hungmap0312/3D-Scanner/docs/logs/c5a_q6_20261004_221728/setup_tren.jpg

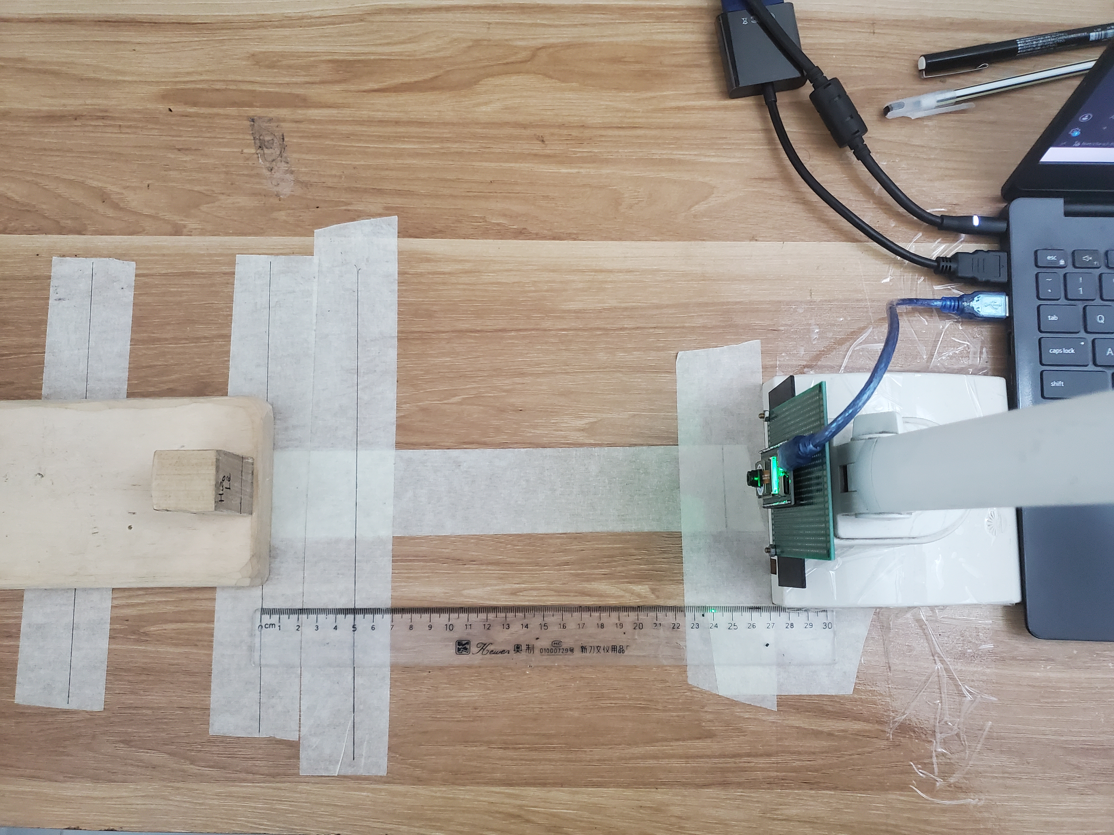
docs/logs/c5a_q6_20261004_221728/setup_tren.jpg
