hungmap0312/3D-Scanner/docs/logs/c5a_q6_rst_20261006_201614/setup.jpg

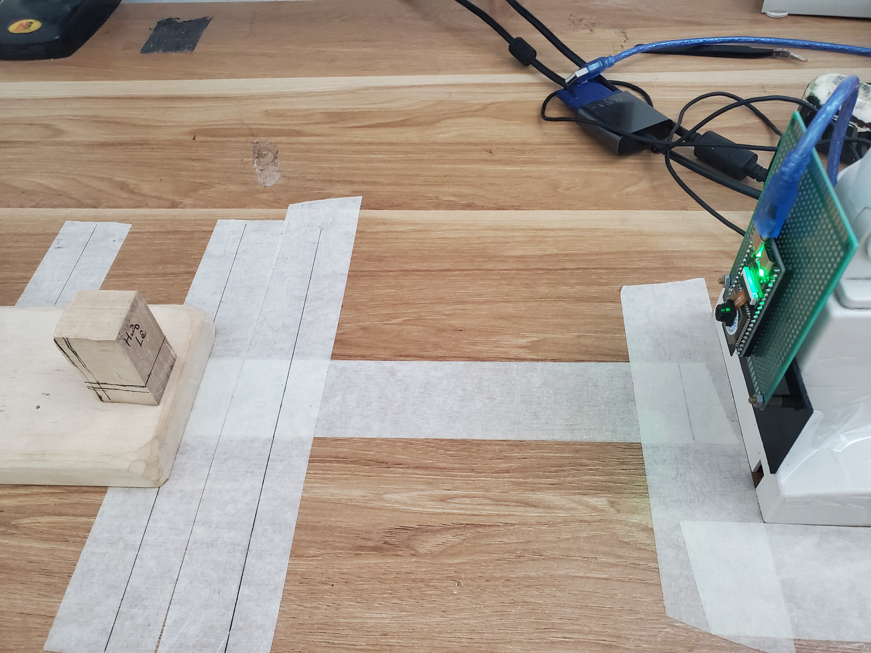
docs/logs/c5a_q6_rst_20261006_201614/setup.jpg
