hungmap0312/3D-Scanner/docs/logs/adapter-12v-3a-nhan-2026-10-11.jpg

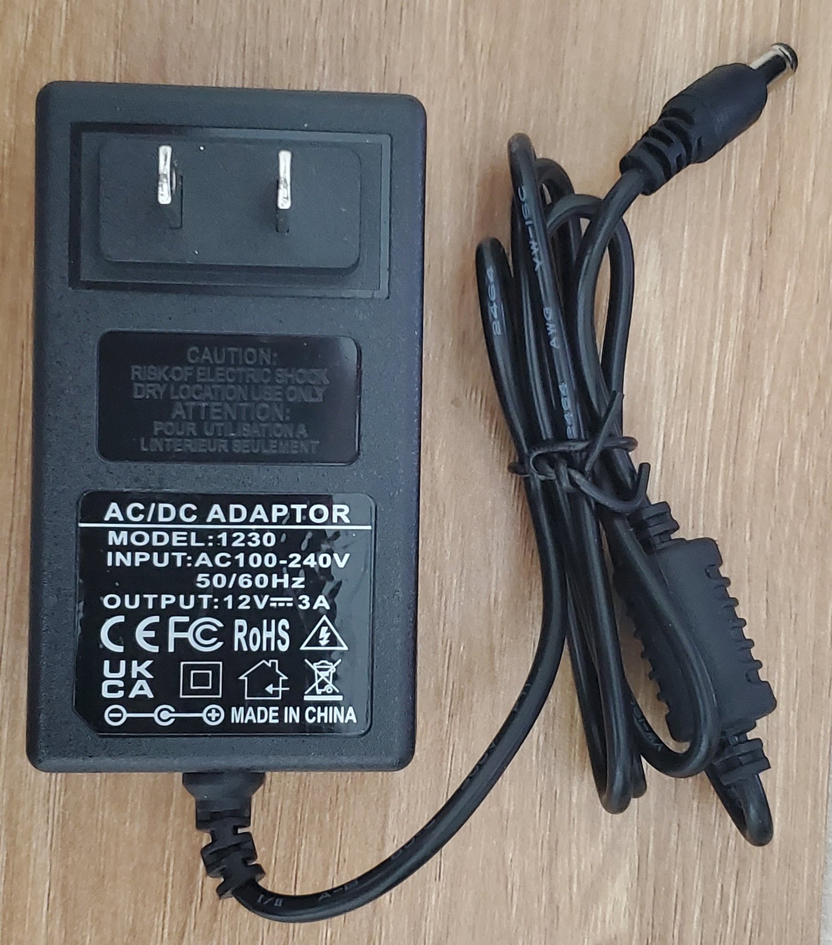
docs/logs/adapter-12v-3a-nhan-2026-10-11.jpg
