hungmap0312/3D-Scanner/docs/logs/arduino-tools-menu-2026-09-16.png

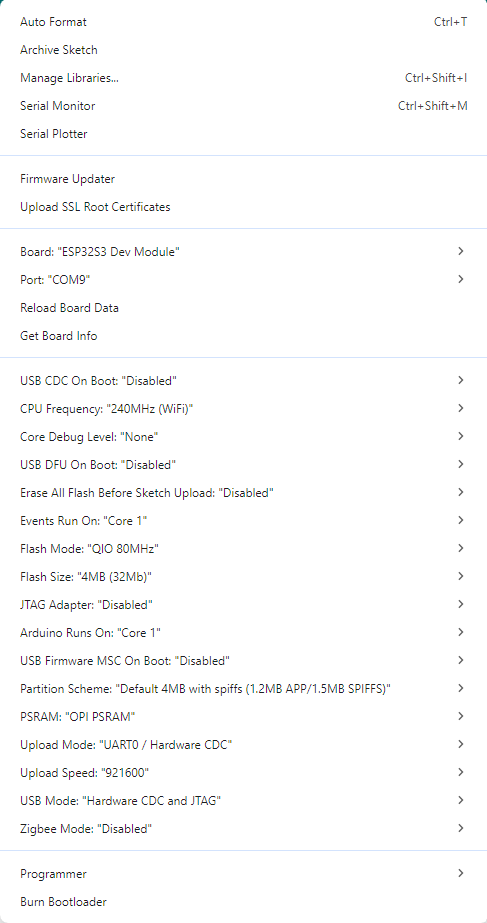
docs/logs/arduino-tools-menu-2026-09-16.png
