hungmap0312/3D-Scanner/docs/logs/buck-xl4005-mat-sau-2026-10-10.jpg

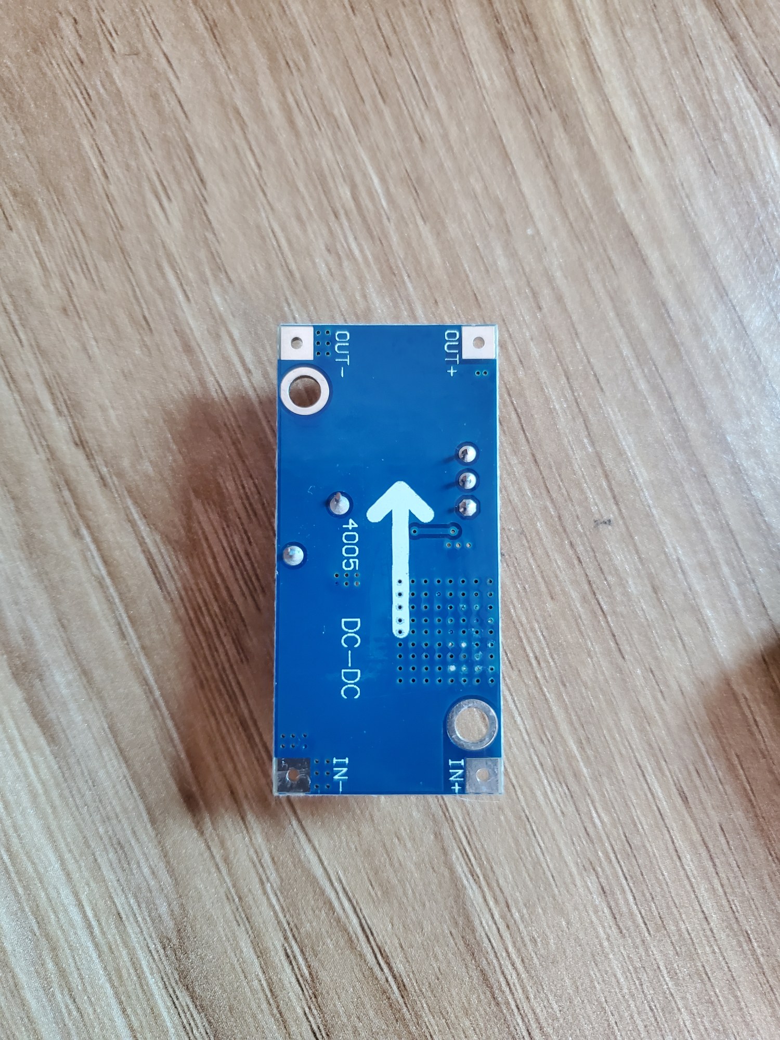
docs/logs/buck-xl4005-mat-sau-2026-10-10.jpg
