hungmap0312/3D-Scanner/docs/logs/buck-xl4005-mat-tren-2026-10-10.jpg

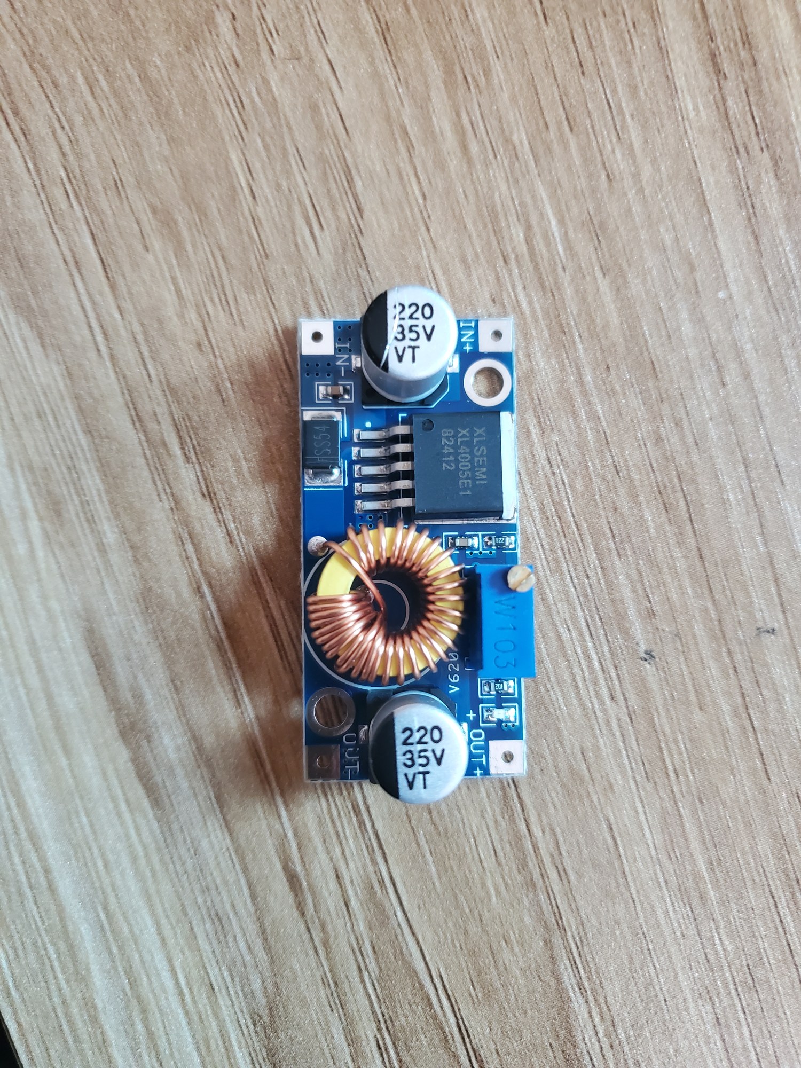
docs/logs/buck-xl4005-mat-tren-2026-10-10.jpg
