hungmap0312/3D-Scanner/docs/logs/c4-t5-2026-10-01/bo-tri-1.png

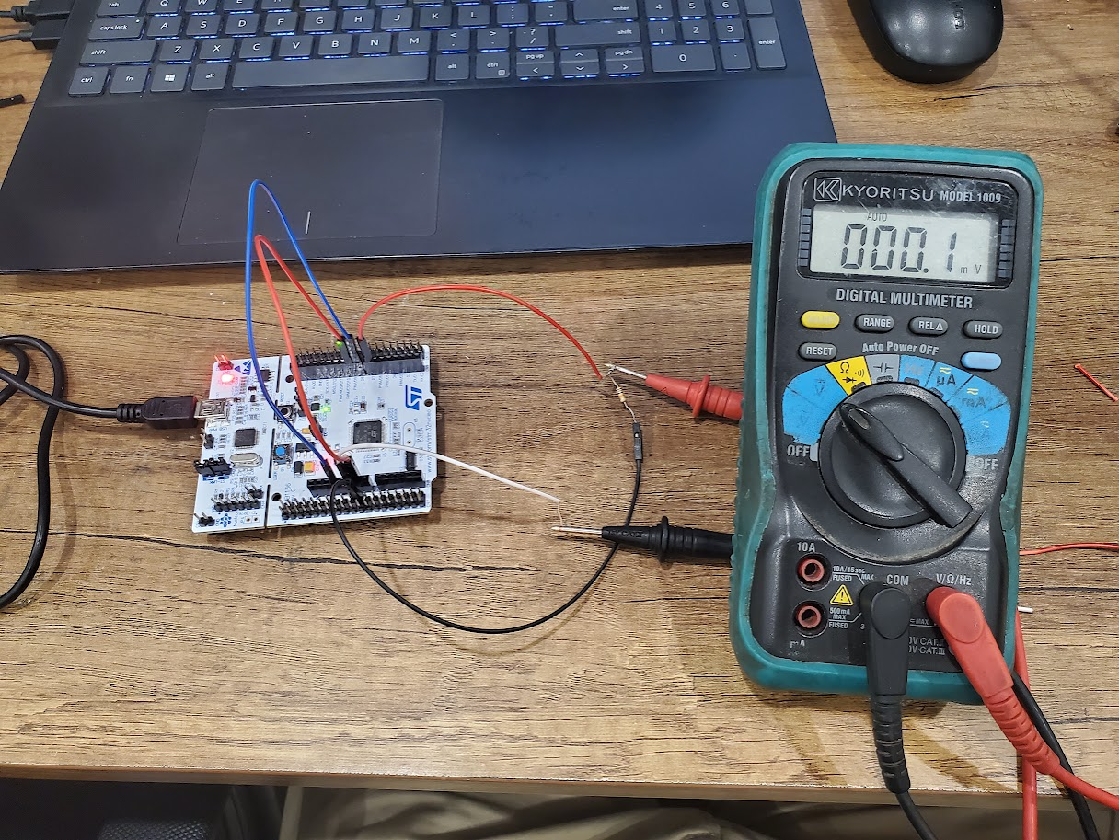
docs/logs/c4-t5-2026-10-01/bo-tri-1.png
