hungmap0312/3D-Scanner/docs/logs/c5a_q6_20261004_221728/probe_q6_t9_run1/frame_0009.jpg

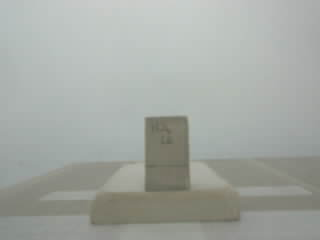
docs/logs/c5a_q6_20261004_221728/probe_q6_t9_run1/frame_0009.jpg
