hungmap0312/3D-Scanner/docs/logs/c5a_q6_20261004_225200/probe_q6_t10_reboot_run2/frame_0002.jpg

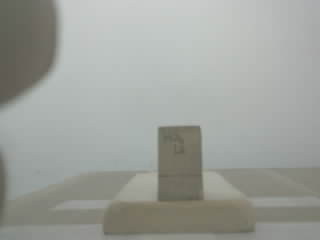
docs/logs/c5a_q6_20261004_225200/probe_q6_t10_reboot_run2/frame_0002.jpg
