hungmap0312/3D-Scanner/docs/logs/c5a_q6_rst_20261006_095924/probe_q6_t10_reboot_run1/frame_0001.jpg

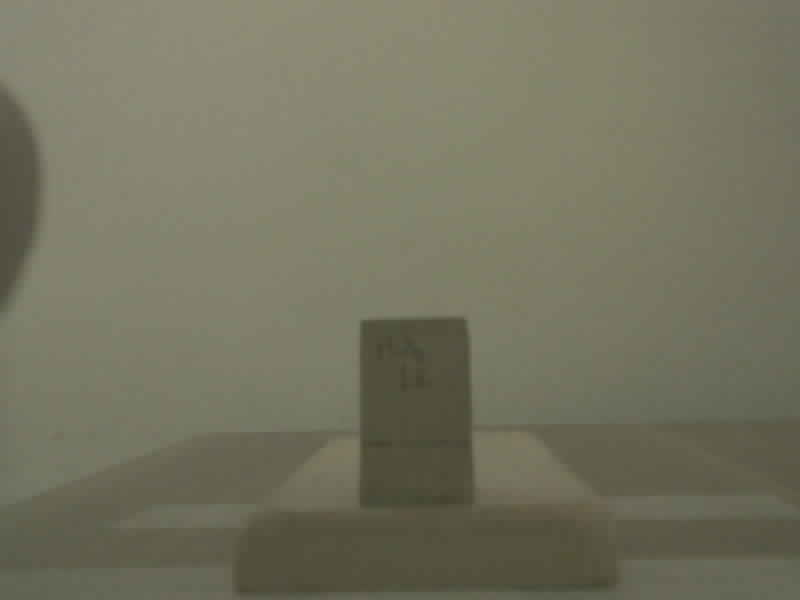
docs/logs/c5a_q6_rst_20261006_095924/probe_q6_t10_reboot_run1/frame_0001.jpg
