hungmap0312/3D-Scanner/docs/logs/c5a_q6_rst_20261006_201614/probe_q6_t10_reboot_run2/frame_0003.jpg

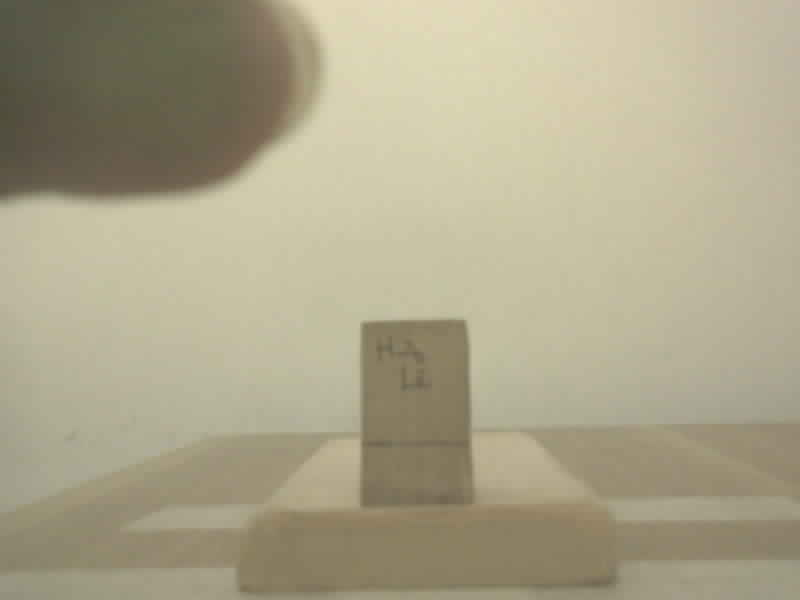
docs/logs/c5a_q6_rst_20261006_201614/probe_q6_t10_reboot_run2/frame_0003.jpg
