hungmap0312/3D-Scanner/docs/logs/c6-v4-ao3400-adapter-can-2026-10-07.png

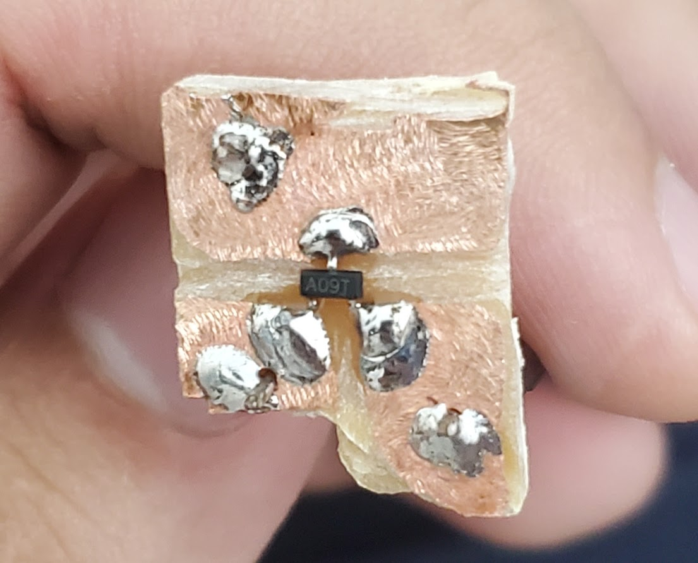
docs/logs/c6-v4-ao3400-adapter-can-2026-10-07.png
