hungmap0312/3D-Scanner/docs/logs/camera-fd5640-mat-sau-2026-09-22.jpg

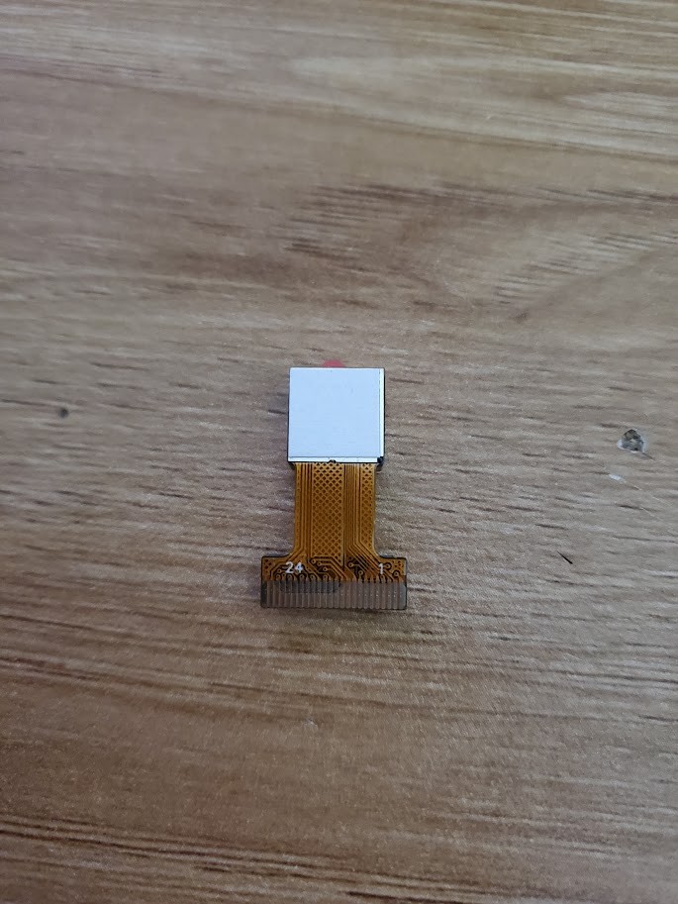
docs/logs/camera-fd5640-mat-sau-2026-09-22.jpg
