hungmap0312/3D-Scanner/docs/logs/esp32s3-ov3660-dau-noi-n0-2026-10-11.jpg

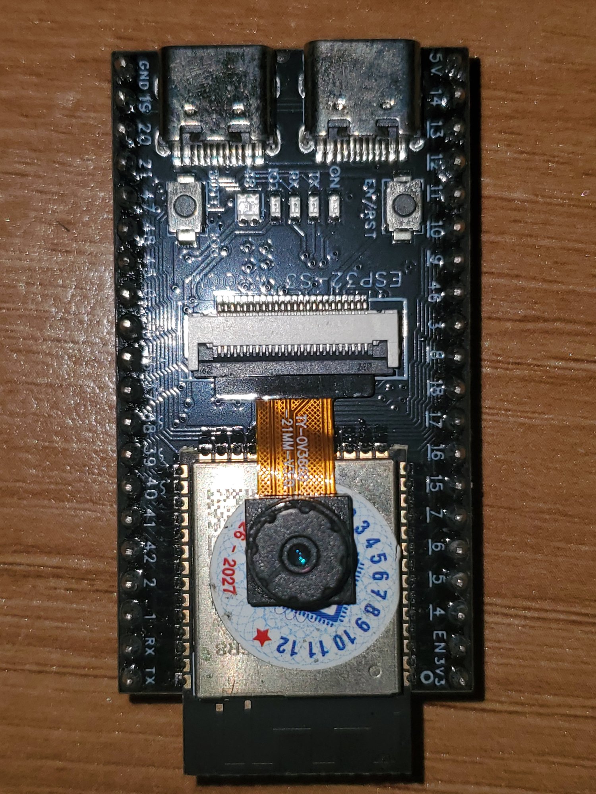
docs/logs/esp32s3-ov3660-dau-noi-n0-2026-10-11.jpg
