hungmap0312/3D-Scanner/docs/logs/estop-la38-vit-11-23-2026-10-12.jpg

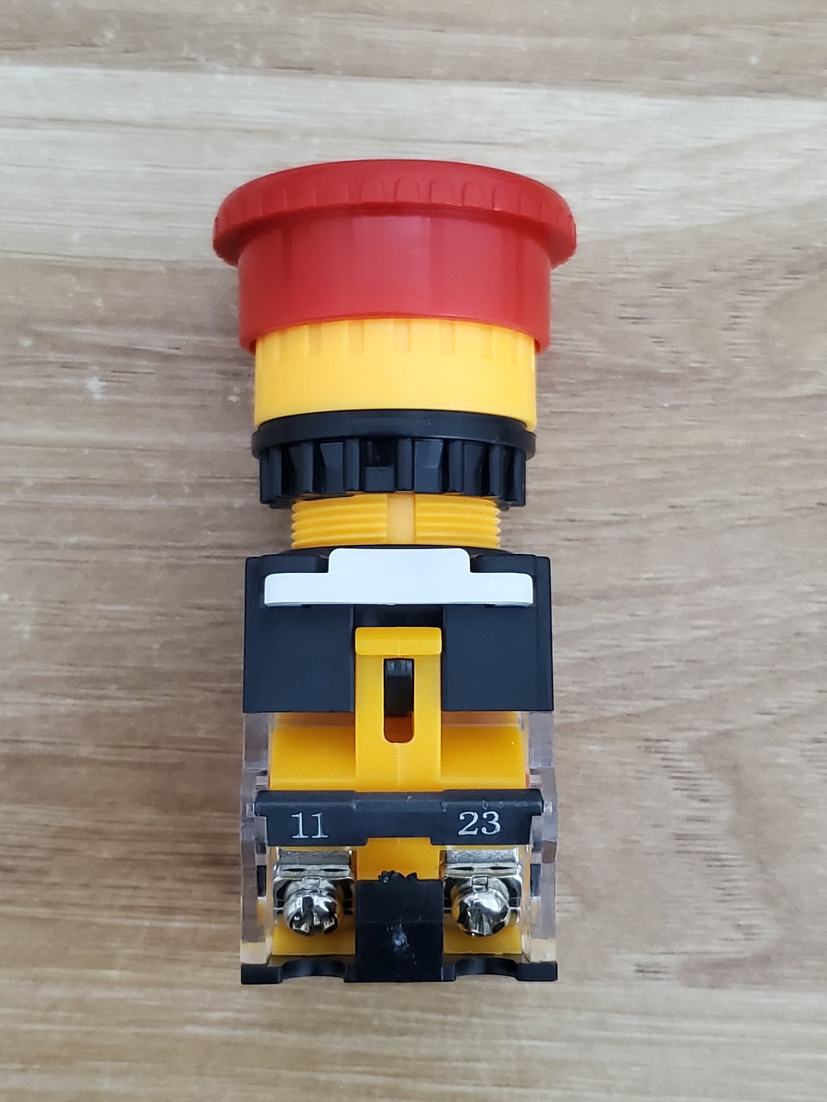
docs/logs/estop-la38-vit-11-23-2026-10-12.jpg
