hungmap0312/3D-Scanner/docs/logs/estop-la38-vit-24-12-2026-10-12.jpg

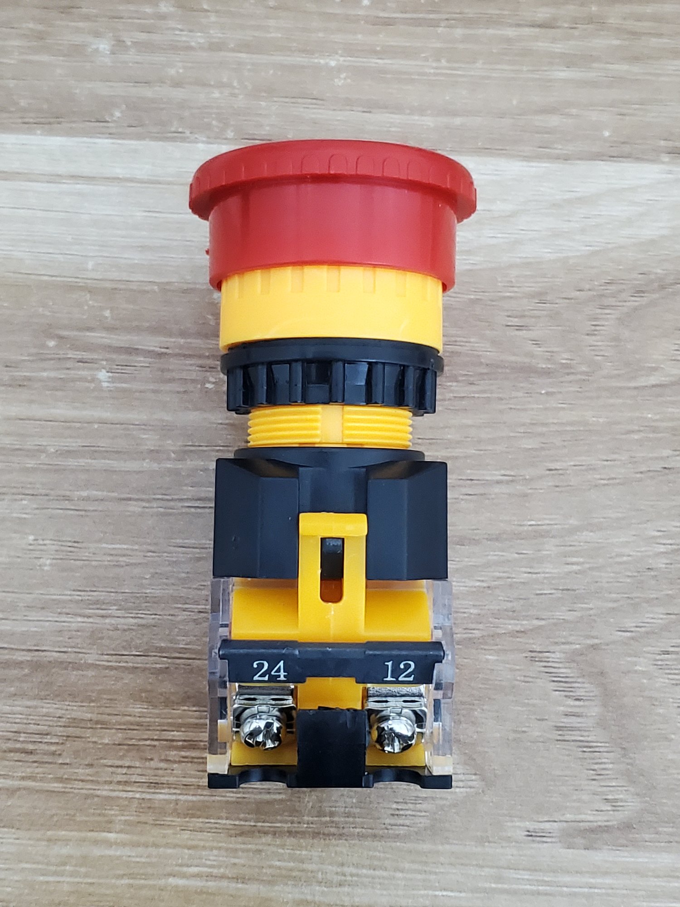
docs/logs/estop-la38-vit-24-12-2026-10-12.jpg
