hungmap0312/3D-Scanner/docs/logs/laser-syd1230-mach-trong-mat-b-2026-10-10.png

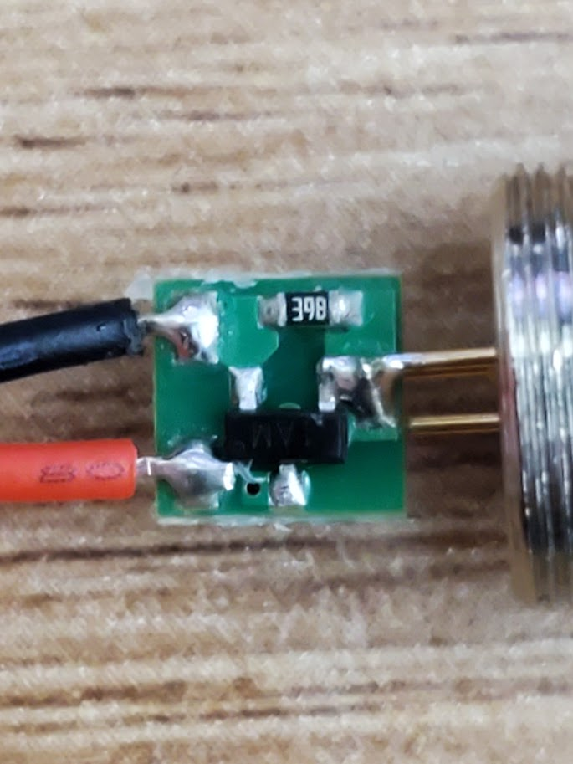
docs/logs/laser-syd1230-mach-trong-mat-b-2026-10-10.png
