hungmap0312/3D-Scanner/docs/logs/laser-syd1230-nhan-2026-09-22.jpg

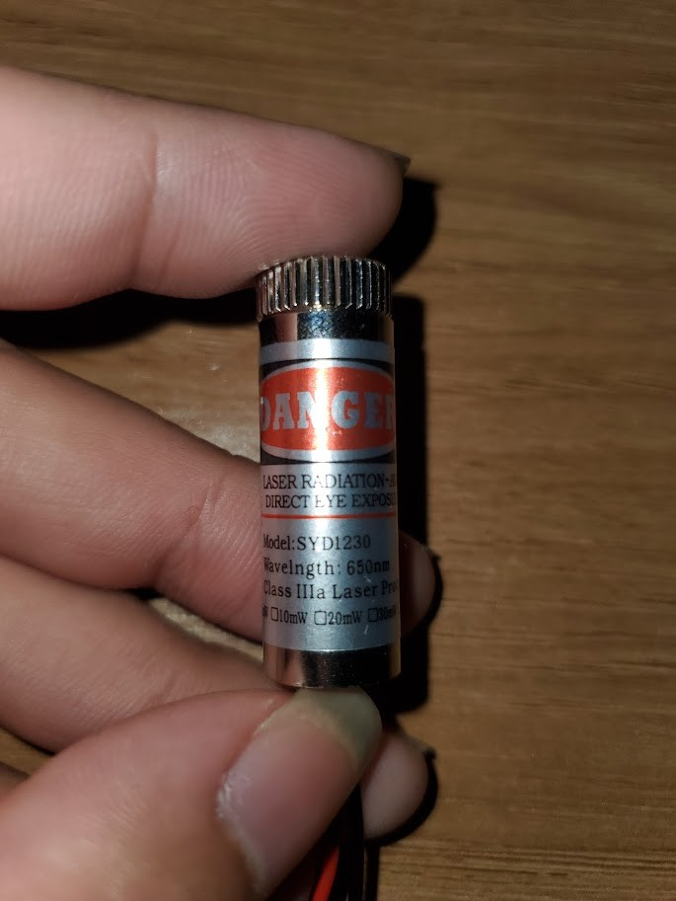
docs/logs/laser-syd1230-nhan-2026-09-22.jpg
