hungmap0312/3D-Scanner/docs/logs/nema17-42hd3401s-mat-bich-2026-10-11.jpg

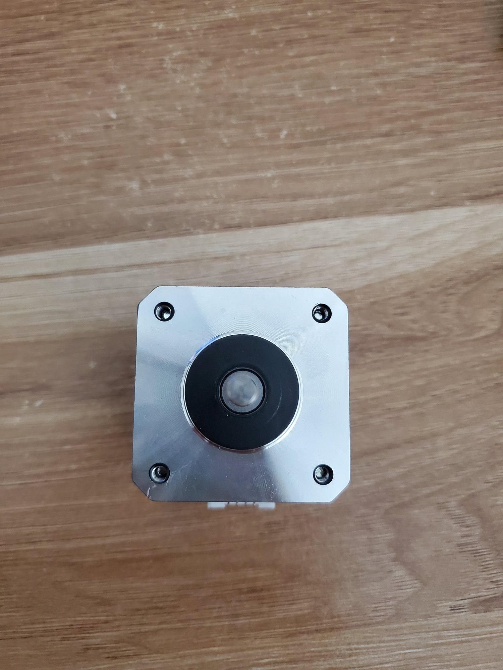
docs/logs/nema17-42hd3401s-mat-bich-2026-10-11.jpg
