hungmap0312/3D-Scanner/docs/logs/nucleo-board-2026-09-16.jpg

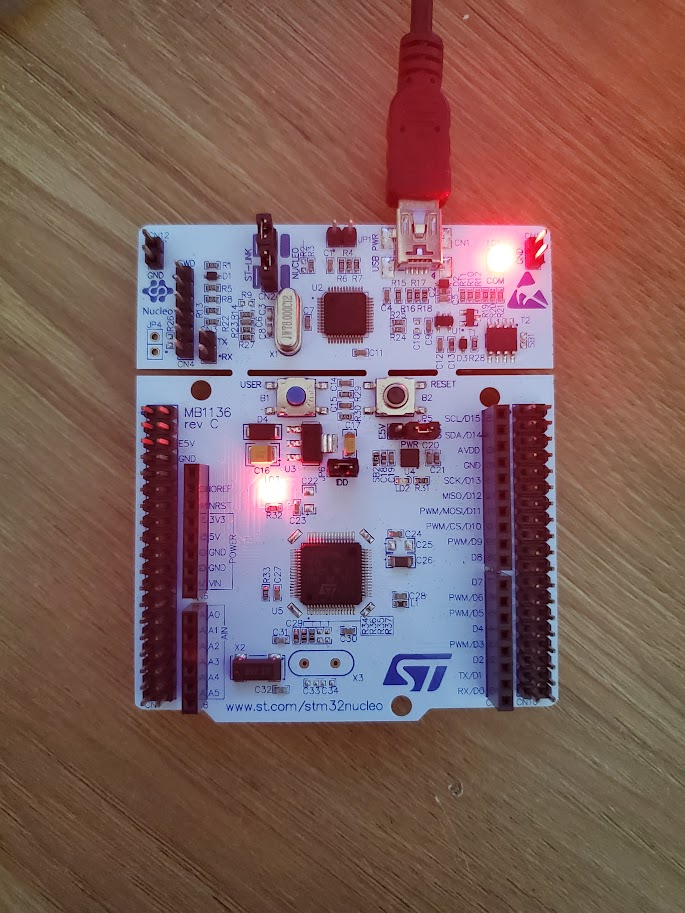
docs/logs/nucleo-board-2026-09-16.jpg
