hungmap0312/3D-Scanner/docs/logs/p03-bo-tri-250mm-2026-10-12.jpg

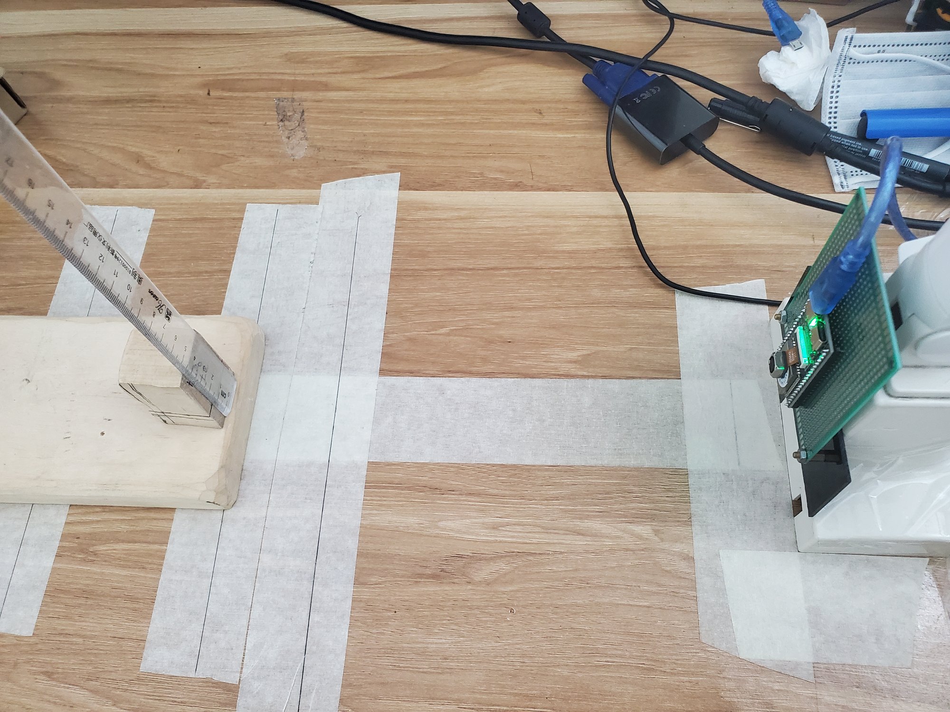
docs/logs/p03-bo-tri-250mm-2026-10-12.jpg
