hungmap0312/3D-Scanner/docs/logs/p03_fd5640/sharpness-v2-fd200/annotated_capture_fd5640_250mm.jpg

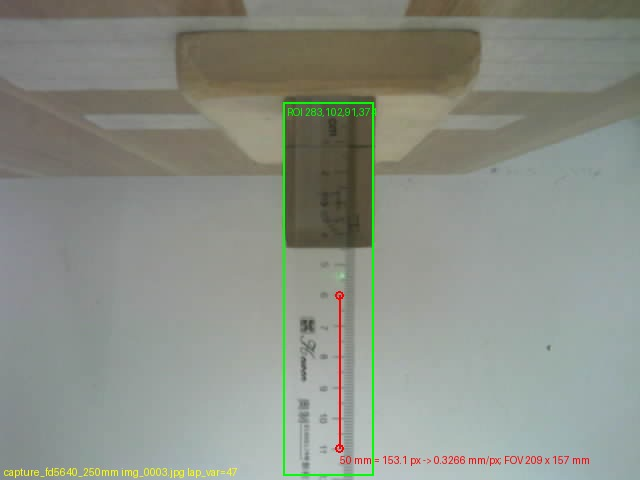
docs/logs/p03_fd5640/sharpness-v2-fd200/annotated_capture_fd5640_250mm.jpg
