hungmap0312/3D-Scanner/docs/logs/p03_fd5640/sharpness-v2-fd250-r1/annotated_capture_p03_fd5640_250mm_r1.jpg

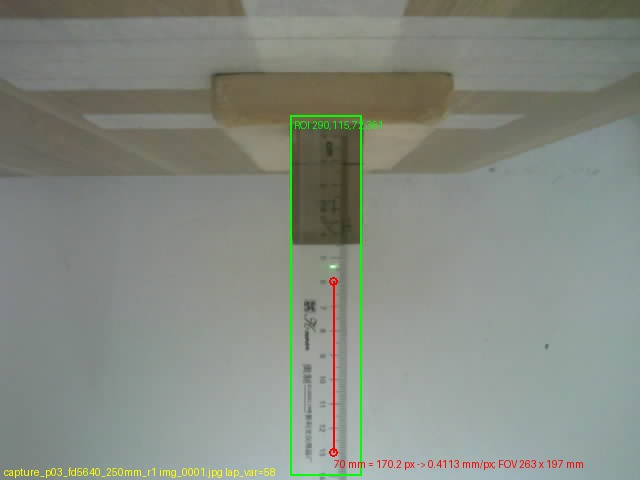
docs/logs/p03_fd5640/sharpness-v2-fd250-r1/annotated_capture_p03_fd5640_250mm_r1.jpg
