hungmap0312/3D-Scanner/docs/logs/p03_fd5640/v3/s2_mm_ticks_fd200.png

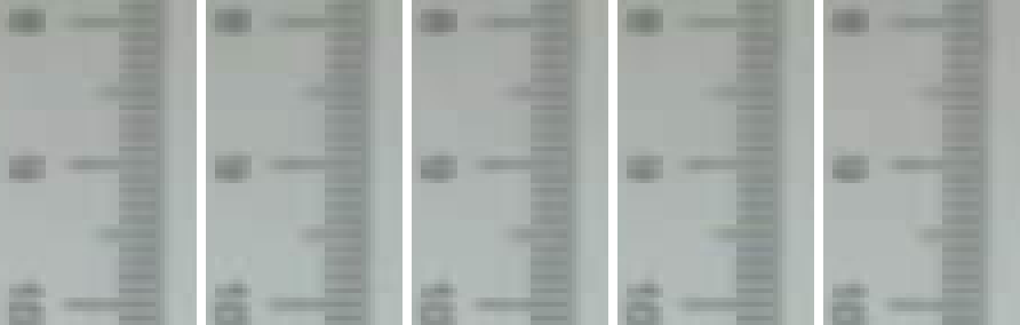
docs/logs/p03_fd5640/v3/s2_mm_ticks_fd200.png
