hungmap0312/3D-Scanner/docs/logs/p03_fd5640/v3/sharpness-v3-fd250-r4/annotated_capture_p03_fd5640_250mm_r4.jpg

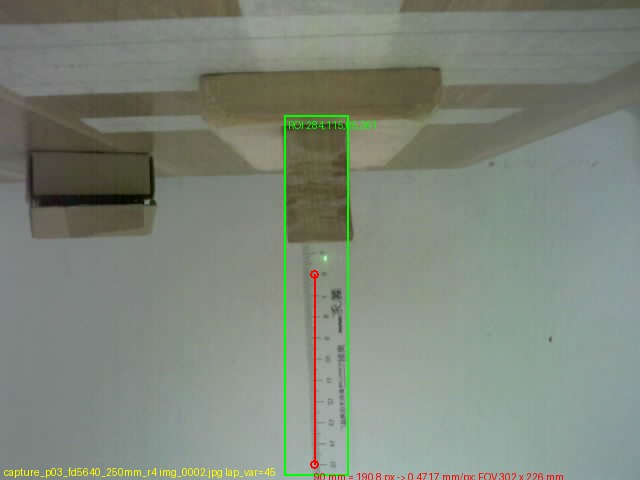
docs/logs/p03_fd5640/v3/sharpness-v3-fd250-r4/annotated_capture_p03_fd5640_250mm_r4.jpg
