hungmap0312/3D-Scanner/docs/logs/quang-hoc-2026-09-17-350mm-img0003.jpg

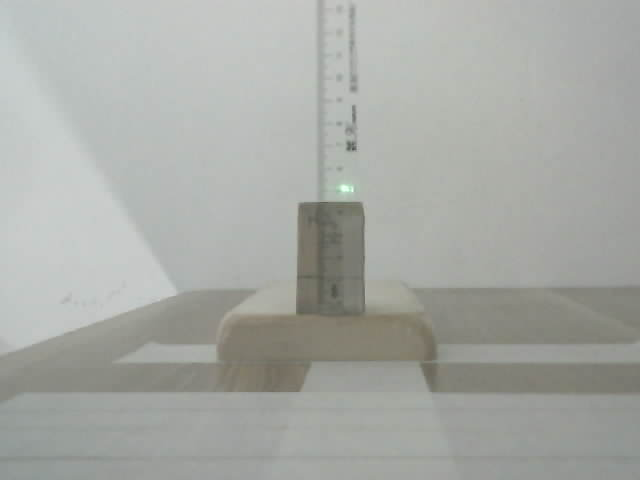
docs/logs/quang-hoc-2026-09-17-350mm-img0003.jpg
