hungmap0312/3D-Scanner/docs/logs/quang-hoc-bo-tri-2026-09-17-200.jpg

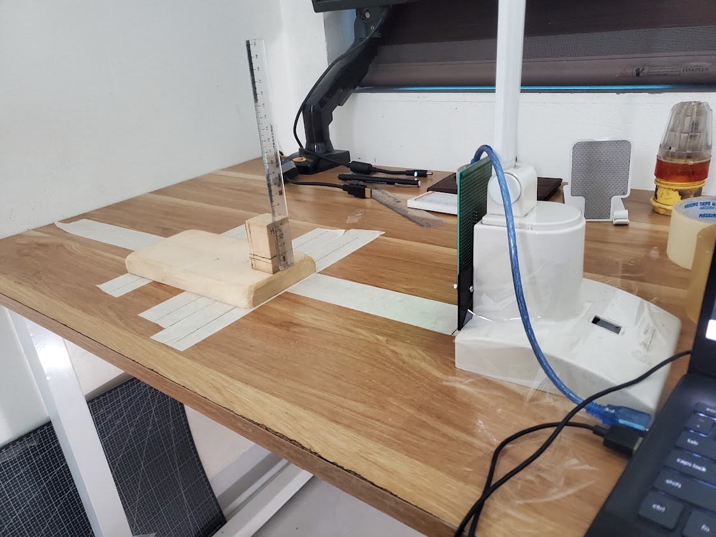
docs/logs/quang-hoc-bo-tri-2026-09-17-200.jpg
