hungmap0312/3D-Scanner/docs/logs/quang-hoc-bo-tri-2026-09-17-250.jpg

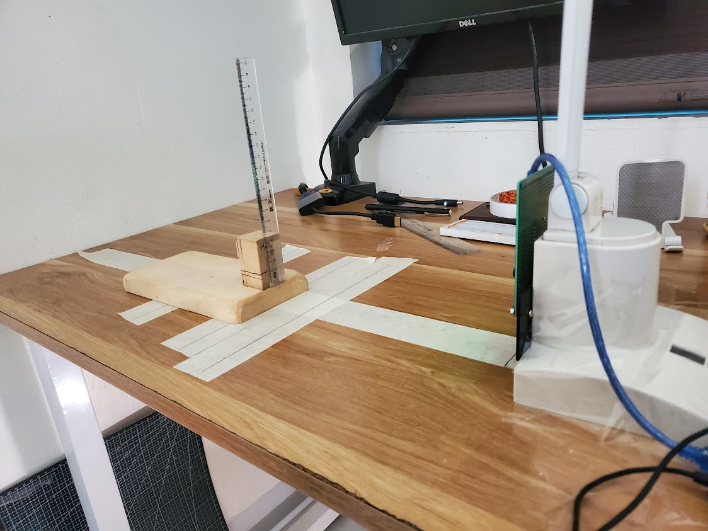
docs/logs/quang-hoc-bo-tri-2026-09-17-250.jpg
