hungmap0312/3D-Scanner/docs/logs/s3-board-back-2026-09-18.jpg

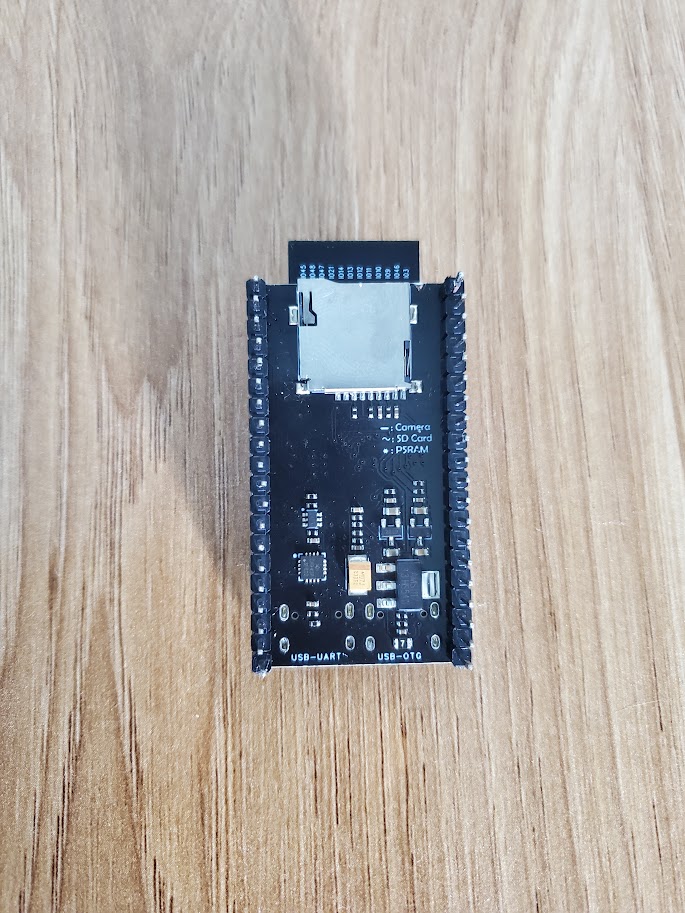
docs/logs/s3-board-back-2026-09-18.jpg
