hungmap0312/3D-Scanner/docs/logs/s3-board-front-2026-09-18.jpg

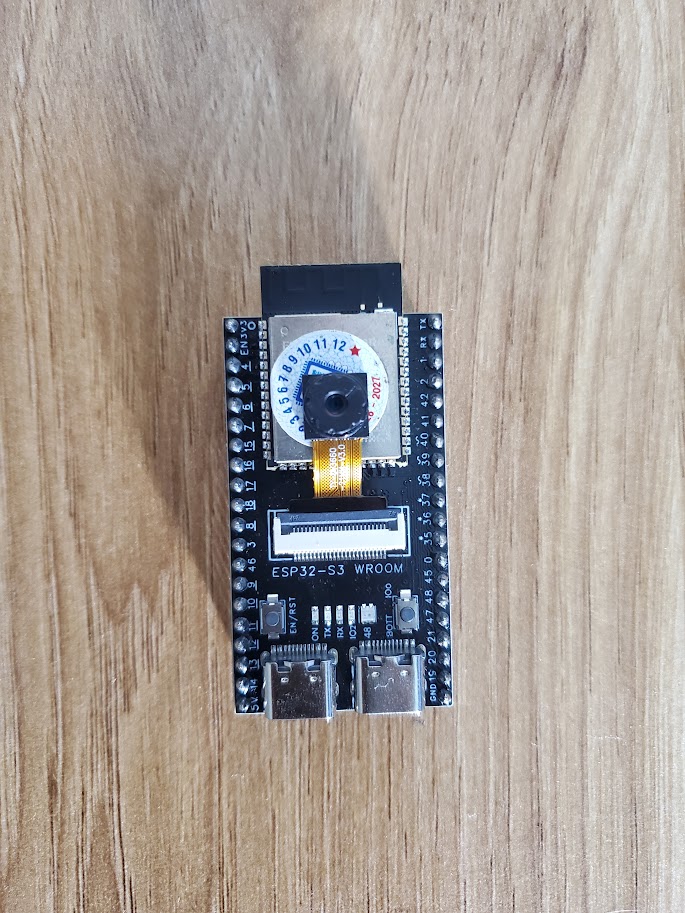
docs/logs/s3-board-front-2026-09-18.jpg
