hungmap0312/3D-Scanner/docs/logs/s3-board-mounted-2026-09-17.jpg

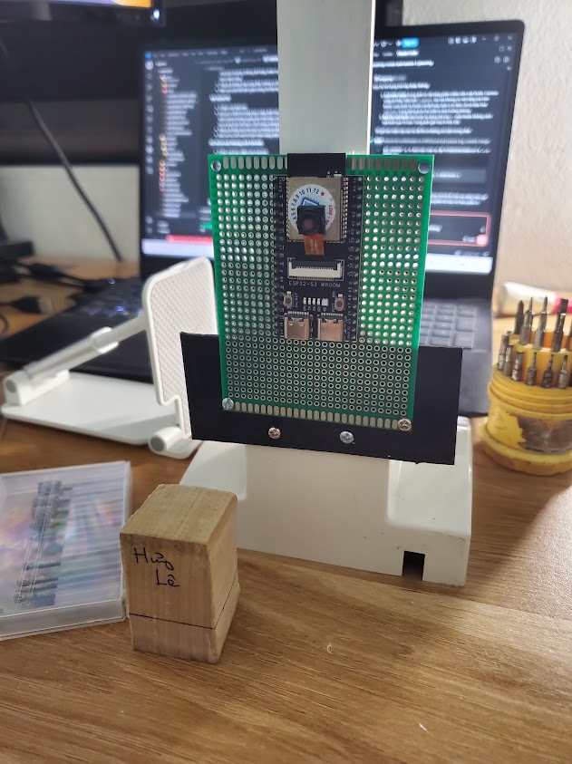
docs/logs/s3-board-mounted-2026-09-17.jpg
