hungmap0312/3D-Scanner/docs/logs/sharpness_20260916_thu_110anh/annotated_capture_20260916_154847.jpg

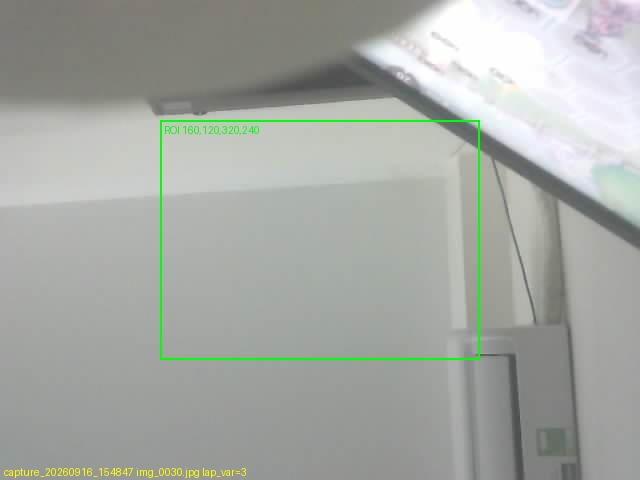
docs/logs/sharpness_20260916_thu_110anh/annotated_capture_20260916_154847.jpg
