hungmap0312/3D-Scanner/docs/logs/sharpness_20260917_quang_hoc/annotated_capture_qh_250mm.jpg

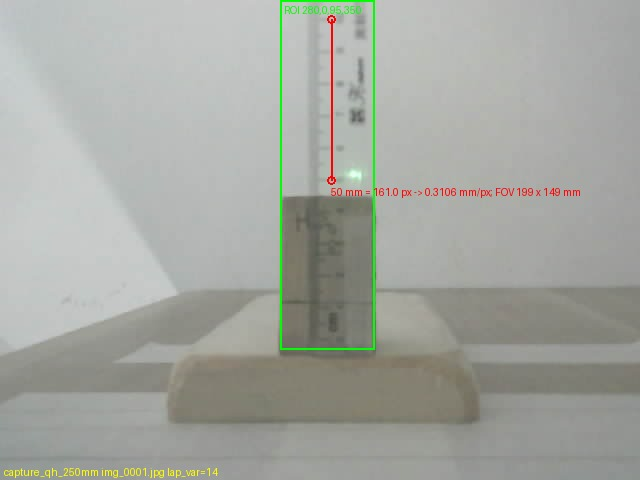
docs/logs/sharpness_20260917_quang_hoc/annotated_capture_qh_250mm.jpg
