hungmap0312/3D-Scanner/docs/logs/tro-2w-120r-2026-10-11.jpg

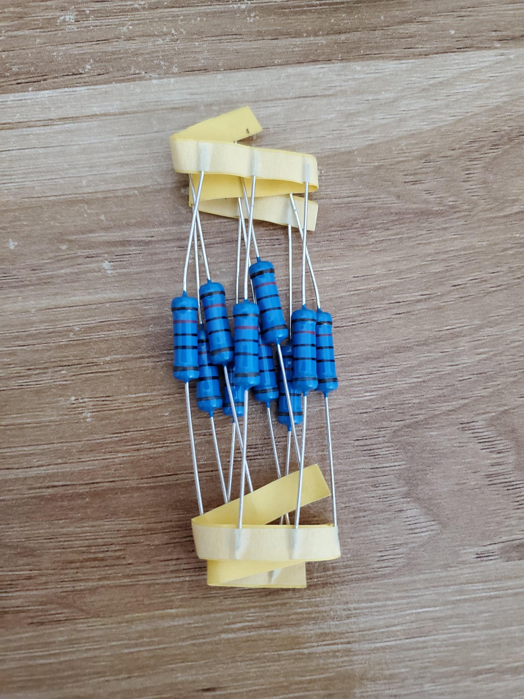
docs/logs/tro-2w-120r-2026-10-11.jpg
