hungmap0312/3D-Scanner/docs/logs/tro-quarterw-15k-2026-10-11.jpg

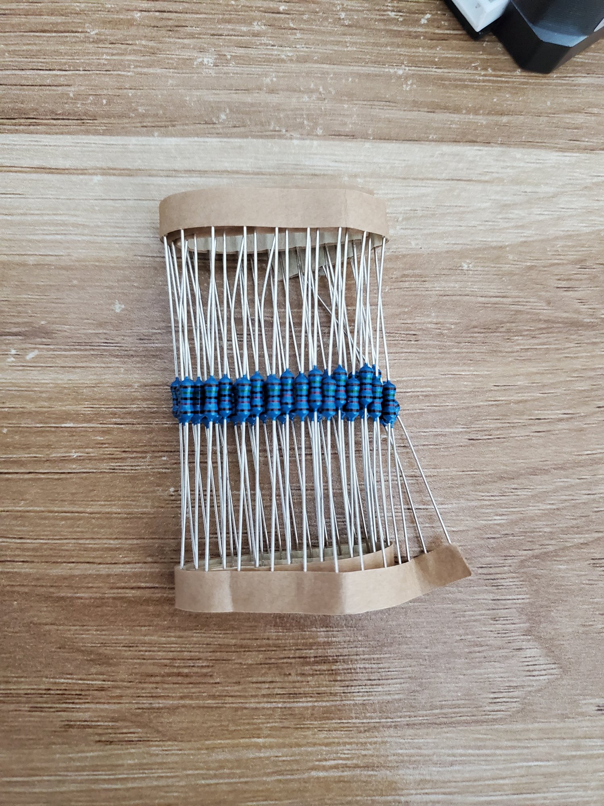
docs/logs/tro-quarterw-15k-2026-10-11.jpg
