hungmap0312/3D-Scanner/docs/reference/esp32-s3-wroom-cam-pinout-nguoi-ban-2026-09-18.webp

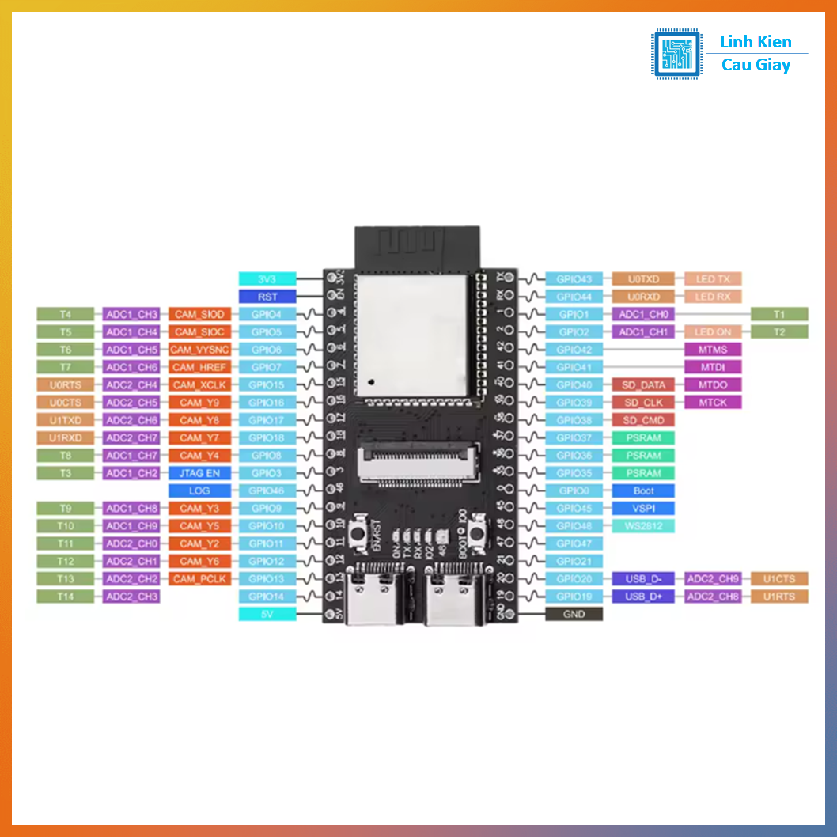
docs/reference/esp32-s3-wroom-cam-pinout-nguoi-ban-2026-09-18.webp
