hungmap0312/3D-Scanner/docs/reference/quy-trinh-rd-phan-cung-phan-mem-2021.png

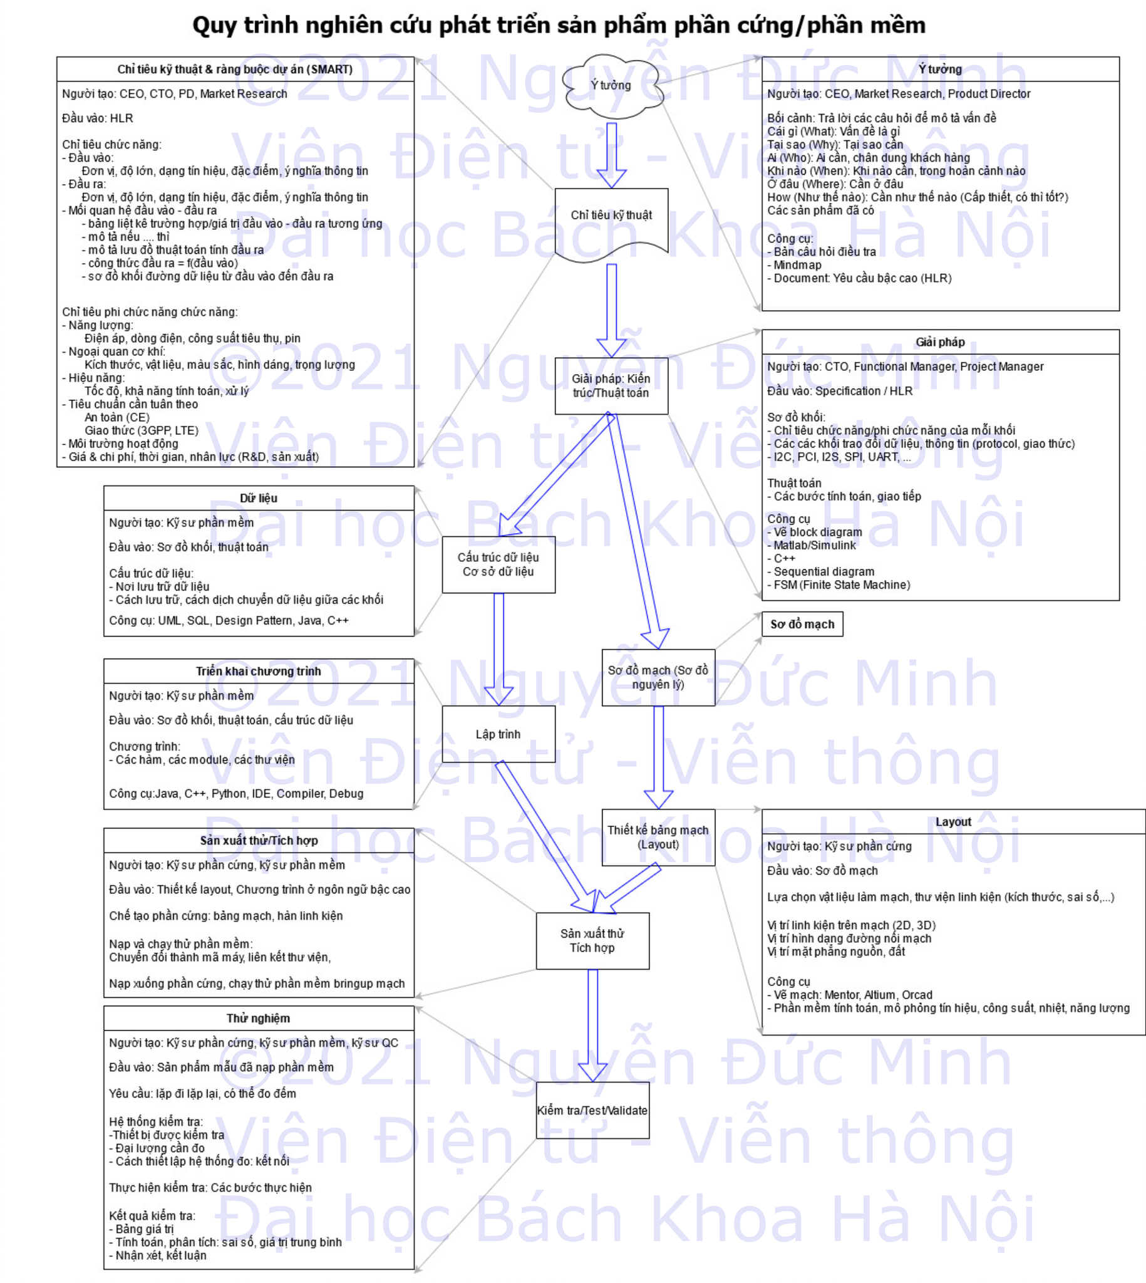
docs/reference/quy-trinh-rd-phan-cung-phan-mem-2021.png
