hungmap0312/3D-Scanner/docs/reference/BOM_may_quet_3D_ESP32_CAM_ESP32_S3.xlsx

Sheet: BOM
BOM máy quét 3D dùng ESP32-CAM / ESP32-S3
 | Cấu hình đang chọn: | ESP32-S3-CAM |  |  |  |  | 14/09/2026
 | Nhóm linh kiện |  |  |  |  | Dự toán (VND)
 | Camera và điều khiển |  |  |  |  | 480000
 | Nguồn điện |  |  |  |  | 250000
 | Cơ khí |  |  |  |  | 840000
 | PCB và hiệu chuẩn |  |  |  |  | 530000
 | Tổng linh kiện |  |  |  |  | 2100000
 | Dự phòng phát sinh |  |  |  | 15% | 315000
 | Vận chuyển dự kiến |  |  |  |  | 80000
 | Tổng ngân sách |  |  |  |  | 2495000
Một laser, đai 3:1, dựng 3D trên laptop. Giá dự toán làm tròn; các giả định/nguồn ở cột K và trang Chon bo.
Sửa SL/đơn giá ô vàng; giá khối camera sửa ở Chon bo. Tổng chưa gồm laptop, dụng cụ hàn/đo và phần tùy chọn.
Mã | Hạng mục | Thông số cần mua | SL | Đơn vị | Đơn giá (đ) | Thành tiền (đ) | Giai đoạn mua | Nguồn giá hoặc cơ sở dự toán; tra cứu ngày 13/09/2026
A01 | ESP32-S3-CAM + OV2640 + lens | S3-CAM N8R8/N16R8, PSRAM 8 MB, đủ OV2640/lens, USB nạp và sơ đồ chân. | 1 | bộ | 300000 | 300000 | 1. Thử ảnh | Nguồn và đơn giá đầu vào tại trang Chon bo.
A02 | Mạch nạp rời | ESP32-CAM: đế MB hoặc CP2102. S3-CAM đã có USB nạp: không mua mạch nạp rời. | 0 | cái | 0 | 0 | 1. Thử ảnh | Có CP2102 sẵn: đặt giá mạch nạp của ESP32-CAM về 0 tại Chon bo!D7.
A03 | Cáp USB truyền dữ liệu | Cáp truyền dữ liệu; đầu cáp khớp đế nạp hoặc USB trên bo S3. | 1 | sợi | 25000 | 25000 | 1. Thử ảnh | Dự toán cáp 25.000 đ; có sẵn cáp phù hợp thì đặt giá cáp ở Chon bo về 0.
A04 | Module laser vạch đỏ | 650 nm, cấp 3–5 V; có mạch hạn dòng. Ưu tiên vạch mảnh tại khoảng quét. | 1 | cái | 35000 | 35000 | 2. Thử vạch | Hshop HS0956: niêm yết 25.000 đ, công suất quảng cáo 5 mW; dự trù 35.000 đ. https://hshop.vn/mat-laser-duong-thang
A05 | Driver A4988 + tản nhiệt | Điều khiển STEP/DIR; VDD 3,3 V, VMOT 12 V; đặt giới hạn dòng theo motor. | 1 | bộ | 35000 | 35000 | 3. Bàn xoay | Đức Huy niêm yết 30.000 đ kèm tản nhiệt; dự trù 35.000 đ. https://dientuduchuy.com/products/a4988-stepper-driver-dieu-khien-dong-co-buoc-co-tan-nhiet
A06 | MOSFET và điện trở | AO3400A; R gate 100 Ω, kéo gate xuống 10 kΩ; thêm R kéo cho STEP/DIR/HOME. | 1 | gói | 20000 | 20000 | 2. Thử vạch | Dự toán kỹ thuật; chưa có báo giá cho đúng cấu hình.
A07 | Công tắc HOME | Microswitch có cần gạt; xác lập vị trí gốc, không đo góc liên tục. | 1 | cái | 10000 | 10000 | 3. Bàn xoay | Dự toán kỹ thuật; chưa có báo giá cho đúng cấu hình.
A08 | Công tắc cửa buồng | Đóng mạch khi cửa đóng; mở cửa ngắt nguồn laser bằng phần cứng. | 1 | cái | 20000 | 20000 | 2. Thử vạch | Dự toán kỹ thuật; chưa có báo giá cho đúng cấu hình.
A09 | Nút dừng tự giữ | Tiếp điểm NC, phù hợp tải DC; ngắt nhánh nguồn động lực/laser. | 1 | cái | 35000 | 35000 | 3. Bàn xoay | Dự toán kỹ thuật; chưa có báo giá cho đúng cấu hình.
B01 | Adapter 12 V / 3 A | Nguồn có vỏ kín, jack DC; cấp động cơ và bộ hạ áp. | 1 | cái | 120000 | 120000 | 2. Thử vạch | Dự toán kỹ thuật; chưa có báo giá cho đúng cấu hình.
B02 | Module hạ áp DC-DC | LM2596 hoặc tương đương; chỉnh 12 V xuống 5 V, kiểm tra tải ≥1 A liên tục. | 1 | cái | 35000 | 35000 | 2. Thử vạch | Dự toán kỹ thuật; chưa có báo giá cho đúng cấu hình.
B03 | Tụ lọc và tụ chống nhiễu | 100 µF/35 V gần VMOT; 470–1000 µF/10 V gần camera; 100 nF tại tải. | 1 | gói | 15000 | 15000 | 2. Thử vạch | Giá là dự toán. Khuyến nghị tụ VMOT từ Pololu: https://www.pololu.com/product/1182
B04 | Jack DC, công tắc, cầu chì | Jack DC khớp adapter; công tắc tổng, đế và cầu chì DC phù hợp dây/tải. | 1 | bộ | 30000 | 30000 | 2. Thử vạch | Dự toán kỹ thuật; chưa có báo giá cho đúng cấu hình.
B05 | Dây điện và vật tư đấu nối | Dây nguồn 22–24 AWG, dây tín hiệu, ống co nhiệt, dây rút; không dẫn dòng motor qua breadboard. | 1 | gói | 50000 | 50000 | 2. Thử vạch | Dự toán kỹ thuật; chưa có báo giá cho đúng cấu hình.
C01 | Động cơ NEMA17 | 1,8°/bước, 4 dây, trục 5 mm; đặt dòng A4988 ban đầu khoảng 0,6–0,9 A/pha rồi kiểm tra. | 1 | cái | 150000 | 150000 | 3. Bàn xoay | Dự toán kỹ thuật; chưa có báo giá cho đúng cấu hình.
C02 | Pulley chủ động GT2 | 20 răng, đai rộng 6 mm, lỗ trục 5 mm; có vít chặn. | 1 | cái | 15000 | 15000 | 3. Bàn xoay | Dự toán kỹ thuật; chưa có báo giá cho đúng cấu hình.
C03 | Pulley bị động GT2 | 60 răng, đai rộng 6 mm, lỗ trục 8 mm; có vít chặn. | 1 | cái | 40000 | 40000 | 3. Bàn xoay | Dự toán kỹ thuật; chưa có báo giá cho đúng cấu hình.
C04 | Đai GT2 vòng kín | Rộng 6 mm; chiều dài chọn sau khi chốt khoảng cách hai trục trong CAD. | 1 | sợi | 25000 | 25000 | 3. Bàn xoay | Dự toán kỹ thuật; chưa có báo giá cho đúng cấu hình.
C05 | Trục bàn xoay | Trục thép trơn Ø8 mm, dài dự kiến 100–150 mm; chốt chiều dài theo thiết kế. | 1 | cái | 20000 | 20000 | 3. Bàn xoay | Dự toán kỹ thuật; chưa có báo giá cho đúng cấu hình.
C06 | Gối bi KFL08 | Lỗ 8 mm; bố trí hai gối cách nhau để đỡ hướng kính và hạn chế lắc trục. | 2 | cái | 25000 | 50000 | 3. Bàn xoay | Dự toán kỹ thuật; chưa có báo giá cho đúng cấu hình.
C07 | Bích gắn mâm | Bích kẹp trục lỗ 8 mm, có lỗ bắt vít lên mâm; không phải khớp nối trục 5–8. | 1 | cái | 25000 | 25000 | 3. Bàn xoay | Dự toán kỹ thuật; chưa có báo giá cho đúng cấu hình.
C08 | Vòng chặn trục + long đen | Hai vòng chặn Ø8 mm; định vị dọc trục theo bản vẽ lắp. | 1 | bộ | 20000 | 20000 | 3. Bàn xoay | Dự toán kỹ thuật; chưa có báo giá cho đúng cấu hình.
C09 | Vòng bi chặn dọc trục | F8-16M hoặc tương đương lỗ 8 mm; cần mặt tựa cứng, giữ đúng thứ tự vòng đệm. | 1 | cái | 30000 | 30000 | 3. Bàn xoay | Dự toán kỹ thuật; chưa có báo giá cho đúng cấu hình.
C10 | Mâm xoay đen nhám | Đường kính khoảng 160 mm, gỗ/mica dày khoảng 6–8 mm; dán phủ mặt đen nhám. | 1 | cái | 45000 | 45000 | 3. Bàn xoay | Dự toán kỹ thuật; chưa có báo giá cho đúng cấu hình.
C11 | Gá động cơ NEMA17 | Gá chữ L có rãnh chỉnh căng đai; kích thước khớp động cơ. | 1 | cái | 30000 | 30000 | 3. Bàn xoay | Dự toán kỹ thuật; chưa có báo giá cho đúng cấu hình.
C12 | Gá camera, laser và gối bi | Tự gia công/in 3D; chỉnh được camera và laser rồi khóa cứng; chưa tính CAD thuê ngoài. | 1 | bộ | 100000 | 100000 | 3. Bàn xoay | Dự toán kỹ thuật; chưa có báo giá cho đúng cấu hình.
C13 | Đế máy cứng | Gỗ/MDF khoảng 400×400 mm, dày 12–15 mm; đặt camera, laser và bàn xoay chung đế. | 1 | tấm | 80000 | 80000 | 3. Bàn xoay | Dự toán kỹ thuật; chưa có báo giá cho đúng cấu hình.
C14 | Vỏ buồng kín và mặt chắn tia | Gỗ/foam PVC không xuyên sáng, trong đen nhám; chiều cao khoảng 350–400 mm, có cửa. | 1 | bộ | 150000 | 150000 | 2. Thử vạch | Dự toán kỹ thuật; chưa có báo giá cho đúng cấu hình.
C15 | Bu lông và phụ kiện lắp | M3/M4, đai ốc, long đen, trụ đỡ, bản lề, chốt cửa và chân cao su. | 1 | gói | 60000 | 60000 | 3. Bàn xoay | Dự toán kỹ thuật; chưa có báo giá cho đúng cấu hình.
D01 | PCB lỗ thử nghiệm | Hàn thử nguồn, MOSFET và đầu nối trước khi đặt PCB chính. | 1 | tấm | 20000 | 20000 | 2. Thử vạch | Dự toán kỹ thuật; chưa có báo giá cho đúng cấu hình.
D02 | PCB điều khiển tự thiết kế | Dự toán một đợt PCB 2 lớp cỡ ≤100×100 mm; chưa gồm sửa bản thứ hai/gia công thuê. | 1 | đợt | 200000 | 200000 | 4. Hoàn thiện | Dự toán kỹ thuật; chưa có báo giá cho đúng cấu hình.
D03 | Socket và đầu nối PCB | Socket khớp bo ESP32-CAM hoặc S3-CAM và A4988; đầu nối motor 4P, laser/HOME/cửa 2P, terminal nguồn. | 1 | gói | 40000 | 40000 | 4. Hoàn thiện | Dự toán kỹ thuật; chưa có báo giá cho đúng cấu hình.
D04 | Bảng hiệu chuẩn bàn cờ | In giấy mờ, dán lên tấm phẳng cứng; đo lại kích thước ô thực sau in. | 1 | bộ | 40000 | 40000 | 1. Thử ảnh | Dự toán kỹ thuật; chưa có báo giá cho đúng cấu hình.
D05 | Thước cặp 150 mm | Dùng đối chứng kích thước; độ chia màn hình không phải độ chính xác. Có thể mượn. | 1 | cái | 180000 | 180000 | 4. Hoàn thiện | Dự toán kỹ thuật; chưa có báo giá cho đúng cấu hình.
D06 | Vật kiểm tra và vật tư cố định | Trụ/khối nhám đo kích thước trước quét, keo dính tháo được; tránh vật bóng/trong. | 1 | bộ | 50000 | 50000 | 4. Hoàn thiện | Dự toán kỹ thuật; chưa có báo giá cho đúng cấu hình.
Linh kiện và dịch vụ tùy chọn, chưa cộng vào ngân sách phía trên
Mã | Hạng mục | Thông số cần mua | SL | Đơn vị | Đơn giá (đ) | Thành tiền (đ) | Giai đoạn mua | Nguồn giá hoặc cơ sở dự toán; tra cứu ngày 13/09/2026
O01 | Module OV2640 thay thế | Cụm camera có lens lấy nét gần; xác nhận đúng FPC, pinout và bo ESP32-CAM. | 1 | cái | 100000 | 100000 | Khi ảnh không nét | Dự toán kỹ thuật; chưa có báo giá cho đúng cấu hình.
O02 | Driver TMC2209 | Dùng thay A4988; kiểm tra pinout, dòng và chế độ standalone. Bỏ tiền A05 khi tính thay thế. | 1 | cái | 100000 | 100000 | Khi cần giảm rung | Dự toán kỹ thuật; chưa có báo giá cho đúng cấu hình.
O03 | Laser thứ hai + gá + MOSFET | Tăng vùng nhìn thấy; phải thêm GPIO và hiệu chuẩn mặt phẳng laser thứ hai. | 1 | bộ | 100000 | 100000 | Sau bản một laser | Dự toán kỹ thuật; chưa có báo giá cho đúng cấu hình.
O04 | STM32F411 + ST-Link | Tách điều khiển chuyển động; còn cần cáp/đầu nối phù hợp. Không cần cho cấu hình cơ bản. | 1 | bộ | 180000 | 180000 | Khi mở rộng IO | Dự toán kỹ thuật; chưa có báo giá cho đúng cấu hình.
O05 | In thử một mô hình 3D | Thuê in vật nhỏ từ STL đã kiểm tra; giá phụ thuộc kích thước và vật liệu. | 1 | lần | 150000 | 150000 | Trình diễn | Dự toán kỹ thuật; chưa có báo giá cho đúng cấu hình.

Sheet: Cau hinh
Cấu hình và điều kiện thử nghiệm
Hạng mục | Cấu hình đề xuất
Vai trò ESP32-CAM | ESP32-CAM hoặc S3-CAM nhận lệnh, quay bàn, bật/tắt laser, chụp và truyền ảnh Wi-Fi. Một bo có thể đủ cho một trục, một laser và HOME.
Vai trò laptop | Lưu ảnh, trích tâm vạch, hiệu chuẩn, tam giác hóa, ghép theo trục quay, lọc điểm, dựng lưới và xuất PLY/STL. Mạng Wi-Fi có sẵn hoặc ESP32 phát AP.
Camera đang có | BOM dùng OV2640 đi kèm bo được chọn. Raspberry Pi Global Shutter Camera đang có không cắm trực tiếp vào ESP32-CAM hoặc ESP32-S3. | https://www.raspberrypi.com/products/raspberry-pi-global-shutter-camera/
Ống kính | Mua bộ có lens sẵn. Thử độ nét ở khoảng 20–30 cm. Khả năng xoay lấy nét tùy cụm lens; không mặc định lens nào cũng tháo/chỉnh được.
Độ phân giải | OV2640 tối đa 1600×1200 ảnh màu. Thử 800×600 trước, sau đó tăng độ phân giải nếu ổn. Giữ cùng chế độ ảnh khi hiệu chuẩn và quét. | https://github.com/espressif/esp32-camera
Chế độ ảnh | JPEG ít nén, PSRAM bật; thử fb_count=1. Tắt stream khi quét, kiểm tra/bỏ khung cũ sau thay đổi trạng thái laser và chờ đủ một chu kỳ ảnh mới. | https://github.com/espressif/esp32-camera
Khóa thông số | Tắt AE, AGC và AWB sau khi chọn thiết lập phù hợp; giữ focus/crop/độ phân giải cố định. Chụp laser tắt và bật với cùng thông số. | https://github.com/espressif/esp32-camera/blob/master/driver/include/sensor.h
Chu trình một góc | Quay tới góc đặt → chờ hết rung → laser tắt, lấy ảnh nền mới → laser bật, lấy ảnh vạch mới → tắt laser → truyền và xác nhận nhận ảnh → quay tiếp.
Xử lý lỗi | Gắn mã lượt quét/góc/trạng thái laser vào ảnh. Mất kết nối hoặc timeout: laser tắt, dừng quét. Sau reset phải về gốc và khởi tạo lượt mới.
Phạm vi khởi đầu | Vật đục, nhám, khoảng 50–100 mm; dáng tương đối đơn giản. OV2640 rolling shutter và JPEG không phù hợp để giữ nguyên cam kết sai số 0,3 mm trước đó.
Đánh giá kết quả | Đo sai số kích thước và độ lặp lại trên mẫu đối chứng. Lấy nét tốt, vạch không cháy sáng và cơ khí ổn định là điều kiện trước khi đặt mục tiêu mm.
Số ảnh | 400 vị trí với ảnh laser tắt/bật tạo 800 ảnh. Một lượt chưa thấy đáy; có thể cần lật vật, quét lượt hai rồi căn chỉnh.
Góc quay | NEMA17 200 bước/vòng, vi bước 1/16 và đai 3:1: 9600 xung/vòng bàn. 400 góc tương ứng 24 xung/góc. Đây là độ phân giải lệnh, không phải độ chính xác góc. | https://www.pololu.com/product/1182
HOME và encoder | Bản cơ bản dùng HOME + đếm bước lệnh, quay chậm một chiều. Không tự nhận biết mọi lần mất bước. Chưa cần AS5600/MPU6050/BH1750.
GPIO dự kiến | Chỉ Ai-Thinker, không microSD: dự kiến GPIO13 STEP, GPIO14 DIR, GPIO2 laser kéo xuống, GPIO15 HOME. Với S3 phải lập sơ đồ chân riêng theo đúng bo; không chép pinout này. | https://raw.githubusercontent.com/espressif/arduino-esp32/master/libraries/ESP32/examples/Camera/CameraWebServer/camera_pins.h
Chân khởi động | Ai-Thinker: GPIO2/15 là strapping, tránh kéo GPIO12 lên, GPIO0 dùng XCLK, GPIO16 thường dùng PSRAM. Với S3 phải kiểm tra chân khởi động, flash/PSRAM và USB theo sơ đồ bo. | https://www.espressif.com/sites/default/files/documentation/esp32_datasheet_en.pdf
Driver và microSD | Không dùng microSD trong cấu hình này. MS1/2/3 và ENABLE của A4988 đặt bằng phần cứng; giữ mô-men khi chụp. START/STOP thường qua giao diện PC. | https://www.pololu.com/product/1182
Nguồn và laser | Cấp nguồn vào chân 5V/USB được nhà sản xuất bo cho phép; GPIO 3,3 V. Laser qua MOSFET, không lấy dòng GPIO. Chung GND nhưng tách đường dòng motor khỏi camera.
Nạp chương trình | ESP32-CAM: MB/CP2102 để nạp; S3: USB nạp trên bo được chọn. Cả hai không mặc định là webcam USB. Tránh cấp song song 5 V USB và buck khi chưa cách ly nguồn.
Buồng chụp | Dùng vỏ không xuyên sáng, chắn tia và phản xạ. Mở cửa ngắt nguồn laser bằng phần cứng. Nhãn công suất của module không chứng minh phân hạng an toàn.
PCB cần tự thiết kế | PCB bo đế nguồn, socket bo xử lý và A4988, MOSFET laser, công tắc cửa, HOME, dừng và đầu nối. Chốt kích thước/chân của bo được mua trước khi đặt PCB.
Hiệu chuẩn bắt buộc | Nội tham số camera, mặt phẳng laser và trục quay. Dùng bàn cờ ở nhiều tư thế; thử phương pháp ước lượng trục từ bảng chuẩn gắn bàn xoay trước.
Mua đợt đầu | Thử ảnh trước: ESP32-CAM + MB + cáp dự toán 275.000 đ; S3-CAM + cáp 325.000 đ. Dùng nguồn USB 5 V đủ dòng và bảng in tạm. Thử vạch trước khi đặt cơ khí/PCB.
Phần có thể mượn | Laptop, nguồn USB thử camera, thước cặp, đồng hồ đo, mỏ hàn và máy hiện sóng phòng lab. Nếu mượn thước cặp thì đặt SL của D05 về 0.
Giới hạn ngân sách | Chi phí công tự thiết kế/lập trình chưa tính; linh kiện cơ khí chung cần hỏi báo giá. Vòng sửa PCB hoặc đổi camera/lens có thể vượt khoản dự phòng.

Sheet: Chon bo
Lựa chọn bo và chi phí khối camera
Đổi cấu hình tại ô D3 của trang BOM. Giá bên dưới là đầu vào có thể sửa.
Cấu hình | Bo + camera (đ) | Mạch nạp (đ) | Cáp USB (đ) | Tổng khối (đ) | Giá tham khảo và điều kiện mua
ESP32-CAM | 200000 | 50000 | 25000 | 275000 | Nshop niêm yết 187.000 đ, báo hết hàng khi tra cứu 13/09/2026. Dự trù bo đủ camera/lens 200.000 đ. https://nshopvn.com/product/mach-thu-phat-wifi-esp32-cam/
ESP32-S3-CAM | 300000 | 0 | 25000 | 325000 | Tuyết Nga niêm yết ESP32-S3 N16R8 OV2640 Type-C 205.000 đ khi tra cứu 14/09/2026. Dự trù 300.000 đ; xác nhận bộ có camera/lens, PSRAM, sơ đồ và USB nạp. https://dientutuyetnga.com/products/esp32-cam-kit-phat-trien-esp32-s3-n16r8-ov2640-typec
Điều kiện dùng đúng cấu hình
Bo S3 cần mua | Bản CAM dùng ESP32-S3-WROOM N8R8 hoặc N16R8, PSRAM 8 MB, đầu nối camera và OV2640 kèm lens. Chọn bo có sơ đồ chân và chân GPIO còn trống cho driver/laser/HOME. |  |  |  | Tài liệu bo tham chiếu Freenove: https://docs.freenove.com/projects/fnk0085/en/latest/
ESP32-S3 DevKit thường | Có thể dùng nếu có PSRAM và đủ chân, nhưng cần thêm module camera, lens và đầu nối đúng pinout. Chip S3 không đồng nghĩa bộ camera đã đầy đủ. |  |  |  | Driver chính thức hỗ trợ ESP32/ESP32-S3 và OV2640: https://github.com/espressif/esp32-camera
ESP32-S3 SuperMini | Không mặc định có PSRAM/đầu nối/đủ chân. Phải kiểm tra đúng phiên bản bo trước khi đưa vào BOM.
Tận dụng CP2102 | Nếu đã có CP2102 phù hợp, đặt ô D7 = 0; bỏ đế nạp ESP32-CAM-MB. Nguồn cấp camera cần đủ dòng, không suy ra từ việc USB-UART nhận cổng COM.
Chất lượng hình học | Đổi ESP32 sang ESP32-S3 với cùng OV2640/lens không tự làm mô hình chính xác hơn. Lợi ích chính là RAM, tài nguyên xử lý và khả năng mở rộng phần cứng.
USB trên bo S3 | Dùng cổng USB hỗ trợ nạp của bo được chọn; có USB không có nghĩa mặc định xuất webcam UVC. BOM cơ bản vẫn truyền ảnh Wi-Fi.
Nguồn điện | GPIO và logic cảm biến ở 3,3 V; bo có chân nguồn 5 V/USB theo sơ đồ của nhà sản xuất. Không cấp 5 V vào GPIO hoặc đường nguồn 3V3.
Nên chọn gì | Mua mới: ưu tiên S3-CAM có PSRAM và đủ camera/lens. Nếu đã có ESP32-CAM: dùng để thử vạch, không cần đổi bo ngay.
