hungmap0312/3D-Scanner/docs/logs/c5a_q6_rst_20261006_095924/setup.jpg

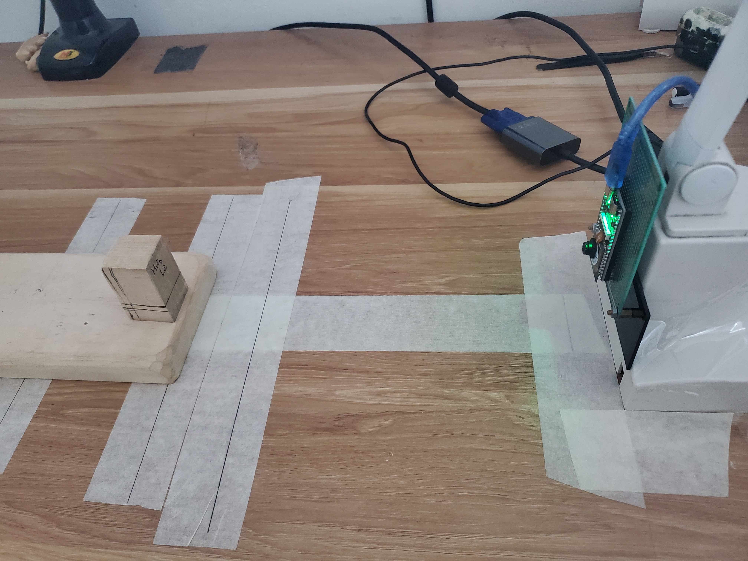
docs/logs/c5a_q6_rst_20261006_095924/setup.jpg
