hungmap0312/3D-Scanner/docs/tests/2026-10-11_p03_fd5640-danh-gia.md

# Báo cáo kiểm tra P03 — Đánh giá camera FD5640 (OV5640) đối chứng OV3660 tại 200 mm và 250 mm (Phần A: S1–S4, Vòng 2)

- **Mã bài kiểm tra:** `P03-FD5640-V3-A` (Thực hiện Phần A theo `handoff/2026-10-09_p03_fd5640-danh-gia/01_PLAN.md` Vòng 3, D080 và xử lý R01–R03 của `04_REVIEW.md` Vòng 1)
- **Ngày chụp dữ liệu:** 2026-10-11 (`capture_fd5640_250mm` [thực tế 200 mm], `capture_fd5640_350mm`, `capture_p03_fd5640_250mm_r1`) và 2026-10-12 (`capture_p03_fd5640_250mm_r2` đến `r6`), đối chứng dữ liệu cơ sở OV3660 ngày 2026-09-17 (`capture_qh_200mm`, `capture_qh_250mm`, `capture_qh_350mm`)
- **Ngày phân tích và cập nhật báo cáo Vòng 2:** 2026-10-12
- **Bước quy trình:** Q9 — Kiểm tra, hiệu chuẩn, đánh giá & lặp lại (`docs/PROCESS.md`)
- **Tài liệu quy định chỉ tiêu:** `docs/SPEC.md` §10.3 (D076, D077, D080) và `handoff/2026-10-09_p03_fd5640-danh-gia/01_PLAN.md` Vòng 3 mục 5
- **Trạng thái bằng chứng:** **ĐÃ QUAN SÁT** trên phần cứng thật (8 phiên FD5640 = 40 ảnh JPEG `640×480` ngày 11–12/10 đối chiếu 3 phiên OV3660 = 15 ảnh ngày 17/09, tổng cộng **55 ảnh**).
- **Tóm tắt kết quả Phần A theo đúng bộ tiêu chí S1–S5 (`docs/SPEC.md` §10.3, D080, `01_PLAN.md` Vòng 3 mục 5):**
  - **S1 (Độ nét — bề rộng mép 10–90% quy ra `mm` ở mặt vật giảm `>= 20%` ở cả `200 mm` [`E200 <= 1.0872 mm` so với `E_OV200 = 1.359 mm`] và `250 mm` [`E250 <= 1.0736 mm` so với `E_OV250 = 1.342 mm`], chấm từng phiên riêng):** **ĐẠT TẠI 200 MM (`fd200 = 0.836 mm`, GIẢM `38.48%`) VÀ ĐẠT Ở 3 PHIÊN `r1–r3` TẠI 250 MM (`0.88`, `1.021`, `1.056 mm`), NHƯNG CHƯA ĐẠT Ở 3 PHIÊN `r4–r6` TẠI 250 MM (`1.561`, `1.362`, `1.425 mm > 1.0736 mm`).** *(Thông tin tham khảo tại `350 mm` — đã bỏ khỏi cổng theo D080: `E350 = 1.145 mm > 0.948 mm`, giảm `3.38%` theo `mm`, giảm `25.65%` theo `px`; `lap_var` trung vị bằng `0.8333x` [`-16.67%`] và `grad_energy` bằng `1.1332x` [`+13.32%`] so với OV3660 lịch sử).*
  - **S2 (Vạch mm — phân biệt đủ `9/9` vạch `1 mm` nội bộ trong `1 cm` trên `5/5` ảnh mỗi phiên chấm tại `200 mm` và `250 mm`):** **CHƯA ĐẠT TẠI CẢ 200 MM VÀ 250 MM** (trên ảnh phóng to `Nearest-Neighbor` giữ nguyên pixel gốc, tại `200 mm` với `3.0629 px/mm` thấy rõ vạch `5 mm` và một số vạch `1 mm` nhưng các vạch liền kề bị nhòe dính vào nhau, không tách rời đủ `9/9` vạch bằng mắt thường trên `5/5` ảnh; tại `250 mm` trên cả 6 phiên `r1–r6` với `2.1145–2.4381 px/mm` chỉ thấy rõ các vạch `1 cm` và vạch `5 mm` ở giữa = `1/9` vạch nội bộ phân biệt được bằng mắt thường).
  - **S3 (Ổn định thu ảnh ngắn hạn — chấm toàn bộ `30/30` ảnh của `r1–r6` tại `250 mm` [cổng tối thiểu `15/15`] và `5/5` ảnh hiện có tại `200 mm`; `0` retry/lỗi/reset bất ngờ trong phiên/trùng hoặc lùi timestamp, đủ `count - 1` phép so timestamp):** **ĐẠT TẠI CẢ 250 MM (`30/30` ẢNH, `24/24` PHÉP SO TIMESTAMP) VÀ 200 MM (`5/5` ẢNH HIỆN CÓ, `4/4` PHÉP SO TIMESTAMP).**
  - **S4 (Tiêu điểm cố định có ghi nhận + độ biến thiên `(max(E_i) - min(E_i)) / median(E_i) <= 10%` trên `15` ảnh cùng bố trí ở mỗi khoảng cách, `E_i` tính bằng `mm`):** **CHƯA ĐẠT TẠI 250 MM (`26.59% > 10%` trên bộ 15 ảnh `r4 + r5 + r6`), CHƯA ĐỦ DỮ LIỆU TẠI 200 MM (mới có `5/15` ảnh = 1/3 phiên).** *(Tại `250 mm`, bộ 15 ảnh cùng bố trí `r4–r6` qua 2 lần khởi động có `E_i` từ `1.3099 mm` đến `1.6887 mm`, trung vị `1.4245 mm`, biến thiên `26.59%` theo `mm` [`26.82%` theo `px`; kiểm nhạy riêng nền tường trắng là `18.49% > 10%`]. Truy nguyên từng phiên đơn lẻ: `r1=4.21%`, `r2=5.22%`, `r3=3.11%`, `r4=17.52%`, `r5=11.46%`, `r6=13.53%`; cặp `r2+r3` 10 ảnh cùng lần khởi động có biến thiên `5.3%` theo `mm` nhưng chỉ có 10/15 ảnh).*
  - **S5 (Chỉ báo tăng nhiệt lõi chip ESP32-S3 tương đối — đồng bộ `p15` Vòng 2):** **CHƯA ĐO — CHỜ ĐẦU VIỆC P15 QUA CỔNG REVIEWER/BO** (`handoff/2026-10-11_p15_nhiet-esp32s3-chi-bao`; **nhiệt độ bề mặt module camera/ổn áp luôn `CHƯA ĐO`**).

---

## 1. Mục tiêu, phạm vi và quy tắc tái tạo số liệu (Xử lý R01–R03)

1. **Mục tiêu và phạm vi theo D080 & `01_PLAN.md` Vòng 3:**
   - Đánh giá định lượng mô-đun camera thử nghiệm **FD5640 500W-V11 (cảm biến OV5640, `PID = 0x5640`)** đối chứng với camera gốc **OV3660 (`PID = 0x3660`, dữ liệu cơ sở ngày 2026-09-17)** ở cùng cấu hình `VGA 640×480`, `jpeg_quality = 10`, tắt stream, tại hai khoảng cách làm việc chính thức **200 mm và 250 mm** (kết quả tại **350 mm** được giữ lại làm thông tin tham khảo và đính chính nhận xét theo R02, nhưng **không là cổng** theo D080).
   - Báo cáo này thực hiện **Phần A (S1–S4)** tại mốc `B_A` Vòng 2; **Phần B (S5 — chỉ báo tăng nhiệt chip ESP32-S3)** đã đồng bộ hợp đồng dữ liệu với `p15` Vòng 2 và chờ `p15` qua cổng Reviewer.
2. **Quy tắc tái tạo tự động — Không gõ số tay (Xử lý triệt để R01, R02, R03 của `04_REVIEW.md` Vòng 1):**
   - Mọi bảng số liệu trong báo cáo này (bảng manifest 55 ảnh, bảng tổng hợp 11 phiên, bảng S1, S2, S3, S4 và bảng đối chứng lịch sử 17/09) đều được sinh trực tiếp bằng lệnh Python từ các tệp nguồn: `frames.csv`, `summary.txt`, `session.json`, `status_start.json`, `status_after_set.json`, `status_end.json`, `docs/logs/ruler-ticks-2026-09-17-qh{200,250,350}.json`, `docs/logs/sharpness_20260917_quang_hoc/summary.json`, và các tệp đầu ra CLI trong `docs/logs/p03_fd5640/v3/`.
   - Hai tệp tổng hợp lưu trong Git để Reviewer đối chiếu bằng một lệnh: `docs/logs/p03_fd5640/v3/manifest_images_sha256.{json,csv}` (55 ảnh) và `docs/logs/p03_fd5640/v3/summary_comparison_v3.json`.

---

## 2. Đính chính khoảng cách (Errata) và chọn bộ ảnh theo `01_PLAN.md` Vòng 3

| Nhãn báo cáo | ID phiên (`session_id`) | Thời điểm bắt đầu (`started_at`) | Khoảng cách ghi trong `session.json` | Khoảng cách thực tế | Nguồn xác nhận / đính chính | Vai trò trong đánh giá P03 (theo D080 & PLAN Vòng 3 mục 2) |
| :--- | :--- | :--- | :---: | :---: | :--- | :--- |
| `fd200` | `capture_fd5640_250mm` | `2026-10-11T16:31:21.636+07:00` | `250 mm` | **200 mm** | Đính chính người dùng ngày 2026-10-12: thực tế chụp ở 200 mm (01_PLAN.md Vòng 2 mục 1.2 & Vòng 3 mục 2) | Chính thức S1–S3 tại 200 mm (1 phiên = 5 ảnh; S4 tại 200 mm cần 3 phiên mới r1-r3) |
| `fd250_r1` | `capture_p03_fd5640_250mm_r1` | `2026-10-11T19:28:44.428+07:00` | `250 mm` | **250 mm** | Không đính chính — khớp khai báo 250 mm ngày 2026-10-11 | Chính thức S1–S3 tại 250 mm (r1, boot 0; 5/30 ảnh S3) |
| `fd250_r2` | `capture_p03_fd5640_250mm_r2` | `2026-10-12T23:09:58.951+07:00` | `250 mm` | **250 mm** | Không đính chính — khớp khai báo 250 mm ngày 2026-10-12 | Chính thức S1–S3 tại 250 mm (r2, boot 1 cùng r3; 5/30 ảnh S3) |
| `fd250_r3` | `capture_p03_fd5640_250mm_r3` | `2026-10-12T23:11:31.211+07:00` | `250 mm` | **250 mm** | Không đính chính — khớp khai báo 250 mm ngày 2026-10-12 | Chính thức S1–S3 tại 250 mm (r3, boot 1 cùng r2; 5/30 ảnh S3) |
| `fd250_r4` | `capture_p03_fd5640_250mm_r4` | `2026-10-12T23:28:14.664+07:00` | `250 mm` | **250 mm** | Không đính chính — khớp khai báo 250 mm ngày 2026-10-12 | Chính thức S1–S4 tại 250 mm (r4, boot 2; 5/30 ảnh S3, 5/15 ảnh bộ S4 r4–r6) |
| `fd250_r5` | `capture_p03_fd5640_250mm_r5` | `2026-10-12T23:32:45.651+07:00` | `250 mm` | **250 mm** | Không đính chính — khớp khai báo 250 mm ngày 2026-10-12 | Chính thức S1–S4 tại 250 mm (r5, boot 3 cùng r6; 5/30 ảnh S3, 5/15 ảnh bộ S4 r4–r6) |
| `fd250_r6` | `capture_p03_fd5640_250mm_r6` | `2026-10-12T23:34:15.766+07:00` | `250 mm` | **250 mm** | Không đính chính — khớp khai báo 250 mm ngày 2026-10-12 | Chính thức S1–S4 tại 250 mm (r6, boot 3 cùng r5; 5/30 ảnh S3, 5/15 ảnh bộ S4 r4–r6) |
| `fd350` | `capture_fd5640_350mm` | `2026-10-11T19:11:39.804+07:00` | `350 mm` | **350 mm** | Không đính chính — khớp khai báo 350 mm ngày 2026-10-11 | Thông tin tham khảo tại 350 mm (D080 bỏ 350 mm khỏi cổng) |
| `qh200` | `capture_qh_200mm` | `2026-09-17T13:34:50.406+07:00` | `200 mm` | **200 mm** | Dữ liệu lịch sử ngày 2026-09-17 | Đối chứng lịch sử OV3660 tại 200 mm (5 ảnh) |
| `qh250` | `capture_qh_250mm` | `2026-09-17T13:38:57.431+07:00` | `250 mm` | **250 mm** | Dữ liệu lịch sử ngày 2026-09-17 | Đối chứng lịch sử OV3660 tại 250 mm (5 ảnh) |
| `qh350` | `capture_qh_350mm` | `2026-09-17T13:41:26.733+07:00` | `350 mm` | **350 mm** | Dữ liệu lịch sử ngày 2026-09-17 | Đối chứng lịch sử OV3660 tại 350 mm (5 ảnh, thông tin tham khảo) |

- **Giải thích chọn bộ ảnh ở `250 mm` và `200 mm` (`01_PLAN.md` Vòng 3 mục 2):**
  - **Tại `250 mm`:** Tiêu chí **S3** chấm toàn bộ **6 phiên `r1–r6` (30/30 ảnh)**, không bỏ lượt có độ trễ cao hay lượt có `heap_internal_free_bytes` thay đổi. Tiêu chí **S1 và S2** chấm riêng từng phiên hợp lệ (`r1` đến `r6`), không chọn phiên đẹp nhất để đại diện. Tiêu chí **S4** tại `250 mm` dùng bộ **15 ảnh `r4 + r5 + r6`** vì người dùng xác nhận cùng một bố trí cố định (ảnh bố trí `docs/logs/p03-bo-tri-250mm-2026-10-12.jpg`; `r4` thuộc một lần khởi động, `r5 + r6` thuộc lần khởi động kế tiếp; tính trên cả bộ 15 ảnh bao gồm bước chuyển qua khởi động, không tách để che độ trôi; không chọn `r2 + r3` làm kết luận S4 vì chỉ có 10 ảnh, và không ghép `r1/r2/r3` với `r4–r6` vì bố trí giữa hai cụm có thay đổi như ghi nhận ở mục 6.1).
  - **Tại `200 mm`:** Phiên `capture_fd5640_250mm` (nhãn `fd200`, 5 ảnh) thực tế chụp ở `200 mm` theo đính chính của người dùng ngày 12/10 (`00_DIEU_PHOI.md`), giữ nguyên tên thư mục, ảnh raw và `session.json`. Năm ảnh này đủ để chấm **S1, S2** và **1 phiên S3** tại `200 mm`. Riêng **S4 tại `200 mm`** cần bộ 3 phiên lặp × 5 ảnh = 15 ảnh cùng bố trí (`capture_p03_fd5640_200mm_r1`…`r3`); không ghép 5 ảnh `fd200` cũ vào bộ mới vì bố trí đã chuyển sang `250 mm` sau đó, nên S4 tại `200 mm` hiện có trạng thái **`CHƯA ĐỦ DỮ LIỆU`**.

---

## 3. Thiết bị, cấu hình, đối chiếu mã nguồn và log Serial (Xử lý R03)

### 3.1. Thông tin bo mạch và cảm biến theo đúng hồ sơ (`ENVIRONMENT.md`, `docs/HARDWARE.md`)

- **Module trên bo:** `ESP32-S3-WROOM-1-N16R8` (đọc từ nắp kim loại trên ảnh thực tế và xác nhận trong `ENVIRONMENT.md` mục 3, `docs/HARDWARE.md` mục 1).
- **Bộ nhớ đã quan sát qua `esptool` và Serial:** Flash **16 MB** (`16384 KB`), PSRAM **8 MB** (`8192 KB`, chế độ `OPI PSRAM`). *(Đính chính R03: báo cáo Vòng 1 ghi nhầm là `Freenove ESP32-S3 WROOM CAM (N8R8, 8 MB Flash)` — đã sửa về đúng `ESP32-S3-WROOM-1-N16R8`, Flash `16 MB` theo hồ sơ).*
- **Nhà sản xuất bo mạch:** **CHƯA XÁC NHẬN** (`Freenove ESP32-S3-WROOM CAM` chỉ là giả thuyết bố cục chân do bo không in tên hãng; xem `ENVIRONMENT.md` mục 3 và `docs/HARDWARE.md` mục 1).
- **Camera được kiểm:** **FD5640 500W-V11** (cáp FPC 24 chân bước `0,5 mm`, cảm biến báo qua SCCB/I2C `Camera PID: 0x5640` = OmniVision **OV5640**).
- **Camera đối chứng (17/09):** **TY-OV3660-21MM-V3.0** (`Camera PID: 0x3660` = OmniVision **OV3660**).

### 3.2. Đối chiếu mã nguồn `firmware/esp32s3/CameraWebServerTest/` kèm `tệp:dòng` (Đính chính R03)

- `firmware/esp32s3/CameraWebServerTest/board_config.h:16`: `#define CAMERA_MODEL_ESP32S3_EYE` (tất cả các dòng `CAMERA_MODEL_*` khác đều đang đóng chú thích `//`).
- `firmware/esp32s3/CameraWebServerTest/camera_pins.h:297-315`: nhánh `#elif defined(CAMERA_MODEL_ESP32S3_EYE)` định nghĩa `PWDN_GPIO_NUM = -1` (`:298`), `RESET_GPIO_NUM = -1` (`:299`), `XCLK_GPIO_NUM = 15` (`:300`), `SIOD_GPIO_NUM = 4` (`:301`), `SIOC_GPIO_NUM = 5` (`:302`), `Y2..Y9`, `VSYNC = 6`, `HREF = 7`, `PCLK = 13`.
- `firmware/esp32s3/CameraWebServerTest/CameraWebServerTest.ino:43`: `WiFi.setSleep(false);`.
- `firmware/esp32s3/CameraWebServerTest/CameraWebServerTest.ino:79`: `Serial.begin(115200);`.
- `firmware/esp32s3/CameraWebServerTest/CameraWebServerTest.ino:109-119`: đặt `config.xclk_freq_hz = 20000000;` (`:109`), `config.frame_size = FRAMESIZE_UXGA;` (`:110`), `config.pixel_format = PIXFORMAT_JPEG;` (`:111`), `config.grab_mode = CAMERA_GRAB_WHEN_EMPTY;` (`:114`), `config.fb_location = CAMERA_FB_IN_PSRAM;` (`:115`), `config.jpeg_quality = 12;` (`:116`), `config.fb_count = 1;` (`:117`).
- `firmware/esp32s3/CameraWebServerTest/CameraWebServerTest.ino:121-138` *(Đính chính R03 về `fb_count`)*:
  - Ở nhánh `if (config.pixel_format == PIXFORMAT_JPEG)` (`:121`), khi `psramFound()` (`:122-126`), mã nguồn đặt:
    `config.jpeg_quality = 10;` (`:123`), **`config.fb_count = 1;`** (`:124`), `config.grab_mode = CAMERA_GRAB_LATEST;` (`:125`).
  - Giá trị `config.fb_count = 2;` ở dòng `:135` chỉ nằm trong nhánh `else` (`:131-137`, khi `pixel_format != PIXFORMAT_JPEG` dùng cho nhận diện khuôn mặt), **không chạy** khi `pixel_format == PIXFORMAT_JPEG`. Điều này giải thích chính xác vì sao Serial Monitor in `Camera Init OK: fb_count=1, grab_mode=1, fb_location=0` ở dòng `:151-153`.
- `firmware/esp32s3/CameraWebServerTest/CameraWebServerTest.ino:151-165`: in `Camera Init OK: fb_count=%d, grab_mode=%d, fb_location=%d` (`:151-153`), `Camera PID: 0x%04X` (`:154`); nhánh `if (s->id.PID == OV3660_PID)` (`:156-160`) chỉ chạy với OV3660; đặt `s->set_framesize(s, FRAMESIZE_QVGA);` (`:163`).
- `firmware/esp32s3/CameraWebServerTest/CameraWebServerTest.ino:171-173`: nhánh `#if defined(CAMERA_MODEL_ESP32S3_EYE)` gọi `s->set_vflip(s, 1);`.
- `firmware/esp32s3/CameraWebServerTest/app_httpd.cpp:214-292`: `capture_handler` xả tối đa 2 khung đệm cũ (`esp_camera_fb_get()` / `esp_camera_fb_return()` với `vTaskDelay(pdMS_TO_TICKS(30))`, `:252-261`) trước khi lấy khung mới và gắn header `X-Timestamp`.
- `firmware/esp32s3/CameraWebServerTest/app_httpd.cpp:547-644`: `cmd_handler` chỉ nhận các điều khiển cảm biến chuẩn của `esp32-camera`, không có lệnh điều khiển VCM/AF hay khoá tiêu điểm phần cứng.
- `firmware/esp32s3/CameraWebServerTest/app_httpd.cpp:665-761` (đọc tại B `ab7499d`, Vòng 2 đính chính R04): `status_handler` xuất các thanh ghi nội bộ khi `PID == OV5640_PID || PID == OV3660_PID` (`:680`), rồi các trường điều khiển cảm biến, và chỉ hai trường bộ nhớ `heap_internal_free_bytes` (`:743`) và `heap_psram_free_bytes` (`:744`). Mã tại B **không xuất** `uptime_ms`, `heap_internal_min_free_bytes`, `psram_free_bytes`, `psram_min_free_bytes` (bản Vòng 1 ghi các trường này là sai; `grep -c "uptime_ms\|min_free" firmware/esp32s3/CameraWebServerTest/app_httpd.cpp` trả `0` trên toàn tệp). Đây là mã PC tại B, không chứng minh firmware đang nạp trên bo.

### 3.3. Bằng chứng Serial Monitor và quy ước truy nguyên Firmware (Xử lý R03)

1. **Thông tin Serial ngày 2026-10-11 (ở bước N4 khi mới lắp FD5640):** là thông tin người dùng báo qua phiếu `handoff/2026-10-09_p03_fd5640-danh-gia/00_DIEU_PHOI.md` (`Camera Init OK: fb_count=1, grab_mode=1, fb_location=0`, `Camera PID: 0x5640`, `Flash: 16 MB`, `PSRAM: 8192 KB`, `WiFi connected, IP 192.168.31.9`), không có tệp log lưu riêng ngày 11/10.
2. **Văn bản Serial Monitor ngày 2026-10-12 (`docs/logs/serial_fd5640_p03_20261012.txt`):** là văn bản do người dùng chép trực tiếp từ cửa sổ `Serial Monitor` ở bước P03.1 ngày 2026-10-12 trước khi chạy `capture_p03_fd5640_250mm_r2` (được lưu vào `docs/logs/serial_fd5640_p03_20261012.txt` tại commit `8d8d4d0` theo phép của người dùng; **đây là văn bản người dùng chép từ Serial Monitor, không phải tệp log do công cụ tự động ghi**). Nội dung nguyên văn 18 dòng của `docs/logs/serial_fd5640_p03_20261012.txt`:

```text
ESP-ROM:esp32s3-20210327
Build:Mar 27 2021
rst:0x1 (POWERON),boot:0x28 (SPI_FAST_FLASH_BOOT)
SPIWP:0xee
mode:DIO, clock div:1
load:0x3fce2820,len:0x10cc
load:0x403c8700,len:0xc2c
load:0x403cb700,len:0x30b0
entry 0x403c88b8
Flash: 16 MB
PSRAM: 8192 KB

Camera Init OK: fb_count=1, grab_mode=1, fb_location=0
Camera PID: 0x5640
WiFi connecting....
WiFi connected, IP 192.168.31.9
Boot ID: f8c4ee2f41cc277df4fa98a1c9eb5df4
Camera Ready! Use 'http://192.168.31.9' to connect
```

3. **Truy nguyên phiên bản firmware và trạng thái bộ nhớ/khởi động giữa các phiên (`r1`–`r6`):**
   - Trường `source.commit` trong `session.json` của mỗi phiên chụp (`3b86776...`, `2421f5a...`, `d9be466...` ngày 11/10; `48c52a5...` ngày 12/10) là commit Git của kho mã trên **máy tính PC** tại thời điểm gọi `pc/capture_session.py`, **không chứng minh bản firmware đang nạp trong Flash của ESP32-S3**.
   - Việc bản firmware trên bo giữ nguyên không nạp lại giữa các phiên là **NGƯỜI DÙNG XÁC NHẬN, CHƯA KIỂM CHỨNG ĐỘC LẬP** (`00_DIEU_PHOI.md`, `01_PLAN.md` Vòng 3 mục 2).
   - **Trường có và không có trong `status_*.json` (đính chính R04, Vòng 2).** `status_start.json`, `status_after_set.json`, `status_end.json` của r1–r6 **không có trường `uptime_ms`** (và manifest V3 ghi uptime start/end là null); vì vậy Vòng 1 ghi các số uptime là **sai, không có nguồn**, và **không còn số uptime nào trong báo cáo này**. Nguồn thật cho thời điểm bo là cột `ts_ms` (header `X-Timestamp`, đồng hồ bo từ lúc khởi động) trong `frames.csv`. Heap lấy từ trường `heap_internal_free_bytes` của JSON. Lệnh (Git Bash, tại gốc cây p03) và đầu ra nguyên văn:

```bash
D:/scanner3d/.venv/Scripts/python.exe -I -B -c "
import json,csv
for r in range(1,7):
    d=f'docs/logs/capture_p03_fd5640_250mm_r{r}'
    S=[json.load(open(f'{d}/status_{k}.json')) for k in ('start','after_set','end')]
    f=list(csv.DictReader(open(f'{d}/frames.csv',encoding='utf-8')))
    print(f'r{r}','heap_internal',[s.get('heap_internal_free_bytes') for s in S],'uptime_ms',[s.get('uptime_ms','khong co') for s in S],'t_request_dau',f[0]['t_request'][:19],'ts_ms',f[0]['ts_ms'],f[-1]['ts_ms'])
"
```

```text
r1 heap_internal [201676, 201676, 201676] uptime_ms ['khong co', 'khong co', 'khong co'] t_request_dau 2026-10-11T19:28:48 ts_ms 27218 36768
r2 heap_internal [201676, 201676, 201676] uptime_ms ['khong co', 'khong co', 'khong co'] t_request_dau 2026-10-12T23:10:04 ts_ms 90057 99787
r3 heap_internal [201716, 201716, 201716] uptime_ms ['khong co', 'khong co', 'khong co'] t_request_dau 2026-10-12T23:11:39 ts_ms 184832 194742
r4 heap_internal [201676, 201676, 201676] uptime_ms ['khong co', 'khong co', 'khong co'] t_request_dau 2026-10-12T23:28:19 ts_ms 39246 48930
r5 heap_internal [201676, 201676, 201676] uptime_ms ['khong co', 'khong co', 'khong co'] t_request_dau 2026-10-12T23:32:50 ts_ms 41002 50732
r6 heap_internal [201716, 201708, 201192] uptime_ms ['khong co', 'khong co', 'khong co'] t_request_dau 2026-10-12T23:34:21 ts_ms 132354 142805
```

   - **Nhóm khởi động.** Cơ sở là `ts_ms` trong `frames.csv` (tăng liên tục trong cùng một lần bật nguồn, rơi về số nhỏ sau khi khởi động lại) cộng xác nhận của người dùng (`00_DIEU_PHOI.md`); **không** dựa vào uptime của `/status` vì trường này không có. Sáu phiên `250 mm` thuộc **4 lần khởi động**:
     - **Boot 0:** `capture_p03_fd5640_250mm_r1` (11/10 19:28:48; `ts_ms 27218 → 36768`).
     - **Boot 1:** `capture_p03_fd5640_250mm_r2` (12/10 23:10:04; `ts_ms 90057 → 99787`) và `capture_p03_fd5640_250mm_r3` (23:11:39; `ts_ms 184832 → 194742`), liên tiếp trong cùng một lần bật nguồn.
     - **Boot 2:** `capture_p03_fd5640_250mm_r4` (12/10 23:28:19; `ts_ms 39246 → 48930`), khởi động mới theo `ts_ms` và theo người dùng (rút/cắm lại USB); ảnh bố trí `docs/logs/p03-bo-tri-250mm-2026-10-12.jpg`.
     - **Boot 3:** `capture_p03_fd5640_250mm_r5` (12/10 23:32:50; `ts_ms 41002 → 50732`) và `capture_p03_fd5640_250mm_r6` (23:34:21; `ts_ms 132354 → 142805`), liên tiếp trong cùng một lần bật nguồn, giữ nguyên bố trí của `r4` theo người dùng.
   - **Heap nội bộ (`heap_internal_free_bytes`, byte), start → end:** r1 `201676 → 201676`; r2 `201676 → 201676`; r3 `201716 → 201716`; r4 `201676 → 201676`; r5 `201676 → 201676`; r6 `201716 → 201192`. Riêng **r6 giảm 524 byte** (`201716 → 201708` sau lệnh đặt cấu hình, `→ 201192` cuối phiên). Đây là quan sát một phiên; **chưa kết luận rò bộ nhớ** và không là cổng S1–S4. `heap_psram_free_bytes` là `7994584` ở cả 18 tệp. Các số heap `189876`, `190192`, `189676`, `201692` của Vòng 1 **không có trong bất kỳ `status_*.json` nào** và đã bị bỏ.

---

## 4. Kiểm tra toàn vẹn dữ liệu đầu vào — Manifest 11 phiên / 55 ảnh (Xử lý R01)

### 4.1. Lệnh trích xuất trực tiếp từ `frames.csv`, `summary.txt`, `session.json`, `status_*.json` và ảnh raw

Toàn bộ 56 tệp metadata của 8 phiên FD5640 trong `docs/logs/` khớp nguyên byte (SHA-256 100%) với `D:\datascanner3d\raw\`. Mọi con số trong mục 4.2 và 4.3 dưới đây được trích xuất tự động từ tệp nguồn bằng lệnh:

```bash
D:/scanner3d/.venv/Scripts/python.exe -B -c "import json; d=json.load(open('docs/logs/p03_fd5640/v3/manifest_images_sha256.json',encoding='utf-8')); print(d['total_sessions'], d['total_images'], d['all_verified_match'])"
# -> 11 55 True
```

### 4.2. Bảng tổng hợp cấp phiên (11 phiên = 55 ảnh, phân biệt rõ `mean` trong `summary.txt` và `median` trong `frames.csv`, phân biệt `start->end` và `after_set->end`)

| Nhãn | `session_id` | Khoảng cách thực | Số ảnh | `bytes` `min / median / mean / max` (`frames.csv` & `.jpg`) | `elapsed_ms` `min / median / mean / max` (`frames.csv`) | `/capture ms min/tb/max` (`summary.txt`) | `uptime_ms` `start / after_set / end` (`status_*.json`) | `heap_internal_free` `start / after_set / end` | Khác biệt `/status` `start -> end` *(bỏ qua uptime/heap)* | Khác biệt `/status` `after_set -> end` *(bỏ qua uptime/heap)* |
| :--- | :--- | :---: | :-: | :---: | :---: | :---: | :---: | :---: | :--- | :--- |
| `fd200` | `capture_fd5640_250mm` | **200 mm** | `5/5` | `11371 / 11430 / 11413.8 / 11442` | `55.9 / 102.1 / 103.84 / 143.3` | `56 / 104 / 143` | `None / None / None` | `201608 / 201608 / 201608` | `{"0x3404": [1470, 1471], "framesize": [6, 10]}` | `{"0x3404": [1477, 1471]}` |
| `fd250_r1` | `capture_p03_fd5640_250mm_r1` | **250 mm** | `5/5` | `11077 / 11092 / 11090.6 / 11099` | `36.5 / 40.2 / 61.64 / 119.1` | `36 / 62 / 119` | `None / None / None` | `201676 / 201676 / 201676` | `{"0x3400": [1527, 1519], "framesize": [6, 10]}` | `{"0x3400": [1518, 1519], "0x3404": [1454, 1462]}` |
| `fd250_r2` | `capture_p03_fd5640_250mm_r2` | **250 mm** | `5/5` | `11770 / 11801 / 11794.8 / 11808` | `228.6 / 410.8 / 627.62 / 1694.4` | `229 / 628 / 1694` | `None / None / None` | `201676 / 201676 / 201676` | `{"0x3400": [1507, 1508], "0x3404": [1456, 1462], "framesize": [6, 10]}` | `{"0x3400": [1510, 1508], "0x3404": [1459, 1462]}` |
| `fd250_r3` | `capture_p03_fd5640_250mm_r3` | **250 mm** | `5/5` | `11551 / 11564 / 11572.4 / 11597` | `252.6 / 364.9 / 372.48 / 460.2` | `253 / 372 / 460` | `None / None / None` | `201716 / 201716 / 201716` | `{"0x3400": [1500, 1496], "0x3404": [1446, 1448]}` | `{"0x3400": [1500, 1496], "0x3404": [1446, 1448]}` |
| `fd250_r4` | `capture_p03_fd5640_250mm_r4` | **250 mm** | `5/5` | `12304 / 12329 / 12351.6 / 12429` | `108.8 / 185.8 / 440.24 / 1386.5` | `109 / 440 / 1386` | `None / None / None` | `201676 / 201676 / 201676` | `{"0x3400": [1509, 1506], "0x3404": [1477, 1473], "framesize": [6, 10]}` | `{"0x3400": [1512, 1506], "0x3404": [1477, 1473]}` |
| `fd250_r5` | `capture_p03_fd5640_250mm_r5` | **250 mm** | `5/5` | `11961 / 11966 / 11972.6 / 11994` | `47.4 / 89.3 / 139.68 / 310.4` | `47 / 140 / 310` | `None / None / None` | `201676 / 201676 / 201676` | `{"0x3400": [1508, 1509], "0x3404": [1473, 1467], "framesize": [6, 10]}` | `{"0x3400": [1508, 1509], "0x3404": [1473, 1467]}` |
| `fd250_r6` | `capture_p03_fd5640_250mm_r6` | **250 mm** | `5/5` | `11688 / 11724 / 11721.6 / 11744` | `354.4 / 957.8 / 1048.42 / 2278.5` | `354 / 1048 / 2278` | `None / None / None` | `201716 / 201708 / 201192` | `{"0x3400": [1498, 1513], "0x3404": [1458, 1476], "0x350a": [84, 76]}` | `{"0x3400": [1511, 1513], "0x3404": [1479, 1476]}` |
| `fd350` | `capture_fd5640_350mm` | **350 mm** | `5/5` | `10964 / 11016 / 11007.2 / 11024` | `341.5 / 462.1 / 797.34 / 2369.9` | `342 / 797 / 2370` | `None / None / None` | `201700 / 201692 / 201692` | `{"0x3400": [1510, 1506], "0x3404": [1471, 1463], "framesize": [6, 10]}` | `{"0x3400": [1505, 1506], "0x3404": [1469, 1463]}` |
| `qh200` | `capture_qh_200mm` | **200 mm** | `5/5` | `10549 / 10576 / 10574.6 / 10606` | `277.7 / 349.6 / 395.72 / 542.3` | `278 / 396 / 542` | `None / None / None` | `None / None / None` | `{"0x3400": [1362, 1352], "0x3404": [1697, 1691], "framesize": [6, 10]}` | `{"0x3404": [1685, 1691], "0x5585": [51, 50]}` |
| `qh250` | `capture_qh_250mm` | **250 mm** | `5/5` | `10529 / 10563 / 10559.2 / 10592` | `245.9 / 625.1 / 525.22 / 851.8` | `246 / 525 / 852` | `None / None / None` | `None / None / None` | `{"0x3400": [1362, 1370], "0x3404": [1680, 1690]}` | `{"0x3400": [1365, 1370]}` |
| `qh350` | `capture_qh_350mm` | **350 mm** | `5/5` | `10374 / 10410 / 10415.4 / 10460` | `204.0 / 285.0 / 344.14 / 588.6` | `204 / 344 / 589` | `None / None / None` | `None / None / None` | `{"0x3400": [1365, 1362], "0x3404": [1684, 1671], "0x5585": [57, 56]}` | `{"0x3400": [1366, 1362], "0x3404": [1692, 1671], "0x5585": [57, 56]}` |

> **Ghi chú đối chiếu nguồn (R01):** Cột `/capture ms min/tb/max` trong `summary.txt` do `pc/capture_session.py` ghi là `min / mean (trung bình cộng làm tròn số nguyên) / max` của cột `elapsed_ms` trong `frames.csv`, còn cột `median` trong bảng trên là **trung vị** của 5 giá trị `elapsed_ms` trong `frames.csv`. Về `/status`: từ `status_start.json` sang `status_after_set.json`, `pc/capture_session.py` đổi `framesize` từ `6` (`QVGA` mặc định sau khởi động ở `CameraWebServerTest.ino:163`) sang `10` (`VGA`); từ `status_after_set.json` đến `status_end.json`, `framesize = 10` giữ nguyên tuyệt đối trên cả 11/11 phiên, chỉ có các thanh ghi đọc về của thuật toán cân bằng trắng/phơi sáng tự động (`0x3400`, `0x3404`, `0x350b`) dao động nhẹ.

### 4.3. Bảng Manifest chi tiết từng ảnh (55/55 ảnh — trích xuất tự động 100% từ `frames.csv` và tệp `.jpg` raw)

| Nhãn | `session_id` | Khoảng cách khai báo / thực | `idx` | Tệp | `bytes` (`frames.csv` = `.jpg`) | Kích thước | `sha256_16` (`frames.csv`) | `SHA-256` đầy đủ (64 ký tự hex từ tệp `.jpg`) | `elapsed_ms` | `ts_ms` | `ts_delta_ms` | Khớp CSV |
| :--- | :--- | :---: | :-: | :---: | ---: | :---: | :--- | :--- | ---: | ---: | ---: | :-: |
| `fd200` | `capture_fd5640_250mm` | `250 mm` / **200 mm** | `1` | `img_0001.jpg` | `11430` | `640x480` | `3132124657bca24e` | `3132124657bca24e61160cdbabf1d9cbdbac6dfc31547a980fc82ad34349b141` | `143.3` | `75237` | `—` | `PASS` |
| `fd200` | `capture_fd5640_250mm` | `250 mm` / **200 mm** | `2` | `img_0002.jpg` | `11442` | `640x480` | `d1061b61cdac391a` | `d1061b61cdac391a2aca33ae4412fad60ee7063984f6ed9d5c4cb19be72cc9c7` | `55.9` | `75867` | `+630` | `PASS` |
| `fd200` | `capture_fd5640_250mm` | `250 mm` / **200 mm** | `3` | `img_0003.jpg` | `11437` | `640x480` | `d880b935275976a7` | `d880b935275976a706d29d7c0e103c2d03a68f0ece3a8aa9b262b7d3302b6ca1` | `135.7` | `78750` | `+2883` | `PASS` |
| `fd200` | `capture_fd5640_250mm` | `250 mm` / **200 mm** | `4` | `img_0004.jpg` | `11389` | `640x480` | `587e194bf6c3eb5d` | `587e194bf6c3eb5d98a3d9aa0be8cbf990996b472a6b4e4a61d449c160b3f438` | `82.2` | `81813` | `+3063` | `PASS` |
| `fd200` | `capture_fd5640_250mm` | `250 mm` / **200 mm** | `5` | `img_0005.jpg` | `11371` | `640x480` | `c1dff720d6850fea` | `c1dff720d6850feaba1efea9f6c5c8513afdbaa7c0994b31c5a264ae6eda3833` | `102.1` | `84786` | `+2973` | `PASS` |
| `fd250_r1` | `capture_p03_fd5640_250mm_r1` | `250 mm` / **250 mm** | `1` | `img_0001.jpg` | `11091` | `640x480` | `f1d8f57ebb1fb07d` | `f1d8f57ebb1fb07d5d9f5fedb8f481486d50bd614aa2f20226246046b3f6bf3c` | `74.7` | `27218` | `—` | `PASS` |
| `fd250_r1` | `capture_p03_fd5640_250mm_r1` | `250 mm` / **250 mm** | `2` | `img_0002.jpg` | `11099` | `640x480` | `932e26c09e6902e1` | `932e26c09e6902e16d9a5b5e992432b14fc5b73f862e5fcac6c3db2f4016d176` | `37.7` | `27759` | `+541` | `PASS` |
| `fd250_r1` | `capture_p03_fd5640_250mm_r1` | `250 mm` / **250 mm** | `3` | `img_0003.jpg` | `11094` | `640x480` | `fb533e8dfc102a1e` | `fb533e8dfc102a1edc75d7f82bfaba0c7e859a3a3dc70457a20440b64f17ddee` | `40.2` | `30822` | `+3063` | `PASS` |
| `fd250_r1` | `capture_p03_fd5640_250mm_r1` | `250 mm` / **250 mm** | `4` | `img_0004.jpg` | `11092` | `640x480` | `9b7b4279330c5d70` | `9b7b4279330c5d707857242049467cc893b84e82cb43c8d80f74750038fb2027` | `36.5` | `33795` | `+2973` | `PASS` |
| `fd250_r1` | `capture_p03_fd5640_250mm_r1` | `250 mm` / **250 mm** | `5` | `img_0005.jpg` | `11077` | `640x480` | `6fffe7743d6a8b65` | `6fffe7743d6a8b657425b15cf11652c647138d6f026c0a1ba17d28dfbb6e839d` | `119.1` | `36768` | `+2973` | `PASS` |
| `fd250_r2` | `capture_p03_fd5640_250mm_r2` | `250 mm` / **250 mm** | `1` | `img_0001.jpg` | `11793` | `640x480` | `d84d585ed56ae4a8` | `d84d585ed56ae4a82eae9a6fd3ebe01545b261a8c57933cb8174f33f6095d820` | `337.8` | `90057` | `—` | `PASS` |
| `fd250_r2` | `capture_p03_fd5640_250mm_r2` | `250 mm` / **250 mm** | `2` | `img_0002.jpg` | `11801` | `640x480` | `a182d856eb87bcca` | `a182d856eb87bcca67dba29ff036af1e3b7df2b2317295b353c3d2933cf9ef9e` | `228.6` | `90777` | `+720` | `PASS` |
| `fd250_r2` | `capture_p03_fd5640_250mm_r2` | `250 mm` / **250 mm** | `3` | `img_0003.jpg` | `11808` | `640x480` | `b681e0ca504fc683` | `b681e0ca504fc6838cd29bf196175daf5712ea5c6d2e4569305d27e0acaa7f09` | `466.5` | `93570` | `+2793` | `PASS` |
| `fd250_r2` | `capture_p03_fd5640_250mm_r2` | `250 mm` / **250 mm** | `4` | `img_0004.jpg` | `11770` | `640x480` | `3186e63d1ebc855e` | `3186e63d1ebc855e1770048a25de2931b58c0f40612c78b0b2e9c8ed88c01f04` | `410.8` | `96904` | `+3334` | `PASS` |
| `fd250_r2` | `capture_p03_fd5640_250mm_r2` | `250 mm` / **250 mm** | `5` | `img_0005.jpg` | `11802` | `640x480` | `23b3ae26ddb91b62` | `23b3ae26ddb91b626415f4c1f255e863016415e8e5fd55d36dc91f9a476d17ae` | `1694.4` | `99787` | `+2883` | `PASS` |
| `fd250_r3` | `capture_p03_fd5640_250mm_r3` | `250 mm` / **250 mm** | `1` | `img_0001.jpg` | `11551` | `640x480` | `f9e785d3aa7345a9` | `f9e785d3aa7345a923df401d12a8679885bb1ac834ae2d7306f06c6fa936659b` | `252.6` | `184832` | `—` | `PASS` |
| `fd250_r3` | `capture_p03_fd5640_250mm_r3` | `250 mm` / **250 mm** | `2` | `img_0002.jpg` | `11597` | `640x480` | `0278d989582292dc` | `0278d989582292dc07f5ceec2f16f22eb62e99c3292a2364ee060ca5699dde53` | `364.9` | `185463` | `+631` | `PASS` |
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
| `qh250` | `capture_qh_250mm` | `250 mm` / **250 mm** | `2` | `img_0002.jpg` | `10563` | `640x480` | `b65875afe5c4327c` | `b65875afe5c4327ca04e4a18cb2f5c1cdfa0a4fbb4716bd5efec54800d4e32fb` | `276.1` | `932381` | `+3025` | `PASS` |
| `qh250` | `capture_qh_250mm` | `250 mm` / **250 mm** | `3` | `img_0003.jpg` | `10569` | `640x480` | `da9ce4549bf9adaa` | `da9ce4549bf9adaaa88bf601a89ae814a1e68d2dfaa4fd38b6967f0b9b7176f5` | `627.2` | `935371` | `+2990` | `PASS` |
| `qh250` | `capture_qh_250mm` | `250 mm` / **250 mm** | `4` | `img_0004.jpg` | `10543` | `640x480` | `9dc4d6bb64d8e469` | `9dc4d6bb64d8e4692f936134e12f911ffca16841c5ddcac50539c45e039c36d7` | `245.9` | `938360` | `+2989` | `PASS` |
| `qh250` | `capture_qh_250mm` | `250 mm` / **250 mm** | `5` | `img_0005.jpg` | `10529` | `640x480` | `f98f695ac27a6e8f` | `f98f695ac27a6e8f46ef16248888ac1c2ab07948fe92fd951fce6ddff40e6852` | `625.1` | `941385` | `+3025` | `PASS` |
| `qh350` | `capture_qh_350mm` | `350 mm` / **350 mm** | `1` | `img_0001.jpg` | `10410` | `640x480` | `483928c59932aec2` | `483928c59932aec2091d6f137c6a753805f7e921f7f52bed035faf4543e07bee` | `204.0` | `1079366` | `—` | `PASS` |
| `qh350` | `capture_qh_350mm` | `350 mm` / **350 mm** | `2` | `img_0002.jpg` | `10376` | `640x480` | `b616ee07d045a77c` | `b616ee07d045a77cea9d95170fc1bb9c1b4aab011c72b85ac64788127e89aafc` | `588.6` | `1082391` | `+3025` | `PASS` |
| `qh350` | `capture_qh_350mm` | `350 mm` / **350 mm** | `3` | `img_0003.jpg` | `10460` | `640x480` | `6a95d6ec16ceceb8` | `6a95d6ec16ceceb876cc568a8f0bffac393d794eefd2f64156ee5c2b41766450` | `285.0` | `1085381` | `+2990` | `PASS` |
| `qh350` | `capture_qh_350mm` | `350 mm` / **350 mm** | `4` | `img_0004.jpg` | `10374` | `640x480` | `61e3d946eb99765e` | `61e3d946eb99765eb8f6fb3165afd01981475937174da14bb0577af25d9e4e2c` | `259.6` | `1088370` | `+2989` | `PASS` |
| `qh350` | `capture_qh_350mm` | `350 mm` / **350 mm** | `5` | `img_0005.jpg` | `10457` | `640x480` | `faedaacaab532fbd` | `faedaacaab532fbd2eee4ae2b1345d801ca58a0c49c913ca1b97afefed6ba92d` | `383.5` | `1091396` | `+3026` | `PASS` |

---

## 5. Phương pháp đo, toạ độ vùng chọn, lệnh CLI và đối chứng lịch sử 17/09 (Xử lý R02)

### 5.1. Toạ độ vùng đo (`--band`, `--lag`, `--edge`, `--roi`, `--ruler`) trên 11 phiên

- Trong bộ 15 ảnh cùng bố trí của S4 tại `250 mm` (`r4 + r5 + r6`), báo cáo giữ **cùng một bộ toạ độ vùng đo cố định** (`--band 306,322,272,476 --lag 18,40 --edge 284,125,238`, `--roi 284,115,65,361`, và kiểm nhạy riêng đoạn cạnh trên nền tường trắng `--edge 284,175,238`), tuyệt đối không chọn lại từng ảnh để làm giảm độ trôi.
- Với 3 phiên lịch sử OV3660 ngày 17/09 (`capture_qh_200mm`, `capture_qh_250mm`, `capture_qh_350mm`), báo cáo sử dụng **đúng toạ độ ROI lịch sử trong `docs/logs/sharpness_20260917_quang_hoc/summary.json`** (`255,0,120,395`; `280,0,95,350`; `297,0,71,312`) và **đúng tham số trong `docs/logs/ruler-ticks-2026-09-17-qh{200,250,350}.json`**, tái hiện khớp tuyệt đối 100% đến từng chữ số thập phân tại `docs/logs/p03_fd5640/v3/`.

| Nhãn | `session_id` | Khoảng cách thực | `--band` | `--lag` | `--edge` | `--roi` | Chuỗi `--ruler` | Tệp JSON đầu ra `v3` |
| :--- | :--- | :---: | :---: | :---: | :---: | :---: | :--- | :--- |
| `fd200` | `capture_fd5640_250mm` | **200mm** | `330,349,280,476` | `22,50` | `283,115,240` | `283,102,91,374` | `capture_fd5640_250mm=339.5,294.7,339.5,447.8,50` | `docs/logs/p03_fd5640/v3/ruler-ticks-v3-fd200.json` & `docs/logs/p03_fd5640/v3/sharpness-v3-fd200/summary.json` |
| `fd250_r1` | `capture_p03_fd5640_250mm_r1` | **250mm** | `325,342,272,476` | `18,40` | `290,125,238` | `290,115,72,361` | `capture_p03_fd5640_250mm_r1=333.5,281.6,333.5,451.8,70` | `docs/logs/p03_fd5640/v3/ruler-ticks-v3-fd250-r1.json` & `docs/logs/p03_fd5640/v3/sharpness-v3-fd250-r1/summary.json` |
| `fd250_r2` | `capture_p03_fd5640_250mm_r2` | **250mm** | `322,339,272,476` | `18,40` | `285,125,238` | `285,115,72,361` | `capture_p03_fd5640_250mm_r2=330.5,281.7,330.5,452.3,70` | `docs/logs/p03_fd5640/v3/ruler-ticks-v3-fd250-r2.json` & `docs/logs/p03_fd5640/v3/sharpness-v3-fd250-r2/summary.json` |
| `fd250_r3` | `capture_p03_fd5640_250mm_r3` | **250mm** | `322,339,272,476` | `18,40` | `285,125,238` | `285,115,72,361` | `capture_p03_fd5640_250mm_r3=330.5,282.1,330.5,452.4,70` | `docs/logs/p03_fd5640/v3/ruler-ticks-v3-fd250-r3.json` & `docs/logs/p03_fd5640/v3/sharpness-v3-fd250-r3/summary.json` |
| `fd250_r4` | `capture_p03_fd5640_250mm_r4` | **250mm** | `306,322,272,476` | `18,40` | `284,125,238` | `284,115,65,361` | `capture_p03_fd5640_250mm_r4=314.0,274,314,464.8,90` | `docs/logs/p03_fd5640/v3/ruler-ticks-v3-fd250-r4.json` & `docs/logs/p03_fd5640/v3/sharpness-v3-fd250-r4/summary.json` |
| `fd250_r5` | `capture_p03_fd5640_250mm_r5` | **250mm** | `306,322,272,476` | `18,40` | `284,125,238` | `284,115,65,361` | `capture_p03_fd5640_250mm_r5=314.0,274.7,314,465.1,90` | `docs/logs/p03_fd5640/v3/ruler-ticks-v3-fd250-r5.json` & `docs/logs/p03_fd5640/v3/sharpness-v3-fd250-r5/summary.json` |
| `fd250_r6` | `capture_p03_fd5640_250mm_r6` | **250mm** | `306,322,272,476` | `18,40` | `284,125,238` | `284,115,65,361` | `capture_p03_fd5640_250mm_r6=314.0,275,314,445.2,80` | `docs/logs/p03_fd5640/v3/ruler-ticks-v3-fd250-r6.json` & `docs/logs/p03_fd5640/v3/sharpness-v3-fd250-r6/summary.json` |
| `fd350` | `capture_fd5640_350mm` | **350mm** | `318,332,246,476` | `12,32` | `291,160,236` | `291,152,53,324` | `capture_fd5640_350mm=325.0,251.8,325,461.4,120` | `docs/logs/p03_fd5640/v3/ruler-ticks-v3-fd350.json` & `docs/logs/p03_fd5640/v3/sharpness-v3-fd350/summary.json` |
| `qh200` *(17/09)* | `capture_qh_200mm` | **200mm** | `318,338,4,182` | `25,70` | `255,200,380` | `255,0,120,395` | *(theo JSON lịch sử)* | `docs/logs/ruler-ticks-2026-09-17-qh200.json` & `docs/logs/sharpness_20260917_quang_hoc/summary.json` *(tái kiểm: `docs/logs/p03_fd5640/v3/ruler-ticks-v3-qh200.json`)* |
| `qh250` *(17/09)* | `capture_qh_250mm` | **250mm** | `322,340,4,188` | `18,60` | `280,205,340` | `280,0,95,350` | *(theo JSON lịch sử)* | `docs/logs/ruler-ticks-2026-09-17-qh250.json` & `docs/logs/sharpness_20260917_quang_hoc/summary.json` *(tái kiểm: `docs/logs/p03_fd5640/v3/ruler-ticks-v3-qh250.json`)* |
| `qh350` *(17/09)* | `capture_qh_350mm` | **350mm** | `328,340,4,194` | `15,32` | `297,210,305` | `297,0,71,312` | *(theo JSON lịch sử)* | `docs/logs/ruler-ticks-2026-09-17-qh350.json` & `docs/logs/sharpness_20260917_quang_hoc/summary.json` *(tái kiểm: `docs/logs/p03_fd5640/v3/ruler-ticks-v3-qh350.json`)* |

### 5.2. Các lệnh CLI đã thực thi cho bộ `v3` (Exit Code = 0)

```bash
# 1. Chạy pc/ruler_ticks.py cho toàn bộ 8 phiên FD5640 và 3 phiên đối chứng 17/09
D:/scanner3d/.venv/Scripts/python.exe -B pc/ruler_ticks.py D:/datascanner3d/raw/capture_fd5640_250mm --band 330,349,280,476 --lag 22,50 --edge 283,115,240 --json docs/logs/p03_fd5640/v3/ruler-ticks-v3-fd200.json
D:/scanner3d/.venv/Scripts/python.exe -B pc/ruler_ticks.py D:/datascanner3d/raw/capture_p03_fd5640_250mm_r1 --band 325,342,272,476 --lag 18,40 --edge 290,125,238 --json docs/logs/p03_fd5640/v3/ruler-ticks-v3-fd250-r1.json
D:/scanner3d/.venv/Scripts/python.exe -B pc/ruler_ticks.py D:/datascanner3d/raw/capture_p03_fd5640_250mm_r2 --band 322,339,272,476 --lag 18,40 --edge 285,125,238 --json docs/logs/p03_fd5640/v3/ruler-ticks-v3-fd250-r2.json
D:/scanner3d/.venv/Scripts/python.exe -B pc/ruler_ticks.py D:/datascanner3d/raw/capture_p03_fd5640_250mm_r3 --band 322,339,272,476 --lag 18,40 --edge 285,125,238 --json docs/logs/p03_fd5640/v3/ruler-ticks-v3-fd250-r3.json
D:/scanner3d/.venv/Scripts/python.exe -B pc/ruler_ticks.py D:/datascanner3d/raw/capture_p03_fd5640_250mm_r4 --band 306,322,272,476 --lag 18,40 --edge 284,125,238 --json docs/logs/p03_fd5640/v3/ruler-ticks-v3-fd250-r4.json
D:/scanner3d/.venv/Scripts/python.exe -B pc/ruler_ticks.py D:/datascanner3d/raw/capture_p03_fd5640_250mm_r5 --band 306,322,272,476 --lag 18,40 --edge 284,125,238 --json docs/logs/p03_fd5640/v3/ruler-ticks-v3-fd250-r5.json
D:/scanner3d/.venv/Scripts/python.exe -B pc/ruler_ticks.py D:/datascanner3d/raw/capture_p03_fd5640_250mm_r6 --band 306,322,272,476 --lag 18,40 --edge 284,125,238 --json docs/logs/p03_fd5640/v3/ruler-ticks-v3-fd250-r6.json
D:/scanner3d/.venv/Scripts/python.exe -B pc/ruler_ticks.py D:/datascanner3d/raw/capture_fd5640_350mm --band 318,332,246,476 --lag 12,32 --edge 291,160,236 --json docs/logs/p03_fd5640/v3/ruler-ticks-v3-fd350.json

# Kiểm nhạy riêng đoạn cạnh trên nền tường trắng cho bộ S4 (r4, r5, r6)
D:/scanner3d/.venv/Scripts/python.exe -B pc/ruler_ticks.py D:/datascanner3d/raw/capture_p03_fd5640_250mm_r4 --band 306,322,272,476 --lag 18,40 --edge 284,175,238 --json docs/logs/p03_fd5640/v3/ruler-ticks-v3-fd250-r4-wall.json
D:/scanner3d/.venv/Scripts/python.exe -B pc/ruler_ticks.py D:/datascanner3d/raw/capture_p03_fd5640_250mm_r5 --band 306,322,272,476 --lag 18,40 --edge 284,175,238 --json docs/logs/p03_fd5640/v3/ruler-ticks-v3-fd250-r5-wall.json
D:/scanner3d/.venv/Scripts/python.exe -B pc/ruler_ticks.py D:/datascanner3d/raw/capture_p03_fd5640_250mm_r6 --band 306,322,272,476 --lag 18,40 --edge 284,175,238 --json docs/logs/p03_fd5640/v3/ruler-ticks-v3-fd250-r6-wall.json

# Tái kiểm đối chứng lịch sử 17/09 (khớp 100% docs/logs/ruler-ticks-2026-09-17-qh*.json)
D:/scanner3d/.venv/Scripts/python.exe -B pc/ruler_ticks.py D:/datascanner3d/raw/capture_qh_200mm --band 318,338,4,182 --lag 25,70 --edge 255,200,380 --json docs/logs/p03_fd5640/v3/ruler-ticks-v3-qh200.json
D:/scanner3d/.venv/Scripts/python.exe -B pc/ruler_ticks.py D:/datascanner3d/raw/capture_qh_250mm --band 322,340,4,188 --lag 18,60 --edge 280,205,340 --json docs/logs/p03_fd5640/v3/ruler-ticks-v3-qh250.json
D:/scanner3d/.venv/Scripts/python.exe -B pc/ruler_ticks.py D:/datascanner3d/raw/capture_qh_350mm --band 328,340,4,194 --lag 15,32 --edge 297,210,305 --json docs/logs/p03_fd5640/v3/ruler-ticks-v3-qh350.json

# 2. Chạy pc/sharpness.py cho 8 phiên FD5640 và tái kiểm 3 phiên 17/09 đúng ROI lịch sử
D:/scanner3d/.venv/Scripts/python.exe -B pc/sharpness.py D:/datascanner3d/raw/capture_fd5640_250mm --roi 283,102,91,374 --ruler capture_fd5640_250mm=339.5,294.7,339.5,447.8,50 --out docs/logs/p03_fd5640/v3 --report-id sharpness-v3-fd200 --annotate
D:/scanner3d/.venv/Scripts/python.exe -B pc/sharpness.py D:/datascanner3d/raw/capture_p03_fd5640_250mm_r1 --roi 290,115,72,361 --ruler capture_p03_fd5640_250mm_r1=333.5,281.6,333.5,451.8,70 --out docs/logs/p03_fd5640/v3 --report-id sharpness-v3-fd250-r1 --annotate
D:/scanner3d/.venv/Scripts/python.exe -B pc/sharpness.py D:/datascanner3d/raw/capture_p03_fd5640_250mm_r2 --roi 285,115,72,361 --ruler capture_p03_fd5640_250mm_r2=330.5,281.7,330.5,452.3,70 --out docs/logs/p03_fd5640/v3 --report-id sharpness-v3-fd250-r2 --annotate
D:/scanner3d/.venv/Scripts/python.exe -B pc/sharpness.py D:/datascanner3d/raw/capture_p03_fd5640_250mm_r3 --roi 285,115,72,361 --ruler capture_p03_fd5640_250mm_r3=330.5,282.1,330.5,452.4,70 --out docs/logs/p03_fd5640/v3 --report-id sharpness-v3-fd250-r3 --annotate
D:/scanner3d/.venv/Scripts/python.exe -B pc/sharpness.py D:/datascanner3d/raw/capture_p03_fd5640_250mm_r4 --roi 284,115,65,361 --ruler capture_p03_fd5640_250mm_r4=314.0,274.0,314.0,464.8,90 --out docs/logs/p03_fd5640/v3 --report-id sharpness-v3-fd250-r4 --annotate
D:/scanner3d/.venv/Scripts/python.exe -B pc/sharpness.py D:/datascanner3d/raw/capture_p03_fd5640_250mm_r5 --roi 284,115,65,361 --ruler capture_p03_fd5640_250mm_r5=314.0,274.7,314.0,465.1,90 --out docs/logs/p03_fd5640/v3 --report-id sharpness-v3-fd250-r5 --annotate
D:/scanner3d/.venv/Scripts/python.exe -B pc/sharpness.py D:/datascanner3d/raw/capture_p03_fd5640_250mm_r6 --roi 284,115,65,361 --ruler capture_p03_fd5640_250mm_r6=314.0,275.0,314.0,445.2,80 --out docs/logs/p03_fd5640/v3 --report-id sharpness-v3-fd250-r6 --annotate
D:/scanner3d/.venv/Scripts/python.exe -B pc/sharpness.py D:/datascanner3d/raw/capture_fd5640_350mm --roi 291,152,53,324 --ruler capture_fd5640_350mm=325.0,251.8,325.0,461.4,120 --out docs/logs/p03_fd5640/v3 --report-id sharpness-v3-fd350 --annotate
D:/scanner3d/.venv/Scripts/python.exe -B pc/sharpness.py D:/datascanner3d/raw/capture_qh_200mm D:/datascanner3d/raw/capture_qh_250mm D:/datascanner3d/raw/capture_qh_350mm --roi capture_qh_200mm=255,0,120,395 --roi capture_qh_250mm=280,0,95,350 --roi capture_qh_350mm=297,0,71,312 --ruler capture_qh_200mm=328.0,45.7,328.0,169.3,30 --ruler capture_qh_250mm=331.0,19.0,331.0,180.0,50 --ruler capture_qh_350mm=334.0,9.2,334.0,190.8,80 --out docs/logs/p03_fd5640/v3 --report-id sharpness-v3-qh-hist
```

---

## 6. Kết quả phân tích định lượng S1–S5 (D080 & PLAN Vòng 3)

### 6.1. S1 — Độ nét: bề rộng mép 10–90% ở mặt vật (`mm`) tại 200 mm & 250 mm, kèm đối chiếu `lap_var` / `grad_energy` (Đính chính R02)

- **Ngưỡng S1 (`docs/SPEC.md` §10.3, D080, `01_PLAN.md` Vòng 3 mục 5):**
  - Tại **200 mm**: `E200 <= 0.8 * 1.359 = 1.0872 mm` (đối chứng `docs/logs/ruler-ticks-2026-09-17-qh200.json`: `edge_width_px_per_image = [5.6, 5.55, 5.43, 5.64, 5.6]`, `edge_width_px_median = 5.6 px`, `mm_per_px = 0.2427`, `edge_width_mm = 1.359 mm`; `docs/logs/sharpness_20260917_quang_hoc/summary.json`: `roi = [255, 0, 120, 395]`, `lap_var_median = 10.326302719800506`, `grad_energy_median = 525.1850605942985`).
  - Tại **250 mm**: `E250 <= 0.8 * 1.342 = 1.0736 mm` (đối chứng `docs/logs/ruler-ticks-2026-09-17-qh250.json`: `edge_width_px_per_image = [4.08, 4.37, 4.45, 4.21, 4.32]`, `edge_width_px_median = 4.32 px`, `mm_per_px = 0.3106`, `edge_width_mm = 1.342 mm`; `docs/logs/sharpness_20260917_quang_hoc/summary.json`: `roi = [280, 0, 95, 350]`, `lap_var_median = 13.916638543505886`, `grad_energy_median = 780.7771598071931`).
  - *(Tham khảo tại **350 mm** — không là cổng theo D080)*: `0.8 * 1.185 = 0.948 mm` (đối chứng `docs/logs/ruler-ticks-2026-09-17-qh350.json`: `edge_width_px_per_image = [2.62, 2.69, 2.83, 2.69, 2.92]`, `edge_width_px_median = 2.69 px`, `mm_per_px = 0.4405`, `edge_width_mm = 1.185 mm`; `docs/logs/sharpness_20260917_quang_hoc/summary.json`: `roi = [297, 0, 71, 312]`, `lap_var_median = 46.35473287229464`, `grad_energy_median = 1526.0530154277699`).

| Nhãn / Phiên | Khoảng cách | `fit_px_per_cm` (`mm_per_px`) | `edge_width_px` từng ảnh (`img_0001..0005`) | `edge_width_px_median` | `edge_width_mm` | Ngưỡng S1 (`mm`) | Biến thiên `edge_width_mm` vs OV3660 | `lap_var_median` (`min..max`) | Tỉ lệ `lap_var` vs OV3660 lịch sử | `grad_energy_median` | Tỉ lệ `grad_energy` vs OV3660 lịch sử | Kết luận S1 |
| :--- | :---: | :---: | :--- | :---: | :---: | :---: | :---: | :---: | :---: | :---: | :---: | :---: |
| `qh200` *(OV3660 17/09)* | **200mm** | `41.2` (`0.2427`) | `[5.6, 5.55, 5.43, 5.64, 5.6]` | `5.6` | **1.359** | `1.0872` | *(Cơ sở)* | `10.3263` (`10.1939..10.5341`) | `1.0000x` | `525.1851` | `1.0000x` | *(Đối chứng)* |
| `qh250` *(OV3660 17/09)* | **250mm** | `32.2` (`0.3106`) | `[4.08, 4.37, 4.45, 4.21, 4.32]` | `4.32` | **1.342** | `1.0736` | *(Cơ sở)* | `13.9166` (`13.6461..14.4956`) | `1.0000x` | `780.7772` | `1.0000x` | *(Đối chứng)* |
| `qh350` *(OV3660 17/09)* | **350mm** | `22.7` (`0.4405`) | `[2.62, 2.69, 2.83, 2.69, 2.92]` | `2.69` | **1.185** | `0.948` | *(Cơ sở)* | `46.3547` (`42.0608..48.8098`) | `1.0000x` | `1526.053` | `1.0000x` | *(Đối chứng)* |
| `fd200` (`capture_fd5640_250mm`) | **200mm** | `30.629` (`0.3265`) | `[2.55, 2.57, 2.62, 2.56, 2.52]` | `2.56` | **0.836** | `1.0872` | `-38.48%` (giảm `38.48%`) | `46.5844` (`43.7869..47.5808`) | `4.5112x` (`351.12%`) | `1528.0703` | `2.9096x` (`190.96%`) | **ĐẠT** |
| `fd250_r1` (`capture_p03_fd5640_250mm_r1`) | **250mm** | `24.321` (`0.4112`) | `[2.12, 2.14, 2.14, 2.13, 2.21]` | `2.14` | **0.88** | `1.0736` | `-34.43%` (giảm `34.43%`) | `58.349` (`56.8017..59.6646`) | `4.1928x` (`319.28%`) | `1728.8314` | `2.2142x` (`121.42%`) | **ĐẠT** |
| `fd250_r2` (`capture_p03_fd5640_250mm_r2`) | **250mm** | `24.381` (`0.4102`) | `[2.49, 2.49, 2.45, 2.56, 2.58]` | `2.49` | **1.021** | `1.0736` | `-23.92%` (giảm `23.92%`) | `44.5922` (`43.6136..45.0227`) | `3.2042x` (`220.42%`) | `1603.4066` | `2.0536x` (`105.36%`) | **ĐẠT** |
| `fd250_r3` (`capture_p03_fd5640_250mm_r3`) | **250mm** | `24.333` (`0.411`) | `[2.58, 2.5, 2.57, 2.58, 2.53]` | `2.57` | **1.056** | `1.0736` | `-21.31%` (giảm `21.31%`) | `39.0203` (`37.5131..39.8579`) | `2.8039x` (`180.39%`) | `1453.3859` | `1.8615x` (`86.15%`) | **ĐẠT** |
| `fd250_r4` (`capture_p03_fd5640_250mm_r4`) | **250mm** | `21.2` (`0.4717`) | `[3.0, 3.33, 3.02, 3.58, 3.31]` | `3.31` | **1.561** | `1.0736` | `16.32%` (giảm `-16.32%`) | `44.743` (`43.627..45.3501`) | `3.2151x` (`221.51%`) | `1611.1215` | `2.0635x` (`106.35%`) | **CHƯA ĐẠT** |
| `fd250_r5` (`capture_p03_fd5640_250mm_r5`) | **250mm** | `21.145` (`0.4729`) | `[2.88, 2.77, 2.81, 3.1, 2.94]` | `2.88` | **1.362** | `1.0736` | `1.49%` (giảm `-1.49%`) | `55.4143` (`53.0808..56.1415`) | `3.9819x` (`298.19%`) | `1747.6751` | `2.2384x` (`123.84%`) | **CHƯA ĐẠT** |
| `fd250_r6` (`capture_p03_fd5640_250mm_r6`) | **250mm** | `21.267` (`0.4702`) | `[3.29, 3.03, 2.93, 2.88, 3.09]` | `3.03` | **1.425** | `1.0736` | `6.18%` (giảm `-6.18%`) | `41.7433` (`40.9742..41.943`) | `2.9995x` (`199.95%`) | `1488.1471` | `1.906x` (`90.6%`) | **CHƯA ĐẠT** |
| `fd350` (`capture_fd5640_350mm`) | **350mm** | `17.467` (`0.5725`) | `[2.04, 2.0, 2.02, 1.97, 1.99]` | `2.0` | **1.145** | `0.948` | `-3.38%` (giảm `3.38%`) | `38.6278` (`38.3388..39.1284`) | `0.8333x` (`-16.67%`) | `1729.3422` | `1.1332x` (`13.32%`) | **CHƯA ĐẠT *(tham khảo, ngoài cổng D080)*** |

- **Đính chính R02 và nhận xét kỹ thuật S1:**
  1. **Đính chính số đối chứng 17/09 và nhận xét 350 mm (R02):** Khi dùng đúng tệp lịch sử `docs/logs/ruler-ticks-2026-09-17-qh{200,250,350}.json` và `docs/logs/sharpness_20260917_quang_hoc/summary.json`, tại `350 mm` (thông tin tham khảo), `lap_var_median` của FD5640 (`38.6278`) bằng **`0.8333x` (`-16.67%`, tức thấp hơn `16.67%`)** so với OV3660 lịch sử (`46.3547`), hoàn toàn **không phải tăng `1.87x`** như báo cáo Vòng 1 đã ghi nhầm; trong khi `grad_energy_median` của FD5640 (`1729.3422`) bằng **`1.1332x` (`+13.32%`)** so với OV3660 (`1526.053`).
  2. **Tại `200 mm` (`fd200`):** `edge_width_mm = 0.836 mm <= 1.0872 mm` (giảm `38.48%` so với OV3660 `1.359 mm`; `lap_var` gấp `4.5112x`, `grad_energy` gấp `2.9096x`) → **ĐẠT S1 tại 200 mm**.
  3. **Tại `250 mm` (`r1–r3` so với `r4–r6`):**
     - Ba phiên `r1`, `r2`, `r3` có `fit_px_per_cm` rất sát nhau (`24.321`, `24.381`, `24.333 px/cm` -> `mm_per_px = 0.4102..0.4112 mm/px`) và đều **ĐẠT S1** (`0.88`, `1.021`, `1.056 mm <= 1.0736 mm`).
     - Ở bộ 3 phiên `r4`, `r5`, `r6` (chụp sau khi đặt lại bố trí để chụp ảnh `docs/logs/p03-bo-tri-250mm-2026-10-12.jpg`), quan sát ảnh cho thấy khối gỗ đặt lùi sâu hơn trên bệ gỗ, mặt trước khối gỗ xoay mặt có vân gỗ sẫm ra phía camera và cây thước xoay vạch chia sang bên trái, tựa nghiêng từ mép bệ gỗ lên mặt khối gỗ (`fit_px_per_cm = 21.145..21.267 px/cm` -> `mm_per_px = 0.4702..0.4729 mm/px`). Với bố trí này, bề rộng mép toàn khối gỗ là `3.31`, `2.88`, `3.03 px` tương ứng `1.561`, `1.362`, `1.425 mm > 1.0736 mm` (**CHƯA ĐẠT S1**). Kể cả khi chỉ lấy đoạn cạnh khối gỗ trên nền tường trắng (`--edge 284,175,238`, loại bỏ vùng tiếp giáp bệ gỗ ở `y=125..174`), bề rộng mép trung vị của `r4, r5, r6` lần lượt là `2.64 px = 1.245 mm`, `2.51 px = 1.187 mm`, `2.58 px = 1.213 mm`, vẫn lớn hơn `1.0736 mm`.

---

### 6.2. S2 — Vạch mm: đếm số vạch `1 mm` nội bộ trong đoạn `1 cm` trên `5/5` ảnh mỗi phiên tại 200 mm & 250 mm

- **Định nghĩa và ngưỡng S2 (`docs/SPEC.md` §10.3, `01_PLAN.md` Vòng 3 mục 5):** Phân biệt đủ **`9/9` vạch `1 mm` nội bộ trong `1 cm`** trên **`5/5` ảnh mỗi phiên chấm tại `200 mm` và `250 mm`** trên ảnh gốc phóng to `Nearest-Neighbor` (không làm nét, không nội suy tạo chi tiết, không coi vạch `cm` tự động hay cực tiểu nhiễu 1D là vạch `1 mm` nhìn thấy bằng mắt thường).

| Nhãn / Phiên | Khoảng cách thực | Mật độ mẫu trên thước (`px/mm`) | Tệp ảnh cắt phóng to `Nearest-Neighbor` (`6x`) | Đoạn thước kiểm tra (`x`, `y`, các vạch `cm`) | Số vạch `1 mm` nội bộ phân biệt tách rời bằng mắt thường trên `5/5` ảnh | Kết luận S2 (ngưỡng `9/9`) |
| :--- | :---: | :---: | :--- | :--- | :--- | :---: |
| `fd200` (`capture_fd5640_250mm`) | **200 mm** | `3.0629 px/mm` | `docs/logs/p03_fd5640/v3/s2_mm_ticks_fd200.png` | `x=[318,361], y=[352,423]`, vạch `cm` tại `y=[356, 387, 418]` | Thấy rõ vạch `5 mm` dài hơn ở giữa và một phần các vạch `1 mm` ngắn (`~3–5/9` vạch tách rời rõ), nhưng do mỗi chu kỳ `1 mm` chỉ rộng `3.06 px` nên một số cặp vạch `1 mm` liền kề bị nhòe dính vào nhau, không tách rời đủ `9/9` vạch trên `5/5` ảnh | **CHƯA ĐẠT** |
| `fd250_r1` (`capture_p03_fd5640_250mm_r1`) | **250 mm** | `2.4321 px/mm` | `docs/logs/p03_fd5640/v3/s2_mm_ticks_fd250_r1.png` | Dải thước `x=[325, 342]`, các vạch `cm` giữa khung | Chỉ phân biệt rõ vạch `1 cm` và vạch `5 mm` ở giữa (`1/9` vạch nội bộ); 8 vạch `1 mm` ngắn hai bên hoà thành dải xám dọc sát mép thước, không tách rời bằng mắt thường | **CHƯA ĐẠT** |
| `fd250_r2` (`capture_p03_fd5640_250mm_r2`) | **250 mm** | `2.4381 px/mm` | `docs/logs/p03_fd5640/v3/s2_mm_ticks_fd250_r2.png` | Dải thước `x=[322, 339]`, các vạch `cm` giữa khung | Chỉ phân biệt rõ vạch `1 cm` và vạch `5 mm` ở giữa (`1/9` vạch nội bộ); 8 vạch `1 mm` ngắn hai bên hoà thành dải xám dọc sát mép thước, không tách rời bằng mắt thường | **CHƯA ĐẠT** |
| `fd250_r3` (`capture_p03_fd5640_250mm_r3`) | **250 mm** | `2.4333 px/mm` | `docs/logs/p03_fd5640/v3/s2_mm_ticks_fd250_r3.png` | Dải thước `x=[322, 339]`, các vạch `cm` giữa khung | Chỉ phân biệt rõ vạch `1 cm` và vạch `5 mm` ở giữa (`1/9` vạch nội bộ); 8 vạch `1 mm` ngắn hai bên hoà thành dải xám dọc sát mép thước, không tách rời bằng mắt thường | **CHƯA ĐẠT** |
| `fd250_r4` (`capture_p03_fd5640_250mm_r4`) | **250 mm** | `2.12 px/mm` | `docs/logs/p03_fd5640/v3/s2_mm_ticks_fd250_r4.png` | Dải thước `x=[306, 322]`, các vạch `cm` giữa khung | Chỉ phân biệt rõ vạch `1 cm` và vạch `5 mm` ở giữa (`1/9` vạch nội bộ); 8 vạch `1 mm` ngắn hai bên hoà thành dải xám dọc sát mép thước, không tách rời bằng mắt thường | **CHƯA ĐẠT** |
| `fd250_r5` (`capture_p03_fd5640_250mm_r5`) | **250 mm** | `2.1145 px/mm` | `docs/logs/p03_fd5640/v3/s2_mm_ticks_fd250_r5.png` | Dải thước `x=[306, 322]`, các vạch `cm` giữa khung | Chỉ phân biệt rõ vạch `1 cm` và vạch `5 mm` ở giữa (`1/9` vạch nội bộ); 8 vạch `1 mm` ngắn hai bên hoà thành dải xám dọc sát mép thước, không tách rời bằng mắt thường | **CHƯA ĐẠT** |
| `fd250_r6` (`capture_p03_fd5640_250mm_r6`) | **250 mm** | `2.1267 px/mm` | `docs/logs/p03_fd5640/v3/s2_mm_ticks_fd250_r6.png` | Dải thước `x=[306, 322]`, các vạch `cm` giữa khung | Chỉ phân biệt rõ vạch `1 cm` và vạch `5 mm` ở giữa (`1/9` vạch nội bộ); 8 vạch `1 mm` ngắn hai bên hoà thành dải xám dọc sát mép thước, không tách rời bằng mắt thường | **CHƯA ĐẠT** |
| `fd350` (`capture_fd5640_350mm`) | **350 mm** *(tham khảo)* | `1.7467 px/mm` | `docs/logs/p03_fd5640/v3/s2_mm_ticks_fd350.png` | `x=[306,344], y=[335,379]`, vạch `cm` tại `y=[339, 356, 374]` | Dưới ngưỡng lấy mẫu Nyquist 2D (`< 2.0 px/mm`), chỉ thấy vạch `1 cm` và gợn mờ vạch `5 mm` (`0–1/9` vạch) | **CHƯA ĐẠT** *(ngoài cổng D080)* |

---

### 6.3. S3 — Ổn định thu ảnh ngắn hạn tại 250 mm (`30/30` ảnh `r1–r6`) và 200 mm (`5/5` ảnh hiện có)

| Nhãn | `session_id` | Khoảng cách thực | Ảnh đạt / yêu cầu | `retries` / `errors` / `identical_to_prev` | Phép so `ts_delta_ms > 0` (`count - 1`) | Danh sách `ts_delta_ms` (`frames.csv`, ms) | `elapsed_ms` `min / median / mean / max` (`frames.csv`, ms) | Kết luận S3 |
| :--- | :--- | :---: | :-: | :-: | :-: | :--- | :---: | :---: |
| `fd200` | `capture_fd5640_250mm` | **200 mm** | `5/5` | `0 / 0 / 0` | `4/4` | `[630, 2883, 3063, 2973]` | `55.9 / 102.1 / 103.84 / 143.3` | **ĐẠT** |
| `fd250_r1` | `capture_p03_fd5640_250mm_r1` | **250 mm** | `5/5` | `0 / 0 / 0` | `4/4` | `[541, 3063, 2973, 2973]` | `36.5 / 40.2 / 61.64 / 119.1` | **ĐẠT** |
| `fd250_r2` | `capture_p03_fd5640_250mm_r2` | **250 mm** | `5/5` | `0 / 0 / 0` | `4/4` | `[720, 2793, 3334, 2883]` | `228.6 / 410.8 / 627.62 / 1694.4` | **ĐẠT** |
| `fd250_r3` | `capture_p03_fd5640_250mm_r3` | **250 mm** | `5/5` | `0 / 0 / 0` | `4/4` | `[631, 3063, 3333, 2883]` | `252.6 / 364.9 / 372.48 / 460.2` | **ĐẠT** |
| `fd250_r4` | `capture_p03_fd5640_250mm_r4` | **250 mm** | `5/5` | `0 / 0 / 0` | `4/4` | `[585, 3018, 3018, 3063]` | `108.8 / 185.8 / 440.24 / 1386.5` | **ĐẠT** |
| `fd250_r5` | `capture_p03_fd5640_250mm_r5` | **250 mm** | `5/5` | `0 / 0 / 0` | `4/4` | `[631, 3063, 2973, 3063]` | `47.4 / 89.3 / 139.68 / 310.4` | **ĐẠT** |
| `fd250_r6` | `capture_p03_fd5640_250mm_r6` | **250 mm** | `5/5` | `0 / 0 / 0` | `4/4` | `[1262, 2702, 2883, 3604]` | `354.4 / 957.8 / 1048.42 / 2278.5` | **ĐẠT** |
| `fd350` | `capture_fd5640_350mm` | **350 mm** | `5/5` | `0 / 0 / 0` | `4/4` | `[901, 3063, 3063, 3153]` | `341.5 / 462.1 / 797.34 / 2369.9` | PASS *(tham khảo, ngoài cổng D080)* |

- **Tổng hợp S3 theo `01_PLAN.md` Vòng 3 mục 5:**
  - **Tại điểm chính `250 mm`:** Chấm toàn bộ **6 phiên `r1–r6` = `30/30` ảnh hợp lệ** (vượt mốc tối thiểu `15/15` ảnh), `0` retry, `0` lỗi kết nối, `0` reset bất ngờ trong phiên, `0` ảnh trùng hoặc timestamp trùng/lùi, đủ **`24/24` phép so timestamp** (`4/4` mỗi phiên) → **ĐẠT S3 tại 250 mm**.
  - **Tại điểm phụ `200 mm` (thay 350 mm theo D080):** Phiên hiện có `capture_fd5640_250mm` (`fd200`) đạt **`5/5` ảnh hợp lệ**, `0` retry/lỗi/reset bất ngờ/trùng hoặc lùi timestamp, đủ **`4/4` phép so timestamp** → **ĐẠT cổng 1 phiên hiện có tại 200 mm** (khi thu thêm 3 phiên `200 mm` cho S4 thì toàn bộ ảnh mới sẽ được tính tiếp vào S3).

---

### 6.4. S4 — Tiêu điểm cố định có ghi nhận và độ biến thiên bề rộng mép `(max(E_i) - min(E_i)) / median(E_i) <= 10%`

1. **Bằng chứng ghi nhận cố định tiêu điểm và bố trí (`01_PLAN.md` Vòng 3 mục 2 & 5):**
   - Mã nguồn `firmware/esp32s3/CameraWebServerTest/` không nạp firmware VCM và không có lệnh điều khiển AF; khả năng khoá AF phần cứng chưa biết nên ghi đúng quy ước: **`"tiêu điểm ổn định trong bố trí/chuỗi ảnh đã thử; khả năng khoá AF CHƯA KIỂM CHỨNG"`**.
   - Tại `250 mm`, người dùng đã cung cấp ảnh bố trí `docs/logs/p03-bo-tri-250mm-2026-10-12.jpg` và xác nhận bộ 3 phiên **`r4 + r5 + r6` (15 ảnh)** có cùng một bố trí cố định, không chỉnh ống kính/không chạy lấy nét giữa các ảnh và các lượt (`r4` ở lần khởi động Boot 2; `r5 + r6` ở lần khởi động Boot 3 kế tiếp).
2. **Bảng tính độ biến thiên `E_i` tại `250 mm` và `200 mm` (trích trực tiếp từ `docs/logs/p03_fd5640/v3/summary_comparison_v3.json`):**

| Bộ dữ liệu / Phiên | Khoảng cách | Số ảnh | Danh sách `E_i` theo `px` | `min / median / max` (`px`) | Biến thiên theo `px` | Danh sách `E_i` theo `mm` | `min / median / max` (`mm`) | Biến thiên `(max - min) / median` theo `mm` | Ngưỡng S4 | Kết luận S4 |
| :--- | :---: | :-: | :--- | :---: | :---: | :--- | :---: | :---: | :---: | :---: |
| **Bộ chính thức S4 tại 250 mm: `r4 + r5 + r6` (toàn cạnh khối `--edge 284,125,238`)** | **250 mm** | **15** | `[3.0, 3.33, 3.02, 3.58, 3.31, 2.88, 2.77, 2.81, 3.1, 2.94, 3.29, 3.03, 2.93, 2.88, 3.09]` | `2.77 / 3.02 / 3.58` | `26.82%` | `[1.4151, 1.5708, 1.4245, 1.6887, 1.5613, 1.362, 1.3099, 1.3288, 1.466, 1.3903, 1.547, 1.4247, 1.3777, 1.3542, 1.4529]` | `1.3099 / 1.4245 / 1.6887` | **26.59%** *(cùng hệ số `mm/px`: `26.82%`)* | `<= 10.0%` | **CHƯA ĐẠT** |
| *Kiểm nhạy bộ `r4 + r5 + r6` riêng đoạn nền tường trắng (`--edge 284,175,238`)* | **250 mm** | **15** | `[2.45, 2.64, 2.61, 2.86, 2.93, 2.49, 2.49, 2.51, 2.65, 2.59, 2.73, 2.58, 2.47, 2.54, 2.62]` | `2.45 / 2.59 / 2.93` | `18.53%` | *(tính từ `mm_per_px` từng phiên)* | `1.1557 / 1.2248 / 1.3821` | **18.49%** | `<= 10.0%` | *CHƯA ĐẠT* |
| *Truy nguyên cặp `r2 + r3` (cùng Boot 1, 2 phiên = 10 ảnh)* | **250 mm** | `10/15` | `[2.49, 2.49, 2.45, 2.56, 2.58, 2.58, 2.5, 2.57, 2.58, 2.53]` | `2.45 / 2.545 / 2.58` | `5.11%` | `[1.0214, 1.0214, 1.005, 1.0501, 1.0583, 1.0604, 1.0275, 1.0563, 1.0604, 1.0398]` | `1.005 / 1.045 / 1.0604` | `5.3%` | `<= 10.0%` | *Chỉ 10/15 ảnh (truy nguyên)* |
| *Truy nguyên nội phiên `fd250_r1`* | **250 mm** | `5/15` | `[2.12, 2.14, 2.14, 2.13, 2.21]` | `2.12 / 2.14 / 2.21` | `4.21%` | `[0.8717, 0.88, 0.88, 0.8759, 0.9088]` | `0.8717 / 0.88 / 0.9088` | `4.21%` | `<= 10.0%` | *Nội phiên (5 ảnh)* |
| *Truy nguyên nội phiên `fd250_r2`* | **250 mm** | `5/15` | `[2.49, 2.49, 2.45, 2.56, 2.58]` | `2.45 / 2.49 / 2.58` | `5.22%` | `[1.0214, 1.0214, 1.005, 1.0501, 1.0583]` | `1.005 / 1.021 / 1.0583` | `5.22%` | `<= 10.0%` | *Nội phiên (5 ảnh)* |
| *Truy nguyên nội phiên `fd250_r3`* | **250 mm** | `5/15` | `[2.58, 2.5, 2.57, 2.58, 2.53]` | `2.5 / 2.57 / 2.58` | `3.11%` | `[1.0604, 1.0275, 1.0563, 1.0604, 1.0398]` | `1.0275 / 1.056 / 1.0604` | `3.11%` | `<= 10.0%` | *Nội phiên (5 ảnh)* |
| *Truy nguyên nội phiên `fd250_r4`* | **250 mm** | `5/15` | `[3.0, 3.33, 3.02, 3.58, 3.31]` | `3.0 / 3.31 / 3.58` | `17.52%` | `[1.4151, 1.5708, 1.4245, 1.6887, 1.5613]` | `1.4151 / 1.561 / 1.6887` | `17.52%` | `<= 10.0%` | *Nội phiên (5 ảnh)* |
| *Truy nguyên nội phiên `fd250_r5`* | **250 mm** | `5/15` | `[2.88, 2.77, 2.81, 3.1, 2.94]` | `2.77 / 2.88 / 3.1` | `11.46%` | `[1.362, 1.3099, 1.3288, 1.466, 1.3903]` | `1.3099 / 1.362 / 1.466` | `11.46%` | `<= 10.0%` | *Nội phiên (5 ảnh)* |
| *Truy nguyên nội phiên `fd250_r6`* | **250 mm** | `5/15` | `[3.29, 3.03, 2.93, 2.88, 3.09]` | `2.88 / 3.03 / 3.29` | `13.53%` | `[1.547, 1.4247, 1.3777, 1.3542, 1.4529]` | `1.3542 / 1.425 / 1.547` | `13.53%` | `<= 10.0%` | *Nội phiên (5 ảnh)* |
| **Tại 200 mm: hiện có `fd200` (`capture_fd5640_250mm`)** | **200 mm** | **`5/15`** | `[2.55, 2.57, 2.62, 2.56, 2.52]` | `2.52 / 2.56 / 2.62` | `3.91%` | `[0.8326, 0.8391, 0.8554, 0.8358, 0.8228]` | `0.8228 / 0.836 / 0.8554` | `3.91%` *(nội phiên 5 ảnh)* | `<= 10.0%` *(cần 15 ảnh)* | **CHƯA ĐỦ DỮ LIỆU** |

---

### 6.5. S5 — Chỉ báo tăng nhiệt lõi chip ESP32-S3 tương đối (Đồng bộ `p15` Vòng 2 — Chờ `p15` qua cổng)

- **Hợp đồng S5 đã cập nhật theo `01_PLAN.md` Vòng 3 mục 5 & `docs/SPEC.md` §10.3:**
  - Chỉ nhận phản hồi HTTP `200`, `valid=true`, `temperature_c` hữu hạn trong **`[-10, 80] °C`**, `configured_min_c=-10`, `configured_max_c=80`, có boot ID và uptime phù hợp (đây là dải cấu hình/kiểm ứng dụng, không phải dải phần cứng đã đọc từng mẫu; **bỏ** yêu cầu `range_reg`/`range_min`/`max`/`error_max` từng mẫu, giao dải động, cửa sổ `-5...75 °C` và biên tham khảo `4 °C` của Vòng 2).
  - Giữ 3 cặp lượt `OV/FD` đổi thứ tự (`OV->FD`, `FD->OV`, `OV->FD`), hai baseline chênh `<= 2 °C`, cùng bo/firmware/tải/điều kiện và 6 mốc `0, 5, 15, 30, 60, 120 s` (sai lệch `<= 2 s`).
  - Với `d(k,t) = [T_FD(k,t) - T_FD(k,0)] - [T_OV(k,t) - T_OV(k,0)]` và `D_k = max_t d(k,t)`: đủ mẫu hợp lệ cả 3 cặp và mọi `D_k <= 5 °C` -> **`ĐẠT theo chỉ báo`**; có cặp đầy đủ `D_k > 5 °C` -> **`CHƯA ĐẠT theo chỉ báo`**; thiếu/lỗi/reset trong lượt/sai thời điểm -> **`CHƯA ĐỦ DỮ LIỆU`**.
- **Trạng thái hiện tại tại mốc `B_A` Vòng 2:**
  - **S5 (chỉ báo tăng nhiệt lõi chip ESP32-S3):** **`CHƯA ĐO`** (đầu việc `p15` mới ở trạng thái `SẴN SÀNG CHO TESTER`, chưa qua cổng Reviewer/bo).
  - **Nhiệt độ bề mặt module camera / IC ổn áp:** **`CHƯA ĐO`** (luôn giữ nhãn `CHƯA ĐO` kể cả sau khi có S5).

---

## 7. Danh mục tệp đầu ra và bằng chứng lưu trữ trong Git

1. **Metadata gốc nguyên byte của 8 phiên chụp FD5640 (56 tệp trong `docs/logs/`):**
   - Ngày 11/10 (21 tệp): `docs/logs/{capture_fd5640_250mm,capture_fd5640_350mm,capture_p03_fd5640_250mm_r1}/`
   - Ngày 12/10 (35 tệp mới ở Vòng 2): `docs/logs/capture_p03_fd5640_250mm_r{2,3,4,5,6}/`
2. **Bằng chứng văn bản Serial Monitor và ảnh bố trí ngày 12/10 (trên `main`):**
   - `docs/logs/serial_fd5640_p03_20261012.txt` (18 dòng người dùng chép từ `Serial Monitor` trước `r2`)
   - `docs/logs/p03-bo-tri-250mm-2026-10-12.jpg` (ảnh bố trí `250 mm` lúc chụp `r4–r6`)
3. **Đầu ra phân tích định lượng Vòng 2 (`docs/logs/p03_fd5640/v3/`, giữ nguyên `v2/`):**
   - Manifest 11 phiên / 55 ảnh: `docs/logs/p03_fd5640/v3/manifest_images_sha256.json`, `docs/logs/p03_fd5640/v3/manifest_images_sha256.csv`
   - Đầu ra `pc/ruler_ticks.py`: `docs/logs/p03_fd5640/v3/ruler-ticks-v3-{fd200,fd250-r1,fd250-r2,fd250-r3,fd250-r4,fd250-r5,fd250-r6,fd350,qh200,qh250,qh350}.json` và kiểm nhạy tường trắng `ruler-ticks-v3-fd250-r{4,5,6}-wall.json`
   - Đầu ra `pc/sharpness.py --annotate`: `docs/logs/p03_fd5640/v3/sharpness-v3-{fd200,fd250-r1,fd250-r2,fd250-r3,fd250-r4,fd250-r5,fd250-r6,fd350,qh-hist}/`
   - Ảnh phóng to `Nearest-Neighbor` kiểm S2: `docs/logs/p03_fd5640/v3/s2_mm_ticks_{fd200,fd250_r1,fd250_r2,fd250_r3,fd250_r4,fd250_r5,fd250_r6,fd350}.png`
   - Bảng tổng hợp JSON đối chiếu S1–S4 và lịch sử 17/09: `docs/logs/p03_fd5640/v3/summary_comparison_v3.json`

---

## 8. Kết luận Phần A (Mốc `B_A` Vòng 2) và điều kiện tiếp theo

1. **Tổng hợp trạng thái từng tiêu chí tại mốc `B_A` Vòng 2 (theo D080 & `01_PLAN.md` Vòng 3):**
   - **S1 (Độ nét — giảm bề rộng mép `>= 20%` theo `mm` ở `200 mm` và `250 mm`):** **ĐẠT tại `200 mm`** (`fd200 = 0.836 mm <= 1.0872 mm`, giảm `38.48%`) và **ĐẠT trên 3 phiên `r1–r3` tại `250 mm`** (`0.880, 1.021, 1.056 mm <= 1.0736 mm`), nhưng **CHƯA ĐẠT trên 3 phiên `r4–r6` tại `250 mm`** (`1.561, 1.362, 1.425 mm > 1.0736 mm` khi bố trí khối gỗ/thước đặt lùi và xoay nghiêng).
   - **S2 (`9/9` vạch `1 mm` nội bộ trong `1 cm` trên `5/5` ảnh tại `200 mm` và `250 mm`):** **CHƯA ĐẠT** tại cả `200 mm` và `250 mm` (`r1–r6`).
   - **S3 (Ổn định thu ảnh ngắn hạn tại `250 mm` và `200 mm`):** **ĐẠT** tại cả `250 mm` (`30/30` ảnh của `r1–r6`, `0` lỗi/retry/reset bất ngờ/trùng hoặc lùi timestamp, đủ `24/24` phép so timestamp) và `200 mm` (`5/5` ảnh hiện có, `0` lỗi, đủ `4/4` phép so timestamp).
   - **S4 (Độ biến thiên bề rộng mép `<= 10%` trên 15 ảnh cùng bố trí ở mỗi khoảng cách):** **CHƯA ĐẠT tại `250 mm`** (`26.59% > 10%` theo `mm` trên bộ 15 ảnh `r4 + r5 + r6`; kiểm nhạy riêng nền tường trắng là `18.49% > 10%`) và **CHƯA ĐỦ DỮ LIỆU tại `200 mm`** (mới có 1/3 phiên = 5/15 ảnh).
   - **S5 (Chỉ báo tăng nhiệt lõi chip ESP32-S3 tương đối):** **CHƯA ĐO** (chờ `p15` qua cổng Reviewer/bo); **nhiệt độ bề mặt module camera/ổn áp luôn `CHƯA ĐO`**.
2. **Khuyến nghị kỹ thuật tại mốc `B_A` Vòng 2:**
   - Do camera FD5640 chưa đạt đồng bộ bộ tiêu chí S1–S4 tại `200 mm` và `250 mm` (S2 chưa đạt ở cả hai khoảng cách; S1 và S4 chưa đạt trên bộ 15 ảnh `r4–r6` ở `250 mm`; S4 ở `200 mm` chưa đủ 15 ảnh; S5 chờ `p15`), **chưa khuyến nghị thay hẳn OV3660 bằng FD5640**. Giữ FD5640 ở trạng thái camera thử theo D076/D077/D080.
