hungmap0312/3D-Scanner/docs/tests/2026-09-17_s3_quang_hoc.md

# Khảo sát quang học S3 + OV3660 tại 200, 250, 350 mm — 2026-09-17

Theo `docs/TEST_TEMPLATE.md`. Chỉ tiêu đối chiếu: tuần 1, MT "Quang học":
"Chọn được khoảng cách nhìn rõ vật 50–100 mm; lưu ảnh chứng minh độ nét và
vùng quan sát" (`docs/reference/Roadmap_14_tuan_...docx`, phần Tuần 1).
Tiêu chí chọn khoảng cách khai báo TRƯỚC khi đo trong `STATUS.md`, mục
"Mục tiêu phiên 3" (commit `236f5c0`, 16/09 21:15).

- **Mục tiêu phép thử:** đo mm/pixel, trường nhìn và độ nét tại ba khoảng
  cách camera–vật; chọn khoảng cách làm việc cho tuần 2 hoặc kết luận chưa
  đạt kèm số đo.
- **Bo / camera / revision:** ESP32-S3, nhãn module `ESP32-S3 WROOM`
  (`docs/logs/s3-board-mounted-2026-09-17.jpg`), camera OV3660 (PID 0x3660),
  cấu hình D008 (`OPI PSRAM`). Bo gắn trên perfboard xanh, kẹp trong chân đế
  trắng, module camera ở sát mép trên kẹp sau khi lật bo 180°.
- **Nguồn cấp và kết nối:** USB từ máy tính; Wi-Fi nội bộ, IP `192.168.31.9`.
- **Hệ điều hành, IDE, board package:** theo `ENVIRONMENT.md`; firmware là
  `CameraWebServerTest` đã nạp 16/09 (không nạp lại trong phép thử này).
- **Mã nguồn / commit / thay đổi chưa commit:** chụp bằng
  `pc/capture_session.py` tại commit `9839263`, working tree sạch (ghi trong
  `session.json`). Phân tích bằng `pc/ruler_ticks.py` và `pc/sharpness.py`
  trong nhánh `feat/quang-hoc-phan-tich`.
- **Toàn bộ cài đặt build liên quan:** không build gì mới.
- **Cổng và tốc độ Serial:** không dùng Serial; HTTP `/capture`, `/control`,
  `/status`.
- **Cấu hình camera lúc chụp** (`status_start.json`/`status_end.json`, giống
  nhau ở cả ba phiên): `framesize` 10 (VGA 640×480), `quality` 10, `aec` 1,
  `aec_value` 490, `agc` 1, `agc_gain` 2, `awb` 1; chỉ hai thanh ghi AWB
  0x3400/0x3404 nhích vài đơn vị trong phiên. Phơi sáng KHÔNG đổi giữa ba
  phiên, nên độ sáng so được.
- **Đính chính 2026-09-20** (theo `docs/reviews/REVIEW_2026-09-20_main.md`,
  giữ nguyên đoạn trên làm lịch sử): `aec=1`, `agc=1`, `awb=1` nghĩa là tự
  động còn bật; thanh ghi AWB đổi đầu→cuối 0x3400 1362→1352 / 1362→1370 /
  1365→1362, 0x3404 1697→1691 / 1680→1690 / 1684→1671, và 0x5585 57→56 ở
  350 mm (200/250/350 mm). `aec_value`/`agc_gain` là giá trị đặt đọc từ
  `s->status`, không phải thanh ghi thực; chỉ 0x3500 = 12544 và 0x350a = 248
  không đổi. Kết luận đúng: tham số CHƯA khoá; số đo trường nhìn và bề rộng
  mép không phụ thuộc cân bằng trắng nên vẫn dùng được; so độ sáng giữa ảnh
  chưa có cơ sở cho tới khi C2 tắt `aec/agc/awb` và chụp lại.

## Bước tái hiện

Theo `docs/procedures/quy-trinh-khao-sat-quang-hoc.md` phần A–D (khi chạy 17/09 quy trình này nằm trong `STATUS.md`; chuyển tệp 22/09, D031). Bố trí thực
tế (NGƯỜI DÙNG CUNG CẤP qua ảnh và tin nhắn 17/09; ba ảnh bố trí còn trong
chat, chưa lưu repo):

- Vật: khối gỗ 30×32×49 mm, mặt 32×49 có chữ viết tay và vạch bút chì quay
  về camera, dựng đứng theo cạnh 49 mm.
- Thước: thước nhựa trong ~15 cm, thang cm/mm, dựng đứng trên mặt bệ, tựa
  vào mặt trước khối, vạch 0 ở dưới, chân thước sát chân khối.
- Bệ: miếng gỗ cao 20 mm dưới khối; tâm ống kính cao `H` = 65 mm so với mặt
  bàn (người dùng đo) → khối chiếm 20–69 mm, trục ống kính trong nửa trên
  khối.
- Khoảng cách: đo trên bàn từ hình chiếu mặt trước ống kính (mốc 0) tới
  mặt trước khối, ba vạch 200, 250, 350 mm kẻ bằng băng dính.
- Ánh sáng: đèn phòng cộng ánh sáng cửa sổ qua rèm, cửa sổ ở phía sau bo;
  không nắng trực tiếp. Ba phiên liền nhau 13:34, 13:38, 13:41.
- Phông sau khối theo hướng camera: tường trắng.
- Lệnh: `capture_session.py --framesize VGA --count 5 --interval 3 --warmup 5
  --session-id capture_qh_{200,250,350}mm --meta-copy docs/logs`.
- LƯU Ý về `--note`: người dùng để nguyên chuỗi mẫu "thuoc dan mat truoc,
  vach 0 ben trai; den phong" — KHÔNG đúng bố trí thật (thước dựng đứng,
  vạch 0 ở dưới, có ánh sáng cửa sổ). Bố trí thật ghi ở đây và trong
  `STATUS.md`; `--note` trong `session.json` không dùng làm nguồn.

Phân tích, chạy trong môi trường trợ lý trên ảnh gốc `data/raw/`:

1. `pc/ruler_ticks.py <phiên> --band X0,X1,Y0,Y1 --lag LO,HI --edge X,Y0,Y1`
   với dải cột thước trên nền tường (200: `318,338,4,182`, trễ `25,70`;
   250: `322,340,4,188`, `18,60`; 350: `328,340,4,194`, `15,32`) và cạnh
   trái khối (200: `255,200,380`; 250: `280,205,340`; 350: `297,210,305`).
   Kết quả JSON `docs/logs/ruler-ticks-2026-09-17-qh{200,250,350}.json`.
2. `pc/sharpness.py` ba phiên, ROI theo quy tắc khai báo (trùm đoạn thước
   nhìn thấy và mặt trước khối; riêng từng phiên): 200 `255,0,120,395`,
   250 `280,0,95,350`, 350 `297,0,71,312`; `--ruler` lấy từ đường khớp vạch
   của bước 1. Hồ sơ `docs/logs/sharpness_20260917_quang_hoc/` (per_image.csv,
   summary.json, summary.txt, ba ảnh chú thích), log
   `docs/logs/pc-sharpness-quang-hoc-2026-09-17.log`.

## Kết quả mong đợi

Một trong ba khoảng cách cho vạch mm phân biệt được bằng mắt trong ảnh gốc,
trường nhìn ngang ≥ 150 mm, và `lap_var` trên ROI cao nhất → chọn khoảng
cách đó (tiêu chí 1–3). Không khoảng cách nào phân biệt được vạch mm →
CHƯA ĐẠT (tiêu chí 4).

## Kết quả quan sát thực tế

Ba phiên chụp PASS 5/5, 0 chụp lại, 0 reset (`summary.txt` từng phiên).

| Khoảng cách | Vạch cm tìm thấy | px/cm (khớp thẳng, sai lệch tối đa) | mm/px | Trường nhìn ngang × dọc (mm) | Bề rộng mép 10–90 % (px) | Bề rộng mép (mm ở mặt vật) | `lap_var` trung vị (min–max) | `grad_energy` | `mean` ROI |
| --- | --- | --- | --- | --- | --- | --- | --- | --- | --- |
| 200 mm | 4 | 41,20 (1,9 px) | 0,2427 | 155,3 × 116,5 | 5,60 | 1,36 | 10,3 (10,2–10,5) | 525 | 142 |
| 250 mm | 6 | 32,20 (0,6 px) | 0,3106 | 198,8 × 149,1 | 4,32 | 1,34 | 13,9 (13,6–14,5) | 781 | 152 |
| 350 mm | 9 | 22,70 (1,7 px) | 0,4405 | 281,9 × 211,5 | 2,69 | 1,19 | 46,4 (42,1–48,8) | 1526 | 159 |

- Chu kỳ vạch ổn định giữa 5 ảnh mỗi phiên (lệch ≤ 0,2 px); tự tương quan
  0,55 / 0,77 / 0,64. Tỉ lệ px/cm 1 : 0,78 : 0,55 gần nghịch đảo khoảng cách
  1 : 0,80 : 0,57 — ba khoảng cách tự kiểm chéo nhau, sai lệch vài %.
- Bão hoà 0 %, tối 0 % trong ROI ở cả ba phiên; `mean` 142–159.
- Bằng mắt (trợ lý xem ảnh gốc và ảnh cắt phóng 4×; người dùng cũng nhận
  xét độc lập): cả ba ảnh mờ và có màn sương (haze) mờ đục toàn khung; vạch
  cm là vệt mờ, **vạch mm không phân biệt được ở khoảng cách nào**; chữ viết
  tay trên khối không đọc được. Người dùng thấy 200 mm "rõ nhất" (định
  tính); số đo `lap_var` và bề rộng mép theo pixel lại tốt nhất ở 350 mm.
- Tệp JPEG VGA chỉ ~10,5 KB mỗi ảnh (so với ~16 KB ảnh SVGA hôm 16/09), phù
  hợp với ảnh ít chi tiết.
- Một chấm sáng xanh lục trên thước ở cả ba phiên, cùng vị trí tương đối:
  nhiều khả năng phản chiếu LED trên bo qua mặt nhựa. Nằm ngoài dải cột đo,
  không ảnh hưởng số đo.

## Log nguyên văn đã bỏ thông tin bí mật

`docs/logs/capture_qh_{200,250,350}mm/summary.txt`, `session.json`,
`frames.csv`; `docs/logs/ruler-ticks-2026-09-17-qh*.json`;
`docs/logs/sharpness_20260917_quang_hoc/summary.txt`;
`docs/logs/pc-sharpness-quang-hoc-2026-09-17.log`;
`docs/logs/pc-ruler-ticks-selftest-2026-09-17.log`. Không có bí mật trong
các tệp này.

## Ảnh gốc / ảnh dây / ảnh cấu hình đi kèm

- Ảnh gốc đại diện (chép nguyên byte từ `data/raw/`):
  `docs/logs/quang-hoc-2026-09-17-{200,250,350}mm-img0003.jpg`.
- Ảnh chú thích ROI và đoạn thước:
  `docs/logs/sharpness_20260917_quang_hoc/annotated_capture_qh_*.jpg`.
- Ảnh bo và gá: `docs/logs/s3-board-mounted-2026-09-17.jpg` (gá lần đầu,
  camera ở đỉnh; sau đó đã lật bo).
- Ảnh bố trí ba khoảng cách: `docs/logs/quang-hoc-bo-tri-2026-09-17-{200,250,350}.jpg`
  (NGƯỜI DÙNG CUNG CẤP, ĐÃ KIỂM Ở ĐÂY bằng Pillow: JPEG 1124×843, vào Git 17/09).

## Thời gian chạy và số lần thử thực tế

Ba phiên, mỗi phiên 5 ảnh + 5 khung làm nóng, 12,4–12,6 s; một lần duy nhất
cho mỗi khoảng cách, không chụp lại. Phân tích chạy 17/09 13:57.

## Kết luận có thể rút ra

1. **Trường nhìn** (tiêu chí 1, ≥ 150 mm): cả ba đạt; 200 mm sát ngưỡng
   (155 mm), 250 mm cho 199 × 149 mm, 350 mm cho 282 × 212 mm. Đây là số
   đo tin cậy nhất của phép thử (ba phiên tự kiểm chéo).
2. **Độ nét** (tiêu chí 2–4): bề rộng mép quy ra mm ở mặt vật gần như
   không đổi, 1,19–1,36 mm, trong khi tính bằng pixel giảm 5,6 → 4,3 → 2,7.
   Mờ cỡ 1,2–1,4 mm ở mặt vật tại mọi khoảng cách là hình ảnh của **ống kính
   lấy nét ở xa**: khi tiêu điểm ở xa, vết mờ trong không gian vật xấp xỉ
   đường kính khẩu độ, không phụ thuộc khoảng cách. Khớp thô mô hình
   `blur = A·(1 − d/d_f)` cho `d_f` ≈ 1,4 m và `A` ≈ 1,6 mm (GIẢ THUYẾT từ
   ba điểm đo, chưa kiểm chứng độc lập). Với 0,24–0,44 mm/px, vết mờ này là
   3–6 px nên vạch mm (1 mm) không thể phân giải ở cả ba khoảng cách.
3. **Kết luận theo tiêu chí đã khai báo:** rơi vào **tiêu chí 4 → CHƯA ĐẠT**.
   Không hạ ngưỡng. `lap_var` cao nhất ở 350 mm không được dùng để ghi đạt,
   vì số đó lợi cho vật ở xa (nhiều mép trên mỗi pixel) và vạch mm vẫn không
   phân biệt được.
4. Trong ba khoảng cách, **250 mm** là ứng viên khoảng cách làm việc nếu tiêu
   điểm được chỉnh: trường nhìn 199 × 149 mm chứa vật 100 mm và mâm xoay
   ~120–150 mm có biên; 0,31 mm/px nghĩa là sai 1 px ≈ 0,3 mm, dưới mục tiêu
   2 mm; nằm giữa dải để sau khi lấy nét tại 250 còn độ sâu trường ảnh cho
   200–300. Đây là ĐỀ XUẤT, chờ người dùng xác nhận (D015).
5. Màn sương toàn khung: NGƯỜI DÙNG XÁC NHẬN sau phép thử đã bóc màng bảo
   vệ trước khi chụp và ống kính sạch, nên loại trừ màng và bụi; còn loá
   cửa sổ hoặc chất lượng ống kính, chưa tách.

## Điều chưa thể kết luận

- Ống kính có chỉnh được tiêu cự không: ảnh cận module 17/09 cho thấy
  barrel có vành khía, nhưng NGƯỜI DÙNG THỬ 17/09 với lực vừa: cứng, không
  hề di chuyển (báo 18/09). Với module này coi là không chỉnh được bằng tay.
- Phần haze do ống kính hay do ánh sáng cửa sổ: cần một phiên chụp rèm kín
  chỉ đèn phòng để tách.
- Khoảng cách thật so với vạch kẻ: sai vài mm theo cách đo bằng thước trên
  bàn; tỉ lệ px/cm cho thấy lệch vài %, không ảnh hưởng kết luận.
- Ảnh hưởng của `quality` 10 và giảm mẫu trên bo tới bề rộng mép: không
  tách được khỏi mờ quang học trong phép thử này; nhưng mờ đổi theo khoảng
  cách nên không thể chỉ do nén.

## Bước thử tiếp theo

1. ĐÃ LÀM 17/09: màng bảo vệ đã bóc trước phép thử, ống kính sạch, barrel
   có vành khía (ảnh cận trong chat, đề nghị lưu
   `docs/logs/s3-camera-module-2026-09-17.jpg`).
2. ĐÃ THỬ 17/09 (NGƯỜI DÙNG BÁO): barrel không xoay được, dừng không cố.
   Thay bằng: kính lão +3.00 D (và +3.50) đặt trước ống kính — từ số đo
   này, ống kính ≈ 0,7 đi-ốp (1,4 m), cần 4 đi-ốp cho 250 mm; quy trình
   bước 3.8 trong `STATUS.md`. Song song mua module dự phòng (B12).
3. Chụp lại phiên 250 mm (`capture_qh_250mm_lan2`), chạy lại
   `ruler_ticks.py` và `sharpness.py`; so bề rộng mép với 4,32 px. Nếu đạt,
   chụp thêm 200 và 350 để biết độ sâu trường ảnh, rồi đánh giá lại tiêu
   chí 1–4.
4. Một phiên rèm kín, chỉ đèn phòng, tại 250 mm để tách haze do ánh sáng.
