hungmap0312/3D-Scanner/firmware/stm32/NucleoPing/Core/Src/main.c

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
/* Includes ------------------------------------------------------------------*/
#include "main.h"

/* USER CODE BEGIN Includes */
#include "ping_proto.h"
/* USER CODE END Includes */

UART_HandleTypeDef huart2;

/* USER CODE BEGIN PV */
static IWDG_HandleTypeDef hiwdg;
/* USER CODE END PV */

void SystemClock_Config(void);
static void MX_GPIO_Init(void);
static void MX_USART2_UART_Init(void);
/* USER CODE BEGIN PFP */
static void MX_IWDG_Init(void);
/* USER CODE END PFP */

/**
  * @brief  The application entry point.
  * @retval int
  */
int main(void)
{

  /* USER CODE BEGIN 1 */
  ping_early_safety_init();
  /* USER CODE END 1 */

  /* MCU Configuration--------------------------------------------------------*/

  /* Reset of all peripherals, Initializes the Flash interface and the Systick. */
  HAL_Init();

  /* Configure the system clock */
  SystemClock_Config();

  /* Initialize all configured peripherals */
  MX_GPIO_Init();
  MX_USART2_UART_Init();
  /* USER CODE BEGIN 2 */
  ping_init(&huart2);
  MX_IWDG_Init();
  ping_set_iwdg(&hiwdg);
  /* USER CODE END 2 */

  /* Infinite loop */
  /* USER CODE BEGIN WHILE */
  while (1)
  {
    /* USER CODE END WHILE */

    /* USER CODE BEGIN 3 */
    ping_poll();
  }
  /* USER CODE END 3 */
}

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
/* USER CODE BEGIN 4 */
static void MX_IWDG_Init(void)
{
  hiwdg.Instance = IWDG;
  hiwdg.Init.Prescaler = IWDG_PRESCALER_32;
  hiwdg.Init.Reload = 1000;
  if (HAL_IWDG_Init(&hiwdg) != HAL_OK)
  {
    Error_Handler();
  }
}
/* USER CODE END 4 */
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
