hungmap0312/3D-Scanner/firmware/stm32/NucleoPing/Core/Inc/main.h

#define B1_Pin GPIO_PIN_13
#define B1_GPIO_Port GPIOC
#define USART_TX_Pin GPIO_PIN_2
#define USART_TX_GPIO_Port GPIOA
#define USART_RX_Pin GPIO_PIN_3
#define USART_RX_GPIO_Port GPIOA
#define LD2_Pin GPIO_PIN_5
#define LD2_GPIO_Port GPIOA
#define TMS_Pin GPIO_PIN_13
#define TMS_GPIO_Port GPIOA
#define TCK_Pin GPIO_PIN_14
#define TCK_GPIO_Port GPIOA
#define SWO_Pin GPIO_PIN_3
#define SWO_GPIO_Port GPIOB
#define LASER_Pin GPIO_PIN_8
#define LASER_GPIO_Port GPIOA
#define SENSE_PWR_Pin GPIO_PIN_9
#define SENSE_PWR_GPIO_Port GPIOA
#define SENSE_ESTOP_Pin GPIO_PIN_7
#define SENSE_ESTOP_GPIO_Port GPIOC
