hungmap0312/3D-Scanner/firmware/stm32/NucleoPing/test/tester_c4_test.c

/*
 * tester_c4_test.c - test DOC LAP cua Tester C4 cho ping_proto.c that (P1, FSM, an toan PA8).
 *
 * Hop dong: handoff/2026-09-21_c4-nucleo-laser-control/01_PLAN.md Vong 5 "Tieu chi Tester hieu luc"
 * T1-T4 va docs/design/NUCLEO_PROTOCOL.md (Q3). HAL gia rieng cua Tester: test/tester_c4_hal.c
 * (ghi lich su PA8: muc cao ngoai CAPTURING la vi pham). Kiem them moi dong phan hoi P1:
 * checksum dung, dai <= 64 byte ke ca LF, ma loi thuoc bang Q3 muc 3.
 *
 * Chay (Git Bash, tu firmware/stm32/NucleoPing; <TMP> la thu muc tam bat ky):
 *   /d/MinGW/bin/gcc -std=c99 -Wall -Wextra -O0 -Itest/fake -ICore/Inc -DFW_GIT_HASH='"hosttest"' \
 *     test/tester_c4_test.c test/tester_c4_hal.c Core/Src/ping_proto.c -o <TMP>/tester_c4_test.exe
 *   <TMP>/tester_c4_test.exe
 * Thoat 0 khi khong co kich ban FAIL. NOTE la ghi nhan, khong tinh FAIL. Khong phai thu tren bo.
 */
#include "ping_proto.h"
#include "fw_version.h"

#include <stdio.h>
#include <stdlib.h>
#include <string.h>

void sim_reset(int door, int estop, uint32_t rcc_flags, uint32_t tick, int pa8_before, int with_iwdg);
void sim_set_inputs(int door, int estop);
void sim_set_tick(uint32_t t);
void sim_poll(void);
void sim_rx(const char *bytes, int n);
void sim_rx_error(void);
int sim_take_tx(char *buf, int cap);
int sim_pa8(void);
int sim_pa8_after_early(void);
uint32_t sim_pa8_violations(void);
const char *sim_viol_note(void);
uint32_t sim_iwdg_refresh(void);
const char *sim_state(void);
const char *sim_last_err(void);

#define F_IWDG 0x01u
#define F_POR  0x02u

static char g_tx[8192];
static int g_scen_fail, g_scen_note;
static int n_pass, n_fail, n_note;
static char g_summary[64][160];
static int g_nsum;
static const char *g_sid;
static uint32_t g_viol_total;
static char g_viol_note[256];

/* ---- kiem moi dong phan hoi P1 ---- */
static const char *Q3_CODES[] = {"TOOLONG", "BADFRAME", "BADCHK", "UNKNOWN", "BADARG", "NOTIMPL", "OVERRUN",
                                 "BUSY", "NOT_HOMED", "RANGE", "LASER_ON", "IN_ERROR", "DOOR_OPEN", "ESTOP",
                                 "HOME_TIMEOUT", "HOME_STEPS", "LINK_LOST", "LASER_TIMEOUT", "WDG_RESET", NULL};
static int a_lines, a_badchk, a_toolong, a_badcode;
static char a_note[512];

static int hexv(char c)
{
  if (c >= '0' && c <= '9') return c - '0';
  if (c >= 'A' && c <= 'F') return c - 'A' + 10;
  return -1;
}

static void audit_line(const char *s, size_t len)
{
  char line[160];
  size_t i;
  const char *star, *e;
  unsigned chk = 0;
  if (len == 0 || s[0] < '0' || s[0] > '9') return;   /* chi dong P1 (bat dau bang seq) */
  a_lines++;
  if (len >= sizeof(line)) len = sizeof(line) - 1;
  memcpy(line, s, len);
  line[len] = 0;
  if (len + 1u > 64u) {
    a_toolong++;
    snprintf(a_note + strlen(a_note), sizeof(a_note) - strlen(a_note), "[dai %u: %s] ", (unsigned)(len + 1u), line);
  }
  star = strrchr(line, '*');
  if (!star || strlen(star) != 3 || hexv(star[1]) < 0 || hexv(star[2]) < 0) {
    a_badchk++;
    snprintf(a_note + strlen(a_note), sizeof(a_note) - strlen(a_note), "[khung sai: %s] ", line);
    return;
  }
  for (i = 0; line + i < star; i++) chk ^= (unsigned char)line[i];
  if (chk != (unsigned)(hexv(star[1]) * 16 + hexv(star[2]))) {
    a_badchk++;
    snprintf(a_note + strlen(a_note), sizeof(a_note) - strlen(a_note), "[checksum sai: %s] ", line);
  }
  /* chi xet phan hoi dang '<seq> ERROR <ma>' (khong nham trang thai ERROR trong 'DONE ERROR ...') */
  e = strchr(line, ' ');
  if (e && strncmp(e, " ERROR ", 7) != 0) e = NULL;
  if (e) {
    char code[32];
    int k = 0, found = 0;
    e += 7;
    while (*e && *e != ' ' && *e != '*' && k < 31) code[k++] = *e++;
    code[k] = 0;
    for (k = 0; Q3_CODES[k]; k++) if (strcmp(Q3_CODES[k], code) == 0) found = 1;
    if (!found) {
      a_badcode++;
      snprintf(a_note + strlen(a_note), sizeof(a_note) - strlen(a_note), "[ma khong co trong Q3: %s] ", line);
    }
  }
}

static const char *take(void)
{
  const char *p, *nl;
  sim_take_tx(g_tx, (int)sizeof(g_tx));
  for (p = g_tx; (nl = strchr(p, '\n')) != NULL; p = nl + 1) audit_line(p, (size_t)(nl - p));
  return g_tx;
}

/* ---- khung kiem ---- */
static void scen(const char *sid, const char *title)
{
  g_sid = sid;
  g_scen_fail = g_scen_note = 0;
  printf("\n---- %s %s\n", sid, title);
}

static void scen_end(const char *title, int note_only)
{
  const char *st = g_scen_fail ? "FAIL" : (note_only ? "NOTE" : "PASS");
  if (g_scen_fail) n_fail++; else if (note_only) n_note++; else n_pass++;
  printf("==== %s %s\n", g_sid, st);
  if (g_nsum < 64) snprintf(g_summary[g_nsum++], 160, "%-8s  %-4s  %s", g_sid, st, title);
}

static void ok(int cond, const char *label, const char *got)
{
  char g[200];
  size_t i;
  snprintf(g, sizeof(g), "%s", got ? got : "");
  for (i = 0; g[i]; i++) if (g[i] == '\n') g[i] = '|';
  printf("  [%s] %s%s%s\n", cond ? "OK  " : "FAIL", label, g[0] ? "  | " : "", g);
  if (!cond) g_scen_fail = 1;
}

static void note(const char *label, const char *got)
{
  char g[200];
  size_t i;
  snprintf(g, sizeof(g), "%s", got ? got : "");
  for (i = 0; g[i]; i++) if (g[i] == '\n') g[i] = '|';
  printf("  [NOTE] %s  | %s\n", label, g);
  g_scen_note = 1;
}

/* ---- tien ich ---- */
static void mkframe(char *out, size_t cap, const char *body)
{
  unsigned chk = 0;
  const char *p;
  for (p = body; *p; p++) chk ^= (unsigned char)*p;
  snprintf(out, cap, "%s*%02X\n", body, chk);
}

static const char *send_raw(const char *bytes)
{
  sim_rx(bytes, (int)strlen(bytes));
  sim_poll();
  return take();
}

static const char *p1(unsigned seq, const char *cmd)
{
  char body[160], fr[200];
  snprintf(body, sizeof(body), "%u %s", seq, cmd);
  mkframe(fr, sizeof(fr), body);
  return send_raw(fr);
}

/* Phan hoi P1 mong doi cho "<seq> <body>" (co checksum va LF) */
static const char *expect(unsigned seq, const char *body)
{
  static char out[200];
  char b[160];
  snprintf(b, sizeof(b), "%u %s", seq, body);
  mkframe(out, sizeof(out), b);
  return out;
}

static void at(uint32_t t)
{
  sim_set_tick(t);
  sim_poll();
  take();
}

static void boot(int door, int estop, uint32_t tick)
{
  g_viol_total += sim_pa8_violations();
  if (sim_pa8_violations() && !g_viol_note[0]) snprintf(g_viol_note, sizeof(g_viol_note), "%s", sim_viol_note());
  sim_reset(door, estop, F_POR, tick, 0, 1);
  take();
}

static int starts(const char *s, const char *pre) { return strncmp(s, pre, strlen(pre)) == 0; }
static int is_state(const char *st) { return strcmp(sim_state(), st) == 0; }
static int has(const char *s, const char *sub) { return strstr(s, sub) != NULL; }

static char g_buf[256];
static const char *fmt_state(void)
{
  snprintf(g_buf, sizeof(g_buf), "state=%s last_err=%s PA8=%d", sim_state(), sim_last_err(), sim_pa8());
  return g_buf;
}

/* ================================================================ */
static void t1(void)
{
  const char *r;
  scen("T1", "binh thuong: frame P1 dung checksum, LASER ON/OFF, STATUS, PING/ID? ke thua, BOOT");
  g_viol_total += sim_pa8_violations();
  sim_reset(1, 0, F_POR, 1000, 0, 1);
  r = take();
  ok(starts(r, "BOOT NucleoPing " FW_VERSION " hosttest"), "BOOT co phien ban firmware", r);
  ok(strcmp(FW_VERSION, "0.2.0") == 0, "FW_VERSION tang len 0.2.0", FW_VERSION);
  ok(has(r, " P1"), "BOOT co danh dau giao thuc 'P1' (Q3 muc 1: 'BOOT NucleoScan <fw_ver> <git> P1')", r);
  r = p1(1, "STATUS");
  ok(strcmp(r, expect(1, "DONE IDLE 0 0 1 0 0 1000 NONE 0")) == 0, "1 STATUS -> DONE IDLE 0 0 1 0 0 <uptime> NONE 0 (Q3/D039: 10 token, remaining_ms cuoi)", r);
  r = p1(2, "LASER ON");
  ok(strcmp(r, expect(2, "DONE ON 5000")) == 0 && sim_pa8() == 1 && is_state("CAPTURING"),
     "2 LASER ON (cua dong, estop nha) -> DONE ON 5000, PA8 cao, CAPTURING", r);
  r = p1(3, "STATUS");
  ok(strcmp(r, expect(3, "DONE CAPTURING 0 1 1 0 0 1000 NONE 5000")) == 0, "3 STATUS khi CAPTURING ngay sau ON: laser=1, remaining_ms=5000", r);
  r = p1(4, "LASER OFF");
  ok(strcmp(r, expect(4, "DONE OFF 0")) == 0 && sim_pa8() == 0 && is_state("IDLE"), "4 LASER OFF -> DONE OFF 0, PA8 thap, IDLE", r);
  r = send_raw("PING 7\n");
  ok(strcmp(r, "PONG 7 1000\n") == 0, "ke thua: PING 7 -> PONG 7 <uptime>", r);
  r = send_raw("ID?\n");
  ok(strcmp(r, "ID NUCLEO-F446RE NucleoPing 0.2.0 hosttest\n") == 0, "ke thua: ID? mang phien ban C4", r);
  r = send_raw("PING 4294967296\n");
  ok(strcmp(r, "ERR badarg\n") == 0, "ke thua: PING tran uint32 -> ERR badarg (R07 con)", r);
  {
    char fr[200];
    mkframe(fr, sizeof(fr), "5 STATUS");
    fr[strlen(fr) - 1] = 0;
    strcat(fr, "\r\n");
    r = send_raw(fr);
    ok(starts(r, "5 DONE IDLE "), "frame P1 ket thuc CRLF duoc nhan (CR bo qua)", r);
  }
  scen_end("binh thuong: frame P1 dung checksum, LASER ON/OFF, STATUS, PING/ID? ke thua, BOOT", 0);
}

static void padded_frame(char *out, size_t cap, unsigned seq, int total_chars)
{
  /* frame "<seq> HEARTBEAT   ...*HH" dai dung total_chars ky tu (chua ke LF) */
  char body[128];
  int blen = total_chars - 3, n;
  n = snprintf(body, sizeof(body), "%u HEARTBEAT", seq);
  while (n < blen && n < (int)sizeof(body) - 1) body[n++] = ' ';
  body[n] = 0;
  mkframe(out, cap, body);
}

static void t2(void)
{
  const char *r;
  char fr[200];
  int k;
  uint32_t bases[3] = {1000u, 700000u, 0xFFFFF000u};
  scen("T2", "bien: seq 1/65535/0/65536, dong 64 byte ke ca LF, timeout 2999/3000 va 4999/5000 ms (3 moc tick, co tran uint32)");
  boot(1, 0, 1000);
  r = p1(1, "HEARTBEAT");
  ok(strcmp(r, expect(1, "DONE IDLE")) == 0, "seq 1 hop le", r);
  r = p1(65535, "HEARTBEAT");
  ok(strcmp(r, expect(65535, "DONE IDLE")) == 0, "seq 65535 hop le", r);
  r = p1(0, "LASER ON");
  ok(has(r, " ERROR ") && sim_pa8() == 0 && is_state("IDLE"), "seq 0 LASER ON -> bi tu choi, PA8 thap", r);
  r = p1(65536, "LASER ON");
  ok(has(r, " ERROR ") && sim_pa8() == 0 && is_state("IDLE"), "seq 65536 LASER ON -> bi tu choi, PA8 thap", r);
  padded_frame(fr, sizeof(fr), 70, 63);
  r = send_raw(fr);
  ok(starts(r, "70 DONE IDLE*"), "dong 63 ky tu + LF = 64 byte ke ca LF: duoc xet", r);
  padded_frame(fr, sizeof(fr), 71, 64);
  r = send_raw(fr);
  ok(starts(r, "0 ERROR TOOLONG*"), "dong 64 ky tu + LF = 65 byte ke ca LF: > 64 -> 0 ERROR TOOLONG (Q3 muc 1 'toi da 64 byte ke ca LF')", r);
  padded_frame(fr, sizeof(fr), 72, 65);
  r = send_raw(fr);
  ok(starts(r, "0 ERROR TOOLONG*"), "dong 65 ky tu + LF: 0 ERROR TOOLONG", r);
  r = p1(73, "HEARTBEAT");
  ok(starts(r, "73 DONE IDLE*"), "sau TOOLONG nhan lenh moi binh thuong", r);

  for (k = 0; k < 3; k++) {
    uint32_t t0 = bases[k];
    char lab[160];
    /* a. im lang: LINK_LOST tai 3000 ms */
    boot(1, 0, t0);
    p1(10, "LASER ON");
    at(t0 + 2999u);
    snprintf(lab, sizeof(lab), "moc %lu: khong ban tin, +2999 ms: van CAPTURING, PA8 cao", (unsigned long)t0);
    ok(is_state("CAPTURING") && sim_pa8() == 1, lab, fmt_state());
    at(t0 + 3000u);
    snprintf(lab, sizeof(lab), "moc %lu: +3000 ms: PA8 thap, ERROR LINK_LOST", (unsigned long)t0);
    ok(is_state("ERROR") && sim_pa8() == 0 && strcmp(sim_last_err(), "LINK_LOST") == 0, lab, fmt_state());
    /* b. heartbeat moi 1000 ms, khong ON moi: LASER_TIMEOUT tai 5000 ms */
    boot(1, 0, t0);
    p1(20, "LASER ON");
    sim_set_tick(t0 + 1000u); p1(21, "HEARTBEAT");
    sim_set_tick(t0 + 2000u); p1(22, "HEARTBEAT");
    sim_set_tick(t0 + 3000u); p1(23, "HEARTBEAT");
    sim_set_tick(t0 + 4000u); p1(24, "HEARTBEAT");
    at(t0 + 4999u);
    snprintf(lab, sizeof(lab), "moc %lu: heartbeat 1 s, +4999 ms: con trong han laser, PA8 cao", (unsigned long)t0);
    ok(is_state("CAPTURING") && sim_pa8() == 1, lab, fmt_state());
    at(t0 + 5000u);
    snprintf(lab, sizeof(lab), "moc %lu: +5000 ms: PA8 thap, IDLE, last_err LASER_TIMEOUT", (unsigned long)t0);
    ok(is_state("IDLE") && sim_pa8() == 0 && strcmp(sim_last_err(), "LASER_TIMEOUT") == 0, lab, fmt_state());
    r = p1(25, "STATUS");
    snprintf(lab, sizeof(lab), "moc %lu: STATUS bao IDLE ... LASER_TIMEOUT", (unsigned long)t0);
    ok(starts(r, "25 DONE IDLE 0 0 1 0 0 ") && has(r, " LASER_TIMEOUT 0*"), lab, r);
    /* c. LASER ON moi (seq moi) dat lai han 5 s; HEARTBEAT khong */
    boot(1, 0, t0);
    p1(30, "LASER ON");
    sim_set_tick(t0 + 1000u); p1(31, "HEARTBEAT");
    sim_set_tick(t0 + 2000u); p1(32, "HEARTBEAT");
    sim_set_tick(t0 + 3000u); p1(33, "LASER ON");
    sim_set_tick(t0 + 4000u); p1(34, "HEARTBEAT");
    sim_set_tick(t0 + 5000u); p1(35, "HEARTBEAT");
    sim_set_tick(t0 + 6000u); p1(36, "HEARTBEAT");
    sim_set_tick(t0 + 7000u); p1(37, "HEARTBEAT");
    at(t0 + 7999u);
    snprintf(lab, sizeof(lab), "moc %lu: LASER ON moi o +3000 dat lai han: +7999 con cao", (unsigned long)t0);
    ok(is_state("CAPTURING") && sim_pa8() == 1, lab, fmt_state());
    at(t0 + 8000u);
    snprintf(lab, sizeof(lab), "moc %lu: +8000 PA8 thap LASER_TIMEOUT", (unsigned long)t0);
    ok(is_state("IDLE") && sim_pa8() == 0, lab, fmt_state());
  }
  {
    /* d. poll moi 1 ms: PA8 doi muc dung mot lan, tai dung +5000 */
    uint32_t t0 = 5000u, t, t_off = 0;
    int flips = 0, prev;
    boot(1, 0, t0);
    p1(40, "LASER ON");
    prev = sim_pa8();
    for (t = t0 + 1u; t <= t0 + 6000u; t++) {
      sim_set_tick(t);
      if ((t - t0) % 1000u == 0u && t - t0 < 5000u) {
        p1(41u + (t - t0) / 1000u, "HEARTBEAT");
      } else {
        sim_poll();
        take();
      }
      if (sim_pa8() != prev) { flips++; t_off = t; prev = sim_pa8(); }
    }
    snprintf(g_buf, sizeof(g_buf), "so lan doi muc %d, tat tai +%lu ms", flips, (unsigned long)(t_off - t0));
    ok(flips == 1 && t_off == t0 + 5000u, "poll moi 1 ms (heartbeat 1 s): PA8 doi muc dung 1 lan tai +5000 ms", g_buf);
  }
  scen_end("bien: seq 1/65535/0/65536, dong 64 byte ke ca LF, timeout 2999/3000 va 4999/5000 ms (3 moc tick, co tran uint32)", 0);
}

static void t3(void)
{
  const char *r;
  char fr[200], first[200];
  int i, same;
  scen("T3", "dau vao loi: sai XOR, thieu/thua doi so, lenh la, mat byte UART, trung seq 10 lan");
  boot(1, 0, 1000);
  /* sai XOR */
  r = send_raw("30 LASER ON*00\n");
  ok(has(r, "ERROR BADCHK") && sim_pa8() == 0 && is_state("IDLE"), "sai XOR -> ERROR BADCHK, khong bat, van IDLE", r);
  /* Q3 muc 3: BADCHK la loi ban tin, KHONG doi trang thai -> khong duoc ghi vao bo nho chong lap */
  r = p1(30, "LASER ON");
  ok(strcmp(r, expect(30, "DONE ON 5000")) == 0 && sim_pa8() == 1,
     "gui lai dung checksum cung seq 30 sau BADCHK: phai THUC THI (BADCHK khong duoc thanh 'phan hoi da luu')", r);
  p1(31, "LASER OFF");
  boot(1, 0, 1000);
  p1(31, "LASER ON");
  r = send_raw("32 LASER OFF*00\n");
  ok(has(r, "ERROR BADCHK") && sim_pa8() == 1, "LASER OFF sai XOR: khong thuc thi (dung), PA8 van cao", r);
  r = p1(32, "LASER OFF");
  ok(strcmp(r, expect(32, "DONE OFF 0")) == 0 && sim_pa8() == 0,
     "PC gui lai LASER OFF cung seq 32, checksum dung: PA8 PHAI ve thap ngay (khong cho 5 s)", r);
  if (sim_pa8()) p1(39, "LASER OFF");
  boot(1, 0, 1000);
  r = p1(33, "LASER ON");
  snprintf(first, sizeof(first), "%s", r);
  r = send_raw("33 RAC*00\n");
  r = p1(33, "LASER ON");
  ok(strcmp(r, first) == 0, "khung hong mang seq 33 (= seq hop le cuoi) khong duoc ghi de phan hoi da luu cua 33", r);
  p1(34, "LASER OFF");
  /* mat byte: checksum phat hien */
  mkframe(fr, sizeof(fr), "35 LASER ON");
  memmove(&fr[6], &fr[7], strlen(&fr[7]) + 1);   /* bo 1 byte ('A' cua LASER) */
  r = send_raw(fr);
  ok(has(r, "ERROR") && sim_pa8() == 0 && is_state("IDLE"), "mat 1 byte trong khung (LSER ON): khong thanh lenh hop le", r);
  /* thieu/thua doi so, lenh la */
  {
    const char *bad[] = {"LASER", "LASER ON X", "LASER BLINK", "STATUS X", "HEARTBEAT 1", "STOP 1", "CLEAR 1", NULL};
    for (i = 0; bad[i]; i++) {
      char lab[120];
      r = p1(40u + (unsigned)i, bad[i]);
      snprintf(lab, sizeof(lab), "'%s' -> ERROR BADARG, khong doi trang thai", bad[i]);
      ok(has(r, " ERROR BADARG*") && sim_pa8() == 0 && is_state("IDLE"), lab, r);
    }
  }
  r = p1(50, "FIRE");
  ok(has(r, "50 ERROR UNKNOWN*") && is_state("IDLE"), "lenh la FIRE -> ERROR UNKNOWN", r);
  r = p1(51, "laser on");
  ok(has(r, "51 ERROR UNKNOWN*") && sim_pa8() == 0, "chu thuong 'laser on' -> ERROR UNKNOWN, khong bat", r);
  mkframe(fr, sizeof(fr), "LASER ON");
  r = send_raw(fr);
  ok(has(r, " ERROR ") && sim_pa8() == 0, "khung khong co seq 'LASER ON*hh' -> tu choi", r);
  /* mat byte UART (loi UART giua khung) -> Q3 muc 3: OVERRUN, khong ghep */
  sim_rx("60 LASER ", 9);
  sim_rx_error();
  mkframe(fr, sizeof(fr), "60 LASER ON");
  sim_rx(strchr(fr, 'O'), (int)strlen(strchr(fr, 'O')));
  sim_poll();
  r = take();
  ok(sim_pa8() == 0 && is_state("IDLE"), "loi UART giua khung P1: khong bat laser, khong doi trang thai", r);
  ok(starts(r, "0 ERROR OVERRUN*"), "loi UART giua khung P1: phan hoi theo Q3 muc 3 '0 ERROR OVERRUN*hh'", r);
  r = p1(61, "HEARTBEAT");
  ok(starts(r, "61 DONE IDLE*"), "sau mat byte: lenh ke tiep binh thuong", r);
  /* trung seq 10 lan */
  {
    uint32_t t0 = 20000u;
    boot(1, 0, t0);
    r = p1(70, "LASER ON");
    snprintf(first, sizeof(first), "%s", r);
    same = 1;
    for (i = 1; i <= 10; i++) {
      sim_set_tick(t0 + 400u * (uint32_t)i);
      r = p1(70, "LASER ON");
      if (strcmp(r, first) != 0) same = 0;
    }
    ok(same, "70 LASER ON gui lai 10 lan (t0+400..4000 ms): 10 phan hoi y het phan hoi dau", first);
    at(t0 + 4999u);
    ok(sim_pa8() == 1, "sau 10 lan trung: +4999 ms con cao (dung han tu lan dau)", fmt_state());
    at(t0 + 5000u);
    ok(sim_pa8() == 0 && is_state("IDLE"), "+5000 ms tinh tu lan DAU: PA8 thap (trung seq khong dat lai hen gio)", fmt_state());
    same = 1;
    for (i = 0; i < 10; i++) {
      r = p1(70, "LASER ON");
      if (strcmp(r, first) != 0 || sim_pa8() != 0) same = 0;
    }
    ok(same, "sau khi da tat: 10 lan '70 LASER ON' chi gui lai phan hoi cu, khong bat lai", fmt_state());
  }
  scen_end("dau vao loi: sai XOR, thieu/thua doi so, lenh la, mat byte UART, trung seq 10 lan", 0);
}
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
