hungmap0312/3D-Scanner/pc/test_c5a_contract.py

#!/usr/bin/env python3
"""Tester C5a Vong 2 - kiem doc lap ho so Q3/Q4 `/capture_fresh` (handoff/2026-09-21_c5a-s3-fresh-capture).

Vong 2 chi la ho so thiet ke, khong co ma san pham. Test nay kiem phan MAY KIEM DUOC cua D1-D5
(01_PLAN.md Vong 2 muc 5); phan doc noi dung con lai la checklist thu cong trong 03_TEST.md.

- D1: ancestry, pham vi diff tu base, firmware/ va pc/ khong doi tai B.
- D2: bam lai thu vien/header driver dang cai; tu phan tich ma may `libespressif__esp32-camera.a`
      (xtensa readelf/objdump cua core 3.3.11) de biet ham nao gan timestamp va `esp_camera_fb_get()`
      chan toi da bao lau; doi chieu voi loi ho so ghi.
- D3: dinh dang header thoi gian cua firmware dang co va quy tac phan tich cua ho so.
- D5: quy tac tang Frame ID giua ho so Q3, D041 va 02_BUILD.
- D6 (Tester Vong 4, 01_PLAN Vong 3 muc 5): R01 chuoi nguon goc driver (index -> zip -> versions.txt ->
      manifest lib-builder -> revision esp32-camera) va dau van tay ma may; doi chieu trich dan nguon/ma may
      cua bang muc 2.2; cau dan xuat ve doi so 4000 tick; R02 cau C2; R03 so sach va tai hien so lieu test cu;
      R05 mo hinh buffer neo vao nguon (D6.17-D6.18); R06 dinh chinh duong dan header (D6.19).
      Can mang de clone nguon (hoac C5A_SRC tro toi thu muc co san esp32-camera/ va lib-builder/).

Khong mo COM/HTTP, khong nap bo, khong sua tep san pham.

Chay tu goc repo (Git Bash):
  .venv/Scripts/python.exe pc/test_c5a_contract.py
C5A_PHASE: q6 (mac dinh; ma Q6, 01_PLAN Vong 5, base e92867e) hoac q3 (ho so Q3/Q4 Vong 2-4, base 64d67a8).
Moc mac dinh q6 (Tester Vong 23): C5A_B cc16b13, C5A_B_PREV 502ea45 (B Coder vong truoc), C5A_H_PREV f1b7211
(H Tester Vong 22), C5A_P d3b2d20 (ke hoach Vong 7/8), C5A_BASE e92867e. Vong dau sau P (H truoc nam truoc P): luot Coder
la P..B; tu vong sua thu 2 (P nam truoc H truoc): luot Coder la H truoc..B. Ke hoach moi nhat tai P la Vong 6 thi
luot Coder (P..B hoac H truoc..B) kiem theo danh sach trang Vong 6 muc 3 (hep hon Vong 5); ke hoach Vong 7/8 theo
danh sach trang goi A Vong 7 muc 3. Moc q3: B 1a26df9, B_PREV 1b3b239, H_PREV 187cdf9, P 2ed9a75,
BASE 64d67a8. C5A_SRC (ban clone nguon co san; bo trong thi tu clone vao thu muc tam),
ARDUINO15 (mac dinh %LOCALAPPDATA%/Arduino15). Thoat 0 khi khong co kiem FAIL.
"""
import hashlib
import json
import os
import re
import shutil
import stat
import subprocess
import sys
import tempfile
import zipfile
from datetime import datetime, timezone
from pathlib import Path

REPO = Path(__file__).resolve().parent.parent
PHASE = os.environ.get("C5A_PHASE", "q6")
Q3 = PHASE == "q3"   # q3: chang ho so (firmware bat bien); q6: chang ma (01_PLAN Vong 5)
_DEF = {True: ("64d67a84572ffbfdf559d8dc5496b89106d99098", "1a26df9c4f896fad6e286f2e1c02b4c6485ee547",
               "1b3b239a22dba68ea0899d746be53d576365e788", "187cdf90ce2837a82e6d5accdf13dd863e7fd7f3",
               "2ed9a75cc5d8a93b0811fb04d01fe64d8d3cfa80"),
        False: ("e92867eecf5eaad308ab1a222069de07d964e6fb", "5092910b23dbffeb50eed751fca362f96efb2d9b",
                "6f6948f868c007915217bb26c06dfc63bea42c0f", "4f6123e6eaf1434adb22cbe57e3672e797208304",
                "7ce9475033130d8288b2e030e5e65bb844155f2d")}[Q3]
R03_SRC = "1a26df9c4f896fad6e286f2e1c02b4c6485ee547"   # Q6: vong 02_BUILD chua doi chieu R03 (B cuoi chang Q3)
BASE = os.environ.get("C5A_BASE", _DEF[0])
B = os.environ.get("C5A_B", _DEF[1])
# ban 02_BUILD.md cua lan ban giao Coder gan nhat (01_PLAN Vong 3 muc 5: kiem bao toan toan ban, khong chi Vong 1)
B_PREV = os.environ.get("C5A_B_PREV", _DEF[2])
A15 = Path(os.environ.get("ARDUINO15", os.path.join(os.environ.get("LOCALAPPDATA", ""), "Arduino15")))
LIBS = A15 / "packages/esp32/tools/esp32s3-libs/3.3.11"
XT = A15 / "packages/esp32/tools/esp-x32/2601/bin"
CAM_A = LIBS / "lib/libespressif__esp32-camera.a"
CAM_H = LIBS / "include/espressif__esp32-camera/driver/include/esp_camera.h"
DOC = "docs/design/S3_FRESH_CAPTURE.md"
SKETCH = "firmware/esp32s3/CameraWebServerTest/"
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
