hungmap0312/3D-Scanner/(commit log)

2026-10-12 docs: [Q6/Q9] exclude internal agent and user handover records
    [BOM_may_quet_3D_ESP32_CAM_ESP32_S3.xlsx, frames.csv, partitions.csv, per_image.csv]
2026-10-13 docs: sync merged progress 12-13 Oct (P03 FD5640 camera evaluation, hardware notes, roadmap, procedures)
    Source: development main d632fa0 (since f98ade4). Includes FD5640 evaluation logs per user decision 13 Oct.
    [frames.csv, manifest_images_sha256.csv, per_image.csv]
