hungmap0312/3D-Scanner/docs/logs/c2-bo-tri-v8/20260928_1117/20260928_113217.jpg

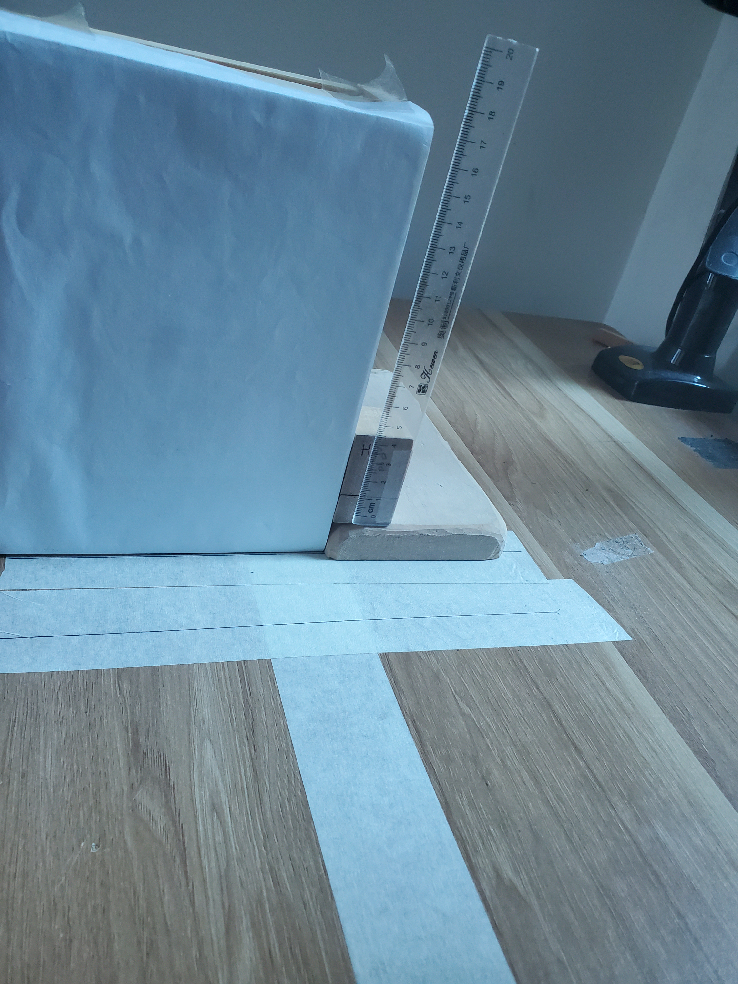
docs/logs/c2-bo-tri-v8/20260928_1117/20260928_113217.jpg
